Birkemosen/lune/lune-v6/docs/Manual.md

# Lune V6 Manual

Installer- and operator-facing guide for the local web UI. The `?` help in the UI links
here. Deep engineering notes stay in the other files under [`docs/`](./).

Lune V6 is a **local 6-zone hydronic manifold controller**. It stays safe without
Lune Touch: motors, endstops, temperature freshness, and command clamps run on
the device. Touch may send setpoints and weather preload; it never chooses the
zone for room temperatures.

<!-- toc -->
**[The web UI](#the-web-ui)**

**[Home](#home)**

**[Zone sheet](#zone-sheet)**

- [Settings › Comfort and Room](#settings--comfort-and-room)
- [Settings › Floor and Weather](#settings--floor-and-weather)
- [Settings › Advanced](#settings--advanced)
- [Motor fault: reset guide](#motor-fault-reset-guide)

**[Manifold sheet](#manifold-sheet)**

- [Settings › Manifold](#settings--manifold)
- [Settings › Heating mode and Heat pump limits](#settings--heating-mode-and-heat-pump-limits)
- [Settings › Preheat absorption and balancing](#settings--preheat-absorption-and-balancing)

**[System](#system)**

- [Device](#device)
- [Motors](#motors)
- [Connections](#connections)
- [Firmware and backup](#firmware-and-backup)
- [Service](#service)
- [Motor drivers: on, off and recovery](#motor-drivers-on-off-and-recovery)
- [Motor lab (dev builds)](#motor-lab-dev-builds)

**[External room temperatures (ingest)](#external-room-temperatures-ingest)**

**[Notifications through Home Assistant](#notifications-through-home-assistant)**

**[Safety principles](#safety-principles)**
<!-- /toc -->

---

## The web UI

The UI has three places, following the Lune design system:

- **Home** — what is happening now: heat, comfort per zone, faults. Nothing to save.
- **Sheets** — one per thing: a sheet per **zone** (Z1–Z6) and one for the **manifold**.
  A sheet slides in over Home and has the tabs **Overview**, **History** and **Settings**.
  Settings for that one thing live in its sheet.
- **System** — the device itself and its connections: identity, manifold and motors,
  Lune Touch and Wi-Fi, firmware and backup, service.

The **zone strip** at the top opens a zone's sheet; the **System** tile opens the manifold
sheet. The **device menu** (logo) shows identity (name, location, IP, MAC, firmware,
ESPHome, uptime), **Copy diagnostics**, and other Lune devices on the LAN.

Each settings tab and System category has one save bar at the bottom: **Undo** and **Save**.
Switches save immediately; leaving with unsaved changes asks first. Links can point
straight at a place, for example `#z3/settings` or `#system/connections`.

---

## Home

- **Status line** — number of zones, how many call for heat, faults.
- **Fault panel** — appears when a zone has a motor fault; the button opens that zone.
- **Motors are off** — appears when the motor drivers are off, with the cause
  (turned off by you, firmware update, hardware fault, start-up) and **Turn motors on**.
  See [Motor drivers](#motor-drivers-on-off-and-recovery).
- **Heat now** — manifold supply, return, ΔT, total flow and the last 24 hours.
  **Open manifold** opens the manifold sheet.
- **Comfort by zone** — temperature against target for each zone over 24 hours, with
  the loop's flow; with 8 probes also the zone's own return. A card opens the zone's sheet.

The first tile in the strip, **Manifold**, shows supply and return and opens the
manifold sheet.

The zone tiles show temperature, a chip with the distance to target (blue below,
neutral near, orange above) and the valve opening in five steps.

---

## Zone sheet

**Overview** — temperature and target (− / + saves by itself), opening, return,
motor state, preheat advance, weather offset, temperature source, and the fault panel
with the [reset guide](#motor-fault-reset-guide) when the motor has latched a fault. A grouped member zone shows
which zone it follows and opens that one; its target is locked.

**History** — the last 24 hours and a 6-hour projection.

### Settings › Comfort and Room

**Comfort**: target and **Zone enabled** (saves immediately).

**Room**: name, area and temperature source (**probe** or **BLE**, with scan and
assign). With 8 return probes, the zone's return probe is chosen here.

The floor **area** sets the zone's share of the flow, so set the real heated floor area. A
new zone has none: until it is set, the control uses the mean area of the other zones and
the problem list shows «area not set».

External Wi‑Fi room temperatures (Shelly / Home Assistant / Homey) map
`sensor_id` → zone **only on V6**. Producers never send a zone index. See
[external room temperature](./external_room_temperature.md).

### Settings › Floor and Weather

**Floor**: pipe spacing and type, slab, covering and thickness. **Weather**: exterior
walls, wind and solar factors. These feed local physics and Touch preload.

### Settings › Advanced

**Motor and calibration** (subpage): learned open/close ripples and factors, preheat
advance and the last fault (in plain words, never the raw firmware code).

**Grouping** (subpage): **Group with** merges loops into one room — shared target,
valves open together.

**Reset and relearn** (last on the tab, asks first) wipes calibration and runs
end-stop learning again — the zone will not heat normally until learning finishes.

Details: [endstop detection](./endstop_detection.md).

### Motor fault: reset guide

When a motor latches a fault, only that zone stops; the other five keep running. The
zone's Overview shows what happened in plain words and a short guide:

| Fault | What it means |
|---|---|
| The motor stalled | Stopped under load before the end stop: a stuck valve pin or a crooked actuator. |
| The motor found no end stop | Ran past its whole stroke: the actuator may not sit fully down on the valve. |
| Fault signal from the motor driver | The driver reported overcurrent while running, most often when the motor breaks loose. |
| No connection to the motor | No current: check cable and socket. |
| Motor current too high / driver too hot | Check that the pin moves freely; let the driver cool. |
| Did not reach the end stop in time | Check the actuator. |

**Before you reset**: the actuator sits fully down and straight on the valve, the cable is
fully in its socket, and the valve pin can move. Then look at the valve and choose
**The valve is**: *Closed*, *Middle*, *Open* or *Not sure*. On a normally open (NO)
manifold the valve is closed when the plunger is pressed down.

**Did the motor run too far?** If the motor pushed the plunger past the seat (*found no end
stop*) or got stuck, **Drive the motor back** runs it for 5, 10 or 20 s away from the
direction it faulted in — after an overrun while closing, that brings the plunger back up.
End-stop detection stays armed, and the zone stays blocked until you reset the fault. A
blocked zone accepts no other motor runs. Watch the plunger move, then choose where the
valve stands.

The choice is used when you press **Reset fault**:

- **Closed** or **Open** — V6 takes that as its known position. The next move runs from
  there without first driving to the end stop, so a motor that is already seated does not
  have to push against the seat again.
- **Middle** or **Not sure** — V6 re-homes towards closed before the next move, as it
  does after any fault.

A fault that clears by itself is not shown again: the first clean move after a reset (or
after a restart) removes it.

**Remembered position**: V6 stores each motor's position and uses it after a restart. Before
it opens from an unknown datum it re-homes towards closed. If the seat comes earlier than
the remembered position says, V6 takes it as the seat (the log says *seated … early*); if a
closing run passes the whole stroke without meeting the seat, the zone is blocked with
**The motor found no end stop** — check that the actuator sits on the valve. That block survives a restart, so V6 does not push another full stroke on every boot.

**Breakaway**: a motor that has stood still for a long time can draw a short current
spike when it starts, most often right after reversing from the closed seat. V6 waits
half a second between the closing and opening legs of a re-home, and a driver fault in
the first 200 ms of a run is retried up to three times per hour before the zone is
blocked. Each retry and each block is logged with which fault line fired.

---

## Manifold sheet

**Overview** — supply, return, ΔT and total flow; the **balancing** table with
the current mode; **Live readings** of every 1-Wire probe, each labelled with what it is
assigned to (a zone, the manifold's supply or return, or not assigned), so wiring can
be checked.

**History** — supply and return over the last 24 hours.

### Settings › Manifold

Valve type (**NO** / **NC**) and which 1-Wire probes measure manifold supply and
return. That drives ΔT on the manifold tile and the direction motors must run. The choice
must match the valve inserts: with **NO** the valve is open when the plunger is up;
a wrong choice makes every zone run inverted.

**Probe layout**: **2 probes** — shared supply/return on the manifold. **8 probes** —
a return sensor per zone for finer diagnostics and commissioning; assign each zone's
return in its sheet under Settings › Room. Check the wiring with **Live readings** under
Overview before saving the layout. A probe can only have one role: choosing one that a zone
or the manifold already uses is refused, and the message names who holds it.
1-Wire probes read at 12 bit (0.0625 °C).

### Settings › Heating mode and Heat pump limits

**Normal** vs **Heat pump**, plus an optional minimum total opening across
accepting loops (0 disables; normal mode only).

**Heat pump: dynamic balancing** ([design](dynamic_balancing.md)). The manifold works
like a statically balanced installation whose balancing valves follow the rooms:

- Every loop has flow all the time. Its share is its design share (the hydraulic
  balance: area, heat loss, floor, pipe, loop length, plus the learned correction).
  The most demanding loop is fully open; the others are throttled to their share.
- A room's share follows its temperature: full share one comfort band below target,
  falling to a quarter at target + **overheat margin** (default 1.0 °C).
- Inside the manifold warm rooms hand their flow to cold ones and the total stays put.
  The manifold's total follows its most demanding room: full while one room is a comfort
  band below target, less when every room on the manifold is warm.
- A loop closes only when its room is past target + comfort band + overheat margin (more
  while Touch pre-buffers), and reopens 0.3 °C below that. Its flow goes to the other
  loops. The manifold never closes every loop.
- The heat comes from the supply temperature. V6 tells Touch to **raise** it when a room
  has been below target − comfort band for 20 minutes, and to **lower** it when no room
  has been below target for 30 minutes.

With every loop open, the circulation pump sets the total flow: set it once so the
secondary flow is about 105–125 % of the heat pump's (Touch shows the buffer balance).

**Normal mode: reopening ahead.** A floor answers 1–3 hours after its valve opens, so a
closed room that waited for its thermometer would keep falling well below target. A loop
closed because its room is warm therefore reopens on the temperature *expected one floor
lag ahead*: the room's measured fall (°C/h, over 30-minute steps) times the floor lag
(about 1.5 h for 8 cm concrete, 1 h for screed, less for dry systems, plus about 0.4 h
for parquet and 0.6 h for carpet). The longer the loop has been closed, the longer the
lag counts (up to twice after 4 hours), because the slab has given up more of its heat.
The loop reopens 0.2 °C below setpoint instead of at setpoint − comfort band, after at
least 20 minutes closed. It closes again if the room turns warm (0.2 °C hysteresis). A
steady room reopens on its measured temperature.

Default local mode is heat pump.

### Settings › Preheat absorption and balancing

**Preheat absorption** (switch saves immediately) with its band and delta.

**Balancing mode**: **Static** uses only the hydraulic priors (area, pipe spacing, pipe
type, supply length). **Adaptive** also learns from how each room behaves, at most
±0.02 per hour and within 0.5–1.5 of the prior. The mode is shown on the balancing
table.

Balancing *between* manifolds (for example 20 mm PEX on one floor and 16 mm on the
other) is done by Lune Touch (house balance); the factor it sends shows as
`house_balance` and scales this manifold's openings. **Reset balancing** (last on the tab, asks first) forgets learned
factors for all zones and returns to priors.

Coordinator-owned whole-house learning (Touch / Mini) may override strategy; V6
still clamps locally. See [adaptive balancing](./adaptive_balancing.md) for the
algorithm notes.

---

## System

### Device

**Device identity**: display name and location, shown in the device menu and to Lune Touch.

**BLE clock**: when enabled, V6 continuously emits Shelly Date/Time Broadcast (~one
packet every 2 s) **concurrently with BLE scan**, so BLU displays can set their clock
without NTP. Automatic display sync is typically once per day.

**Sync now** refreshes the beacon timestamp immediately. To force a display:
press once to enter setup (`SEt`), then press twice rapidly. Bluetooth must be
on (hold ~5 s to toggle if needed).

### Motors

Motor drivers can be disabled to electrically disconnect all six actuators
(see [Motor drivers](#motor-drivers-on-off-and-recovery)). Saving this panel never
changes the drivers. Default motor profile and max run time apply until a zone has
learned its own stroke.

**Advanced** (subpages **Close end stop**, **Open end stop**, **Relearning**): expert
endstop limits in the firmware's units. They are commissioning defaults — once
learned, per-zone factors take over. **Relearn all** (last, asks first) restarts
learning for every zone.

Further reading: [endstop detection](./endstop_detection.md),
[hydraulic commissioning](./hydraulic_commissioning.md).

### Connections

**Lune Touch**: approve or revoke Touch control of this manifold. Discovery alone never
grants authority. Without approval, V6 stays fully local and conservative. The actions
shown follow the state (approve, cancel, retry, revoke); technical IDs are on a subpage.

Touch may deliver **weather preload**, **setpoints**, **absorb arming**, and a
**heating mode** override while its lease is active. Zone exposure (walls, wind,
solar) is set in each zone's sheet under Settings › Weather — not here.

**WiFi**: shows the network V6 is on and lets you move it to another one (for example
after changing the router password). Enter the network name and password and
press **Change network**. If the new network does not connect within 30 seconds,
V6 goes back to the current one. The setting survives firmware updates.

If V6 cannot reach its network at all, it opens the setup network
**Lune V6 Setup** after 5 minutes. Join it and open http://192.168.4.1 to pick a
network and enter its password.

**External room temperatures**: how BYO hubs send room temperatures — see
[below](#ingest).

### Firmware and backup

**Firmware**: check for updates, install from the network, or upload a `.bin` /
`.ota.bin`. Valves hold position across reboot (~10 s), and V6 remembers each motor's
last position, so after a restart it knows roughly how far each valve is from its seat.
An update turns the drivers off only while it installs; they come back on by themselves.
Prefer release builds for production.

**Backup**: export or import settings as JSON (import asks first). Secrets and
authority keys are never included. Learned motor ripples/factors are optional — leave
them out when moving config to a replacement board that should relearn.

### Service

**Diagnostics**: live CPU, heap and PSRAM. Task dump, I²C scan and 1-Wire dump write
into the device log for installers.

**Device logs**: streaming device log. Pause, clear or download when diagnosing faults.
Newest lines first.

**Manual motor control**: turns off automatic control of **all** zones until disabled.
Drive to a valve position, or run a timed open/close (1–45 s, subpage **Timed run**)
with endstop detection still armed. Leaving manual mode on leaves the house without
closed-loop heating.

**Device actions** (last, each asks first): **reset probe map** (re-assign every probe)
and **restart**. Identity lives under System › Device, not here.

### Motor drivers: on, off and recovery

The drivers stay on unless there is a critical fault or you turn them off.

- **One motor in fault** blocks only its own zone. The driver is re-armed after 0.1 s
  and the other zones keep running.
- **Off** happens only when a fault line stays asserted after re-arming (a short or a
  power fault), during a firmware update, or when you switch them off.
- **Recovery**: when V6 turned the drivers off itself, it tries to turn them back on,
  first after 60 s and then with doubling waits up to 30 minutes. Drivers you turned off
  stay off until you turn them on.

Home shows **Motors are off** with the cause while they are off. Diagnostics include the
cause, how long they have been off and how many recoveries have run.

### Motor lab (dev builds)

Stroke capture on one motor, development firmware only (release images hide it).

1. **Arm** pauses automatic control for every zone (manual mode) and turns the motor
   drivers on.
2. **Seat the valve** closes until the pin is seated, so the opening stroke starts from a
   known end.
3. **Record the opening stroke**, then 4. **the closing stroke**, each run for the motor
   profile's run time; end-stop detection stops the motor earlier.

**Manual move** runs a timed open or close (1–45 s) with end-stop detection on, once the
lab is armed. **Live** shows current, mean, peak, runtime, ripples, stroke phase, when the
pin was met and the drivers. The **motor current** chart covers the whole stroke: the
browser merges successive reads of the device's trace ring (~13 s) while the motor runs,
with the stroke phases underneath and cadence and slope as layers. **Download CSV** saves
the trace. **Emergency stop** stops every motor and turns the drivers off; the sequence
starts over. **Finish and resume control** turns manual mode off. Leaving the page does
not, so finish before you go.

**End stop on the stroke** replays the latest recording (or the Rev 3.3 reference trace)
through the firmware's end-stop logic, tick by tick: the current with the dynamic
threshold (dashed) and the absolute caps (dotted), a marker where each path would stop the
motor (solid for the one that stops first), the trailing rise on a closing stroke, and a
table of every path with its threshold, time and counts. It is exact about the logic, not
the noise: the firmware runs on finer frames than the trace. A recorded stroke also gives a
suggested close or open factor (**Use suggestion** puts it in the form).

The **thresholds** below (closing, opening and ceiling, absolute caps) replay in the chart
as you change them; **Save thresholds** writes only what changed to V6.

**Valve curve** shows the selected zone's flow against opening as the control uses it:
measured by Lune Touch (with the date) or the default curve, with the valve's position now.

---

## External room temperatures (ingest)

BYO hubs POST to `/api/v1/room-temperatures`. Example:

```http
POST /api/v1/room-temperatures
X-Lune-CSRF: 1
Content-Type: application/json

{"sensor_id":"living-room","celsius":21.4}
```

Full contract and hub recipes: [external room temperature](./external_room_temperature.md),
[API v1](./lv6_api_v1.md).

---

## Notifications through Home Assistant

V6 reports problems to Home Assistant, which sends them to your phone:

- **Valve**: motor fault, motor stalled, valve learning failed (after 10 min).
- **Sensor**: no room temperature for 30 min (for a zone with a probe, BLE
  sensor or external sensor set up), flow or return probe on the manifold
  missing for 30 min.
- **Battery** of a BLE sensor bound to a zone: 15 % or less (warning), 5 % or
  less (error); cleared at 25 %.
- **Humidity** from a BLE sensor bound to a zone: above 60 % or below 40 % for
  an hour; cleared at 58 % / 42 %.

Each problem is reported when it starts and when it is gone, at most once an hour.
Zones that are switched off are not reported. Without Home Assistant, V6 keeps
working as before.

To get the notifications:

1. In Home Assistant, open **Settings › Devices & services › ESPHome**, choose
   the Lune V6 device, open **Configure** and turn on **Allow the device to
   perform Home Assistant actions**. Without it, Home Assistant drops the events.
2. Import the Lune notifications blueprint from
   [`lune_notifications.yaml`](https://github.com/Birkemosen/lune-coordinator/blob/main/homeassistant/blueprints/automation/lune/lune_notifications.yaml) (see [`homeassistant/README.md`](https://github.com/Birkemosen/lune-coordinator/blob/main/homeassistant/README.md))
   and choose who gets which kind of problem.

The device also shows **Active problems** (count) and **Problems** (titles) as
entities, so a dashboard can show them without the blueprint. Texts are in Danish
for now. Contract: [notifications contract v1](../../shared/contracts/lune_notifications_contract_v1.md).

---

## Safety principles

1. V6 validates and clamps every command locally.
2. Stale room temperatures fail safe (valves conservative / maintenance).
3. Touch and hubs never pick the zone for a temperature sample — only `sensor_id`
   mapping on V6 does.
4. Destructive actions stay behind confirmation; identity stays in System › Device.

For firmware architecture and FreeRTOS layout see [ARCHITECTURE.md](./ARCHITECTURE.md).
