Birkemosen/lune/lune-v6/test/fixtures/motor-lab-z1-close-soft-seat-a.csv

t_ms | motion_count | current_ma | adc_current_raw | drive_on | direction_open | armed | stroke_phase | tacho_period_us | tacho_amp_raw
250 | 20 | 23.8 | 505.6666666666667 | 1 | 0 | 1 | 0 | 24858.97435897436 | 1210.4102564102564
750 | 65 | 23.3 | 495.72727272727275 | 1 | 0 | 1 | 0 | 11584.415584415585 | 1834.3116883116884
1250 | 109 | 23.1 | 490.1898734177215 | 1 | 0 | 1 | 0 | 11402.93670886076 | 2298.2911392405063
1750 | 153 | 23.0 | 488.78205128205127 | 1 | 0 | 1 | 0 | 11331.153846153846 | 2151.474358974359
2250 | 198 | 22.9 | 484.88461538461536 | 1 | 0 | 1 | 0 | 11418.78205128205 | 1997.9358974358975
2750 | 245 | 22.9 | 483.63157894736844 | 1 | 0 | 1 | 0 | 11456 | 2531.5789473684213
3250 | 292 | 22.9 | 477.8253968253968 | 1 | 0 | 1 | 0 | 11015.809523809523 | 1859.5555555555557
3750 | 336 | 22.9 | 487.06349206349205 | 1 | 0 | 1 | 0 | 11103.174603174602 | 2374.5873015873017
4250 | 382 | 22.9 | 487.875 | 1 | 0 | 1 | 0 | 11359.375 | 2103.671875
4750 | 426 | 22.8 | 488.03225806451616 | 1 | 0 | 1 | 0 | 11403.209677419354 | 2351.016129032258
5250 | 472 | 22.8 | 482.61290322580646 | 1 | 0 | 1 | 0 | 11079.241935483871 | 2264.016129032258
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
