Birkemosen/lune/lune-v6/test/fixtures/motor-lab-z1-close.csv

t_ms | motion_count | current_ma | adc_current_raw | drive_on | direction_open | armed | stroke_phase | tacho_period_us | tacho_amp_raw | bemf_raw_a | bemf_raw_b | bemf_differential_raw | bemf_separation_us | bemf_valid | bemf_moving | invalid_bemf_samples
250 | 23 | 24.8 | 524.921052631579 | 1 | 0 | 1 | 2 | 16578.947368421053 | 1465.157894736842 | 65535 | 65535 | 0 | 65535 | 0 | 0 | 0
750 | 66 | 24.4 | 518.9873417721519 | 1 | 0 | 1 | 2 | 11518.987341772152 | 2093.506329113924 | 65535 | 65535 | 0 | 65535 | 0 | 0 | 0
1250 | 109 | 24.3 | 515.3589743589744 | 1 | 0 | 1 | 2 | 12243.589743589744 | 2194.5128205128203 | 65535 | 65535 | 0 | 65535 | 0 | 0 | 0
1750 | 144 | 24.3 | 515.3846153846154 | 1 | 0 | 1 | 2 | 14679.48717948718 | 2319.6794871794873 | 65535 | 65535 | 0 | 65535 | 0 | 0 | 0
2250 | 179 | 24.2 | 513.1538461538462 | 1 | 0 | 1 | 2 | 15769.23076923077 | 2208.2820512820513 | 65535 | 65535 | 0 | 65535 | 0 | 0 | 0
2750 | 221 | 24.2 | 512.4871794871794 | 1 | 0 | 1 | 2 | 12179.48717948718 | 2251.75641025641 | 65535 | 65535 | 0 | 65535 | 0 | 0 | 0
3250 | 262 | 24.3 | 514.3333333333334 | 1 | 0 | 1 | 2 | 14166.666666666666 | 2289.1666666666665 | 65535 | 65535 | 0 | 65535 | 0 | 0 | 0
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
