Birkemosen/lune/(list of files, drawings)

Other design files:
lune-v6/hardware/lune-v6-rev3.3/EasyEdaPro/lune-v6-rev3.3.eprj
