Birkemosen/lune/lune-v6/components/lv6_dashboard/lv6_dashboard.cpp

#include "lv6_dashboard.h"
#include "control_summary.h"
#include <lwip/sockets.h>
#include "../lv6_zone_controller/absorb_command_logic.h"
#include "../lv6_zone_controller/hydraulic_diagnostics.h"
#include "../lv6_zone_controller/probe_mapping.h"
#include "../lv6_zone_controller/thermal_model.h"
#include "../lv6_config_store/group_model.h"
#include "esphome/components/lv6_ble_time_beacon/lv6_ble_time_beacon.h"
#include "esphome/components/nimble_hub/nimble_hub.h"
#include "settings_backup.h"
#ifdef USE_ESP32_CRASH_HANDLER
#include "esphome/components/esp32/crash_handler.h"
#endif

#include "esphome/core/log.h"
#include "esphome/core/version.h"
#ifdef USE_LOGGER
#include "esphome/components/logger/logger.h"
#endif
#include "esphome/components/wifi/wifi_component.h"
#ifdef USE_LUNE_WIFI
#include "esphome/components/lune_wifi/lune_wifi.h"
#endif
#ifdef USE_CAPTIVE_PORTAL
#include "esphome/components/captive_portal/captive_portal.h"
#endif
#include <algorithm>
#include <cctype>
#include <cmath>
#include <cstdio>
#include <cstdlib>
#include <cstring>
#include <cstdarg>
#include <ctime>
#include <new>
#include <esp_http_server.h>
#include <esp_heap_caps.h>
#include <esp_system.h>
#if defined(CONFIG_HEAP_TRACING_STANDALONE) || defined(CONFIG_HEAP_TRACING)
#include <esp_heap_trace.h>
#include <esp_memory_utils.h>
#endif

namespace esphome {
namespace lv6_dashboard {

static const char *const TAG = "lv6_dashboard";
static constexpr size_t STATIC_CHUNK_SIZE = 2048;

namespace {

/// Large scratch: PSRAM first, internal heap as fallback. free() routes back to
/// the correct heap for either allocation.
void *alloc_scratch(size_t bytes) {
  void *p = heap_caps_malloc(bytes, MALLOC_CAP_SPIRAM);
  return p != nullptr ? p : malloc(bytes);
}

// Append formatted text without ever committing a truncated write. A partial
// vsnprintf into a chunk buffer used to leave a NUL mid-payload; chunked HTTP
// then shipped that NUL and the dashboard failed to parse /api/v1/state.
bool appendfv(char *buffer, size_t capacity, size_t &offset, const char *fmt, va_list args) {
  if (offset >= capacity)
    return false;

  va_list probe;
  va_copy(probe, args);
  const int need = vsnprintf(nullptr, 0, fmt, probe);
  va_end(probe);
  if (need < 0)
    return false;
  // Keep one byte for the C terminator vsnprintf writes; it is not part of offset.
  if (offset + static_cast<size_t>(need) >= capacity)
    return false;

  const int written = vsnprintf(buffer + offset, capacity - offset, fmt, args);
  if (written < 0 || written != need)
    return false;

  offset += static_cast<size_t>(written);
  return true;
}

bool appendf(char *buffer, size_t capacity, size_t &offset, const char *fmt, ...) {
  va_list args;
  va_start(args, fmt);
  const bool ok = appendfv(buffer, capacity, offset, fmt, args);
  va_end(args);
  return ok;
}

// Every code `send_v1_` can emit must appear here: an unmapped code silently
// becomes 500, and the dashboard branches on the exact status. A missing 403
// masked CSRF rejection as a server error.
const char *http_status_line(int code) {
  switch (code) {
    case 200: return "200 OK";
    case 204: return "204 No Content";
    case 400: return "400 Bad Request";
    case 403: return "403 Forbidden";
    case 404: return "404 Not Found";
    case 405: return "405 Method Not Allowed";
    case 409: return "409 Conflict";
    case 429: return "429 Too Many Requests";
    case 503: return "503 Service Unavailable";
    default: return "500 Internal Server Error";
  }
}

bool is_dashboard_js_url(const char *url) {
  if (url == nullptr) return false;
  static constexpr const char PATHS[][16] = {"/dashboard.js", "/binder.js"};
  for (const char *path : PATHS) {
    const size_t path_len = strlen(path);
    if (strncmp(url, path, path_len) == 0 && (url[path_len] == '\0' || url[path_len] == '?'))
      return true;
  }
  return false;
}

bool is_ui_css_url(const char *url) {
  static constexpr const char PATH[] = "/lune-ui.css";
  static constexpr size_t PATH_LEN = sizeof(PATH) - 1;
  return url != nullptr && strncmp(url, PATH, PATH_LEN) == 0 &&
         (url[PATH_LEN] == '\0' || url[PATH_LEN] == '?');
}

bool is_lang_html_url(const char *url, const char *lang) {
  if (url == nullptr || lang == nullptr) return false;
  char path[8];
  snprintf(path, sizeof(path), "/%s/", lang);
  const size_t path_len = strlen(path);
  if (strncmp(url, path, path_len) == 0)
    return url[path_len] == '\0' || strcmp(url + path_len, "index.html") == 0 ||
           url[path_len] == '?';
  // Also accept /en and /da without trailing slash.
  char bare[6];
  snprintf(bare, sizeof(bare), "/%s", lang);
  return strcmp(url, bare) == 0;
}

const char *pick_ui_lang(AsyncWebServerRequest *request) {
  const auto cookie = request->get_header("Cookie");
  if (cookie.has_value()) {
    const char *c = strstr(cookie->c_str(), "lune_lang=");
    if (c != nullptr) {
      c += 10;
      if (strncmp(c, "da", 2) == 0) return "da";
      if (strncmp(c, "en", 2) == 0) return "en";
    }
  }
  const auto accept = request->get_header("Accept-Language");
  if (accept.has_value()) {
    const char *a = accept->c_str();
    const char *da = strstr(a, "da");
    const char *en = strstr(a, "en");
    if (da && (!en || da < en)) return "da";
  }
  return "en";
}


// Append `s` as the body of a JSON string (without surrounding quotes),
// escaping the characters JSON requires. Control chars become spaces.
void append_json_escaped(char *buffer, size_t capacity, size_t &offset, const char *s) {
  for (const char *p = s; p != nullptr && *p != '\0'; ++p) {
    if (offset + 2 >= capacity)
      return;
    const unsigned char c = static_cast<unsigned char>(*p);
    if (c == '"' || c == '\\') {
      buffer[offset++] = '\\';
      buffer[offset++] = static_cast<char>(c);
    } else if (c < 0x20) {
      buffer[offset++] = ' ';
    } else {
      buffer[offset++] = static_cast<char>(c);
    }
  }
}

void format_float_token(char *buffer, size_t capacity, float value, int decimals = 1) {
  if (!std::isfinite(value)) {
    snprintf(buffer, capacity, "null");
    return;
  }

  long scale = 1;
  for (int i = 0; i < decimals; i++)
    scale *= 10;

  const long scaled = lroundf(value * static_cast<float>(scale));
  const long whole = scaled / scale;
  const long fraction = std::labs(scaled % scale);

  if (decimals <= 0) {
    snprintf(buffer, capacity, "%ld", whole);
    return;
  }

  char frac_fmt[8];
  snprintf(frac_fmt, sizeof(frac_fmt), "%%0%dld", decimals);
  char frac_buf[16];
  snprintf(frac_buf, sizeof(frac_buf), frac_fmt, fraction);
  snprintf(buffer, capacity, "%ld.%s", whole, frac_buf);
}

void format_pairing_fingerprint(const char *mac, char *buffer, size_t capacity) {
  if (capacity == 0)
    return;
  size_t off = 0;
  off += snprintf(buffer + off, capacity - off, "lv6-");
  for (const char *p = mac; p != nullptr && *p != '\0' && off + 1 < capacity; ++p) {
    char c = *p;
    if (c >= 'A' && c <= 'F')
      c = static_cast<char>(c - 'A' + 'a');
    if ((c >= '0' && c <= '9') || (c >= 'a' && c <= 'f'))
      buffer[off++] = c;
  }
  buffer[off] = '\0';
  if (std::strcmp(buffer, "lv6-") == 0)
    std::strncpy(buffer, "lv6-unknown", capacity - 1);
  buffer[capacity - 1] = '\0';
}

void sanitize_text(const std::string &src, char *buffer, size_t capacity) {
  if (capacity == 0)
    return;

  size_t out = 0;
  for (size_t i = 0; i < src.size() && out + 1 < capacity; i++) {
    const char c = src[i];
    buffer[out++] = (c == '"' || c == '\\') ? '_' : c;
  }
  buffer[out] = '\0';
}

// --- minimal JSON field extractors for POST body ---

static bool json_get_str(const char *body, const char *field, char *out, size_t out_len) {
  char pat[48];
  snprintf(pat, sizeof(pat), "\"%s\"", field);
  const char *p = strstr(body, pat);
  if (!p) return false;
  p += strlen(pat);
  while (*p == ' ') p++;
  if (*p != ':') return false;
  p++;
  while (*p == ' ') p++;
  if (*p != '"') return false;
  p++;
  const char *end = strchr(p, '"');
  if (!end) return false;
  const size_t len = std::min(static_cast<size_t>(end - p), out_len - 1);
  memcpy(out, p, len);
  out[len] = '\0';
  return true;
}

static bool json_get_num(const char *body, const char *field, float *out) {
  char pat[48];
  snprintf(pat, sizeof(pat), "\"%s\"", field);
  const char *p = strstr(body, pat);
  if (!p) return false;
  p += strlen(pat);
  while (*p == ' ') p++;
  if (*p != ':') return false;
  p++;
  while (*p == ' ') p++;
  if (*p == '"' || *p == '{' || *p == '[') return false;
  char *end;
  const float v = strtof(p, &end);
  if (end == p) return false;
  *out = v;
  return true;
}

static bool json_get_u32(const char *body, const char *field, uint32_t *out) {
  char pat[48];
  snprintf(pat, sizeof(pat), "\"%s\"", field);
  const char *p = strstr(body, pat);
  if (!p) return false;
  p += strlen(pat);
  while (*p == ' ') p++;
  if (*p != ':') return false;
  p++;
  return lv6_authority::parse_u32_text(p, out);
}

static bool json_get_bool(const char *body, const char *field, bool *out) {
  char pat[48];
  snprintf(pat, sizeof(pat), "\"%s\"", field);
  const char *p = strstr(body, pat);
  if (!p) return false;
  p += strlen(pat);
  while (*p == ' ') p++;
  if (*p != ':') return false;
  p++;
  while (*p == ' ') p++;
  if (strncmp(p, "true", 4) == 0) {
    *out = true;
    return true;
  }
  if (strncmp(p, "false", 5) == 0) {
    *out = false;
    return true;
  }
  float num = 0.0f;
  if (json_get_num(body, field, &num)) {
    *out = std::fabs(num) > 0.001f;
    return true;
  }
  return false;
}

// --- string → enum parsers ---

static bool parse_probe_option(const char *raw, int8_t *out) {
  if (strcasecmp(raw, "None") == 0) { *out = lv6::PROBE_UNASSIGNED; return true; }
  int n = 0;
  if (sscanf(raw, "Probe %d", &n) == 1 && n >= 1 && n <= static_cast<int>(lv6::MAX_PROBES)) {
    *out = static_cast<int8_t>(n - 1);
    return true;
  }
  return false;
}

static bool parse_temp_source(const char *raw, lv6::TempSource *out) {
  if (strcasecmp(raw, "Local Probe") == 0 || strcasecmp(raw, "probe") == 0) {
    *out = lv6::TempSource::LOCAL_PROBE;
    return true;
  }
  if (strcasecmp(raw, "BLE") == 0 || strcasecmp(raw, "BLE Sensor") == 0) {
    *out = lv6::TempSource::BLE_SENSOR;
    return true;
  }
  if (strcasecmp(raw, "External") == 0 || strcasecmp(raw, "EXTERNAL") == 0 ||
      strcasecmp(raw, "External (Wi-Fi)") == 0 || strcasecmp(raw, "External (Wi‑Fi)") == 0) {
    *out = lv6::TempSource::EXTERNAL;
    return true;
  }
  return false;
}

static const char *device_display_name_cstr(const lv6::SystemConfig &sys) {
  return sys.display_name[0] != '\0' ? sys.display_name : "Lune V6";
}

static void json_escape_cstr(const char *in, char *out, size_t out_len) {
  if (out_len == 0)
    return;
  size_t o = 0;
  for (size_t i = 0; in[i] != '\0' && o < out_len - 2; i++) {
    char c = in[i];
    if (c == '"' || c == '\\') {
      if (o + 2 >= out_len)
        break;
      out[o++] = '\\';
    }
    out[o++] = (c >= 0x20) ? c : ' ';
  }
  out[o] = '\0';
}

static const char *temp_source_to_dashboard_str(lv6::TempSource src) {
  switch (src) {
    case lv6::TempSource::LOCAL_PROBE:
      return "Local Probe";
    case lv6::TempSource::BLE_SENSOR:
      return "BLE";
    case lv6::TempSource::EXTERNAL:
      return "External";
    default:
      return "Local Probe";
  }
}

static const char *pipe_type_to_api_str(lv6::PipeType type) {
  switch (type) {
    case lv6::PipeType::PEX_12X2: return "PEX_12X2";
    case lv6::PipeType::PEX_14X2: return "PEX_14X2";
    case lv6::PipeType::PEX_16X2: return "PEX_16X2";
    case lv6::PipeType::PEX_17X2: return "PEX_17X2";
    case lv6::PipeType::PEX_18X2: return "PEX_18X2";
    case lv6::PipeType::PEX_20X2: return "PEX_20X2";
    case lv6::PipeType::ALUPEX_16X2: return "ALUPEX_16X2";
    case lv6::PipeType::ALUPEX_20X2: return "ALUPEX_20X2";
    default: return "UNKNOWN";
  }
}

static const char *motor_profile_to_api_str(lv6::MotorProfile profile) {
  switch (profile) {
    case lv6::MotorProfile::INHERIT: return "INHERIT";
    case lv6::MotorProfile::GENERIC: return "GENERIC";
    case lv6::MotorProfile::HMIP_VDMOT: return "HMIP_VDMOT";
    default: return "UNKNOWN";
  }
}

static bool parse_pipe_type(const char *raw, lv6::PipeType *out) {
  struct { const char *s; lv6::PipeType v; } map[] = {
    {"PEX 12mm", lv6::PipeType::PEX_12X2}, {"PEX 12x2", lv6::PipeType::PEX_12X2},
    {"PEX 14mm", lv6::PipeType::PEX_14X2}, {"PEX 14x2", lv6::PipeType::PEX_14X2},
    {"PEX 16mm", lv6::PipeType::PEX_16X2}, {"PEX 16x2", lv6::PipeType::PEX_16X2},
    {"PEX 17mm", lv6::PipeType::PEX_17X2}, {"PEX 17x2", lv6::PipeType::PEX_17X2},
    {"PEX 18mm", lv6::PipeType::PEX_18X2}, {"PEX 18x2", lv6::PipeType::PEX_18X2},
    {"PEX 20mm", lv6::PipeType::PEX_20X2}, {"PEX 20x2", lv6::PipeType::PEX_20X2},
    {"ALUPEX 16mm", lv6::PipeType::ALUPEX_16X2}, {"ALUPEX 16x2", lv6::PipeType::ALUPEX_16X2},
    {"ALUPEX 20mm", lv6::PipeType::ALUPEX_20X2}, {"ALUPEX 20x2", lv6::PipeType::ALUPEX_20X2},
  };
  for (const auto &e : map) {
    if (strcasecmp(raw, e.s) == 0) { *out = e.v; return true; }
  }
  return false;
}

static bool parse_motor_profile(const char *raw, lv6::MotorProfile *out) {
  if (strcasecmp(raw, "Inherit") == 0) { *out = lv6::MotorProfile::INHERIT; return true; }
  if (strcasecmp(raw, "Generic") == 0) { *out = lv6::MotorProfile::GENERIC; return true; }
  if (strcasecmp(raw, "HmIP VdMot") == 0 || strcasecmp(raw, "HMIP_VDMOT") == 0) { *out = lv6::MotorProfile::HMIP_VDMOT; return true; }
  return false;
}

}  // namespace

#ifndef LV6_DASHBOARD_ASSET_V
#define LV6_DASHBOARD_ASSET_V "dev"
#endif
#ifndef LV6_UI_ASSET_V
#define LV6_UI_ASSET_V LV6_DASHBOARD_ASSET_V
#endif

// Legacy fallback shell used only when LDS2 HTML assets are not embedded.
static const char DASHBOARD_HTML_FALLBACK[] =
    "<!doctype html><html><head>"
    "<meta charset=\"utf-8\">"
    "<meta name=\"viewport\" content=\"width=device-width,initial-scale=1\">"
    "<meta name=\"color-scheme\" content=\"light dark\">"
    "<link rel=\"icon\" href=\"data:,\">"
    "<title>Lune V6</title>"
    "<link rel=\"stylesheet\" href=\"/lune-ui.css?v=" LV6_UI_ASSET_V "\">"
    "</head><body>"
    "<p>Dashboard UI assets missing. Run <code>make dashboard-build</code>.</p>"
    "<script src=\"/binder.js?v=" LV6_DASHBOARD_ASSET_V "\"></script>"
    "</body></html>";

void LV6Dashboard::update_snapshot_() {
  // This function runs on ESPHome's loopTask.  DashboardSnapshot is several
  // kilobytes and used to be allocated here alongside temporary DeviceConfig
  // copies, exhausting loopTask during boot on 4 MB modules.  Reuse the
  // component-owned scratch buffer instead; it is never read by HTTP handlers.
  DashboardSnapshot &s = this->update_snap_buf_;
  memset(&s, 0, sizeof(s));

  s.uptime_s = millis() / 1000UL;
  // System diagnostics — per-core CPU load (sampled in loop()) + live heap.
  s.cpu0_pct = cpu0_pct_;
  s.cpu1_pct = cpu1_pct_;
  s.free_internal_kb = heap_caps_get_free_size(MALLOC_CAP_INTERNAL) / 1024;
  s.free_dma_kb = heap_caps_get_free_size(MALLOC_CAP_DMA) / 1024;
  s.largest_internal_kb = heap_caps_get_largest_free_block(MALLOC_CAP_INTERNAL) / 1024;
  s.min_internal_kb = heap_caps_get_minimum_free_size(MALLOC_CAP_INTERNAL) / 1024;
  s.free_psram_kb = heap_caps_get_free_size(MALLOC_CAP_SPIRAM) / 1024;
  s.largest_psram_kb = heap_caps_get_largest_free_block(MALLOC_CAP_SPIRAM) / 1024;
  {
    multi_heap_info_t info{};
    heap_caps_get_info(&info, MALLOC_CAP_INTERNAL);
    s.internal_allocated_kb = info.total_allocated_bytes / 1024;
    s.internal_free_blocks = info.free_blocks;
    s.internal_alloc_blocks = info.allocated_blocks;
  }

  if (this->nimble_hub_) {
    s.ble_hub_enabled = this->nimble_hub_->is_enabled();
    s.ble_scanning = this->nimble_hub_->scanning();
    s.ble_ads_per_sec = this->nimble_hub_->ads_per_sec();
    s.ble_last_adv_age_ms = this->nimble_hub_->last_adv_age_ms();
  }

  auto snap_float = [](sensor::Sensor *sns) -> float {
    return (sns && sns->has_state()) ? sns->state : NAN;
  };

  s.wifi_dbm          = snap_float(this->wifi_signal_sensor_);
  s.manifold_flow_c   = snap_float(this->manifold_flow_sensor_);
  s.manifold_return_c = snap_float(this->manifold_return_sensor_);
  for (uint8_t i = 0; i < 6; i++) {
    s.zone_temp_c[i]        = snap_float(this->zone_temp_sensors_[i]);
    s.zone_valve_pct[i]     = snap_float(this->zone_valve_sensors_[i]);
    s.zone_preheat_c[i]     = snap_float(this->zone_preheat_sensors_[i]);
    s.motor_open_ripple[i]  = snap_float(this->motor_open_ripple_sensors_[i]);
    s.motor_close_ripple[i] = snap_float(this->motor_close_ripple_sensors_[i]);
    s.motor_open_factor[i]  = snap_float(this->motor_open_factor_sensors_[i]);
    s.motor_close_factor[i] = snap_float(this->motor_close_factor_sensors_[i]);
    s.motor_working_ripple[i] = NAN;
    s.motor_pin_free_ripple[i] = NAN;
    s.motor_stroke_model[i] = 0;
    s.motor_learn_pct[i] = 0;
    s.motor_learn_phase[i] = 0;
    s.motor_learn_sample[i] = 0;
    s.motor_learn_samples_needed[i] = 0;
  }
  // Prefer live valve telemetry over the 10 s ESPHome template sensors so the
  // zone UI updates as soon as a relearn finishes (or fails).
  if (this->valve_controller_) {
    uint16_t fault_fp = 0;
    for (uint8_t i = 0; i < 6; i++) {
      const auto t = this->valve_controller_->get_telemetry(i);
      s.motor_open_ripple[i] = static_cast<float>(t.learned_open_ripples);
      s.motor_close_ripple[i] = static_cast<float>(t.learned_close_ripples);
      s.motor_open_factor[i] = t.learned_open_current_factor;
      s.motor_close_factor[i] = t.learned_close_current_factor;
      s.motor_working_ripple[i] = static_cast<float>(t.contact_to_stop_close_ripples);
      s.motor_pin_free_ripple[i] = static_cast<float>(t.pin_engage_close_ripples);
      s.motor_stroke_model[i] = static_cast<uint8_t>(t.stroke_model);
      const char *fault = lv6::fault_code_to_string(t.last_fault_code);
      std::strncpy(s.motor_fault[i], fault, sizeof(s.motor_fault[i]) - 1);
      s.motor_fault[i][sizeof(s.motor_fault[i]) - 1] = '\0';
      fault_fp = static_cast<uint16_t>((fault_fp * 33u) ^ static_cast<uint8_t>(t.last_fault_code));
    }
    if (fault_fp != this->last_motor_fault_fp_) {
      this->last_motor_fault_fp_ = fault_fp;
      if (this->runtime_revision_ != UINT32_MAX)
        this->runtime_revision_++;
    }
    const auto lp = this->valve_controller_->get_learning_progress();
    if (lp.zone < 6) {
      s.motor_learn_pct[lp.zone] = lp.pct;
      s.motor_learn_phase[lp.zone] = lp.phase;
      s.motor_learn_sample[lp.zone] = lp.sample;
      s.motor_learn_samples_needed[lp.zone] = lp.samples_needed;
    }
    const uint32_t packed = this->valve_controller_->get_learning_progress_packed();
    if (packed != this->last_learning_progress_packed_) {
      this->last_learning_progress_packed_ = packed;
      if (this->runtime_revision_ != UINT32_MAX)
        this->runtime_revision_++;
    }
  }
  for (uint8_t i = 0; i < 8; i++)
    s.probe_temp_c[i] = snap_float(this->probe_temp_sensors_[i]);

  auto snap_text = [](text_sensor::TextSensor *ts, char *out, size_t len) {
    if (ts && ts->has_state()) {
      sanitize_text(ts->state, out, len);
    } else {
      out[0] = '\0';
    }
  };
  snap_text(this->firmware_version_text_, s.firmware_version, sizeof(s.firmware_version));
  snap_text(this->ip_address_text_,       s.ip_address,       sizeof(s.ip_address));
  snap_text(this->connected_ssid_text_,   s.connected_ssid,   sizeof(s.connected_ssid));
  snap_text(this->mac_address_text_,      s.mac_address,      sizeof(s.mac_address));
  snap_text(this->reset_reason_text_,     s.reset_reason,     sizeof(s.reset_reason));
  for (uint8_t i = 0; i < 6; i++) {
    snap_text(this->zone_state_sensors_[i],  s.zone_state[i],  sizeof(s.zone_state[i]));
    // motor_fault[] is filled from live valve telemetry above when available.
    if (!this->valve_controller_)
      snap_text(this->motor_fault_sensors_[i], s.motor_fault[i], sizeof(s.motor_fault[i]));
  }

  s.drivers_enabled = this->valve_controller_ && this->valve_controller_->are_drivers_enabled();
  s.drivers_off_reason = this->valve_controller_ ? this->valve_controller_->drivers_off_reason() : "";
  s.drivers_off_age_s = this->valve_controller_ ? this->valve_controller_->drivers_off_age_s() : 0;
  s.drivers_recoveries = this->valve_controller_ ? this->valve_controller_->drivers_recoveries() : 0;

  // Touch authority is local coordination state only; heat-source transport is
  // owned by Lune Touch. Expiry is checked here so stale leases stop gating
  // local command handling without a second background task.
  if (this->config_store_) {
    s.authority = this->config_store_->get_authority_config();
    this->authority_.configure(s.authority.installation_id, s.authority.coordinator_id);
    this->authority_.expire_if_needed(millis());
    if (this->zone_controller_) {
      const auto auth_snap = this->authority_.snapshot(millis());
      this->zone_controller_->set_touch_authority_active(auth_snap.touch_lease_active);
      if (auth_snap.touch_lease_active && auth_snap.control_mode != lv6_authority::ControlMode::UNSET) {
        const auto mode = (auth_snap.control_mode == lv6_authority::ControlMode::NORMAL)
                              ? lv6::HeatingProfile::NORMAL
                              : lv6::HeatingProfile::HEAT_PUMP;
        this->zone_controller_->set_touch_control_mode(true, mode);
      } else {
        this->zone_controller_->set_touch_control_mode(false, lv6::HeatingProfile::HEAT_PUMP);
      }
    }
  }
  const auto authority_snapshot = this->authority_.snapshot(millis());
  strncpy(s.authority_state, lv6_authority::state_name(authority_snapshot.state), sizeof(s.authority_state) - 1);
  strncpy(s.authority_reason, authority_snapshot.last_reason, sizeof(s.authority_reason) - 1);
  s.authority_lease_remaining_s = authority_snapshot.remaining_ms / 1000UL;
  s.authority_generation = authority_snapshot.lease_generation;
  s.authority_v6_write_allowed = false;
  s.authority_state[sizeof(s.authority_state) - 1] = '\0';
  s.authority_reason[sizeof(s.authority_reason) - 1] = '\0';

  if (this->config_store_) {
    s.system                 = this->config_store_->get_config().system;
    s.probes                 = this->config_store_->get_probe_config();
    s.motor                  = this->config_store_->get_motor_config();
    s.manifold_type          = this->config_store_->get_manifold_type();
    s.simple_preheat_enabled = this->config_store_->get_simple_preheat_enabled();
    const auto ctrl_cfg = this->config_store_->get_config().control;
    s.preheat_absorb_enabled = ctrl_cfg.preheat_absorb_enabled;
    s.preheat_absorb_band_c  = ctrl_cfg.preheat_absorb_band_c;
    s.preheat_detect_delta_c = ctrl_cfg.preheat_detect_delta_c;
    s.heating_mode = ctrl_cfg.mode;
    s.hp_overheat_margin_c = ctrl_cfg.hp_overheat_margin_c;
    s.hp_base_pct = ctrl_cfg.hp_base_pct;
    s.hp_trim_floor_pct = ctrl_cfg.hp_trim_floor_pct;
    s.hp_close_above_c = ctrl_cfg.hp_close_above_c;
    s.hp_demand_pct = ctrl_cfg.hp_demand_pct;
    s.preheat_absorbing = this->zone_controller_ && this->zone_controller_->is_preheat_absorbing();
    s.absorb_mode = this->zone_controller_ ? this->zone_controller_->absorb_mode_code() : 0;
    if (this->zone_controller_) {
      std::strncpy(s.absorb_reason, this->zone_controller_->absorb_arm_reason(),
                   sizeof(s.absorb_reason) - 1);
      s.absorb_reason[sizeof(s.absorb_reason) - 1] = '\0';
      std::strncpy(s.absorb_end_reason, this->zone_controller_->absorb_arm_end_reason(),
                   sizeof(s.absorb_end_reason) - 1);
      s.absorb_end_reason[sizeof(s.absorb_end_reason) - 1] = '\0';
    } else {
      s.absorb_reason[0] = '\0';
      s.absorb_end_reason[0] = '\0';
    }
    if (this->zone_controller_) {
      s.effective_heating_mode = this->zone_controller_->get_effective_control_mode();
      s.heating_mode_from_touch = this->zone_controller_->is_touch_authority_active() &&
                                  this->zone_controller_->has_touch_control_mode();
      s.heat_demand = this->zone_controller_->get_heat_demand();
    } else {
      s.effective_heating_mode = ctrl_cfg.mode;
      s.heating_mode_from_touch = false;
      s.heat_demand = {};
    }
    for (uint8_t i = 0; i < lv6::NUM_ZONES; i++) {
      if (this->zone_controller_) {
        s.zone_loop_share_pct[i] = this->zone_controller_->get_loop_share_pct(i);
        s.zone_house_balance[i] = this->zone_controller_->get_house_balance(i);
        s.zone_absorb_capacity_rank[i] = this->zone_controller_->get_absorb_capacity_rank(i);
        s.zone_relative_kv[i] =
            this->zone_controller_->get_relative_kv(i, s.zone_valve_pct[i]);
        const auto zs = this->zone_controller_->get_zone_snapshot(i);
        s.zone_static_factor[i] = zs.static_factor;
        s.zone_balance_adapt[i] = zs.balance_adapt;
        s.zone_hydraulic_factor[i] = zs.hydraulic_factor;
      } else {
        s.zone_loop_share_pct[i] = NAN;
        s.zone_house_balance[i] = 1.0f;
        s.zone_absorb_capacity_rank[i] = 0;
        s.zone_relative_kv[i] = NAN;
        s.zone_static_factor[i] = NAN;
        s.zone_balance_adapt[i] = 1.0f;
        s.zone_hydraulic_factor[i] = NAN;
      }
    }
    s.authority              = this->config_store_->get_authority_config();
    s.balancing              = this->config_store_->get_config().balancing;
    s.min_zone_flow_pct      = s.balancing.secondary_min_total_opening_pct;
    s.minimum_flow_always    = s.balancing.secondary_flow_commissioning_enabled;
    for (uint8_t i = 0; i < lv6::NUM_ZONES; i++) {
      s.zones[i]            = this->config_store_->get_zone_config(i);
      s.zone_temp_source[i] = this->config_store_->get_zone_temp_source(i);
      this->config_store_->get_zone_ble_mac_str(i, s.zone_ble_mac[i], sizeof(s.zone_ble_mac[i]));
      const auto &sc = this->config_store_->get_config().sensor_config;
      strncpy(s.zone_sensor_id[i], sc.zone_sensor_id[i], sizeof(s.zone_sensor_id[i]) - 1);
      s.zone_sensor_id[i][sizeof(s.zone_sensor_id[i]) - 1] = '\0';
      strncpy(s.zone_sensor_name[i], sc.zone_sensor_name[i], sizeof(s.zone_sensor_name[i]) - 1);
      s.zone_sensor_name[i][sizeof(s.zone_sensor_name[i]) - 1] = '\0';
      s.zone_external_temp_age_ms[i] =
          this->zone_controller_ ? this->zone_controller_->get_zone_external_temp_age_ms(i)
                                 : UINT32_MAX;
      s.zone_battery_pct[i] =
          this->zone_controller_ ? this->zone_controller_->get_zone_battery_pct(i) : -1;
      s.zone_humidity_pct[i] =
          this->zone_controller_ ? this->zone_controller_->get_zone_humidity_pct(i) : NAN;
      if (s.zone_temp_source[i] == lv6::TempSource::BLE_SENSOR)
        s.ble_demanded = true;
    }
    if (this->config_store_->get_config().sensor_config.ble_clock_sync_enabled)
      s.ble_demanded = true;
  }

  if (this->ble_time_beacon_) {
    s.ble_clock_sync_enabled = this->ble_time_beacon_->enabled();
    s.ble_clock_sync_interval_min = this->ble_time_beacon_->interval_min();
    s.ble_clock_sync_last_ok_s = this->ble_time_beacon_->last_ok_s();
    strncpy(s.ble_clock_sync_last_error, this->ble_time_beacon_->last_error(),
            sizeof(s.ble_clock_sync_last_error) - 1);
    s.ble_clock_sync_last_error[sizeof(s.ble_clock_sync_last_error) - 1] = '\0';
    s.ble_clock_sync_advertising = this->ble_time_beacon_->advertising();
  } else if (this->config_store_) {
    const auto sensors = this->config_store_->get_config().sensor_config;
    s.ble_clock_sync_enabled = sensors.ble_clock_sync_enabled;
    s.ble_clock_sync_interval_min = sensors.ble_clock_sync_interval_min;
  }

  // Managed firmware update. The snapshot was memset above, so the status
  // string is always written here rather than relying on its member default.
  strncpy(s.firmware_update_status, "unknown", sizeof(s.firmware_update_status) - 1);
#ifdef LV6_HAS_UPDATE
  if (this->firmware_update_ != nullptr) {
    const char *status = "unknown";
    switch (this->firmware_update_->state) {
      case update::UPDATE_STATE_NO_UPDATE:  status = "no_update";  break;
      case update::UPDATE_STATE_AVAILABLE:  status = "available";  break;
      case update::UPDATE_STATE_INSTALLING: status = "installing"; break;
      default:                              status = "unknown";    break;
    }
    strncpy(s.firmware_update_status, status, sizeof(s.firmware_update_status) - 1);
    s.firmware_update_available = this->firmware_update_->state == update::UPDATE_STATE_AVAILABLE;
    sanitize_text(this->firmware_update_->update_info.current_version, s.firmware_update_current,
                  sizeof(s.firmware_update_current));
    sanitize_text(this->firmware_update_->update_info.latest_version, s.firmware_update_latest,
                  sizeof(s.firmware_update_latest));
  }
#endif
  s.firmware_update_status[sizeof(s.firmware_update_status) - 1] = '\0';

  // Notify the dashboard only when displayable live values change. Quantize so
  // sub-display noise does not bump runtime_revision every snapshot tick.
  {
    auto mix = [](uint32_t h, uint32_t v) -> uint32_t {
      h ^= v + 0x9e3779b9u + (h << 6) + (h >> 2);
      return h;
    };
    auto q_dc = [](float c) -> uint32_t {
      if (!std::isfinite(c)) return 0x7FFFu;
      long v = lroundf(c * 10.0f);  // 0.1 °C
      if (v < -2000) v = -2000;
      if (v > 2000) v = 2000;
      return static_cast<uint32_t>(v + 2000);
    };
    auto q_pct = [](float p) -> uint32_t {
      if (!std::isfinite(p)) return 0xFFu;
      long v = lroundf(p);
      if (v < 0) v = 0;
      if (v > 100) v = 100;
      return static_cast<uint32_t>(v);
    };
    uint32_t fp = 2166136261u;
    fp = mix(fp, q_dc(s.manifold_flow_c));
    fp = mix(fp, q_dc(s.manifold_return_c));
    for (uint8_t i = 0; i < 6; i++) {
      fp = mix(fp, q_dc(s.zone_temp_c[i]));
      fp = mix(fp, q_pct(s.zone_valve_pct[i]));
      fp = mix(fp, q_dc(s.zone_preheat_c[i]));
      // Zone state string → cheap length + first byte (enough for idle/heating/fault flips).
      fp = mix(fp, static_cast<uint32_t>(s.zone_state[i][0]) |
                       (static_cast<uint32_t>(strnlen(s.zone_state[i], 16)) << 8));
    }
    // Learning progress already bumps runtime_revision_ separately above —
    // keep it out of this fingerprint so idle clients are not woken every %.
    if (fp != this->last_live_telemetry_fp_) {
      this->last_live_telemetry_fp_ = fp;
      if (this->runtime_revision_ != UINT32_MAX)
        this->runtime_revision_++;
    }
  }

  if (xSemaphoreTake(snapshot_lock_, pdMS_TO_TICKS(5)) == pdTRUE) {
    memcpy(&this->snapshot_, &s, sizeof(s));
    this->snapshot_ready_ = true;
    xSemaphoreGive(snapshot_lock_);
  }
}

#if defined(CONFIG_HEAP_TRACING_STANDALONE) || defined(CONFIG_HEAP_TRACING)
// TEMPORARY — remove with packages/debug/heap-tracing.yaml after investigation.
//
// ESP-IDF heap_trace_dump() prints only via esp_rom_printf (UART ROM path). That
// bypasses ESPHome's logger callback, so dashboard / live-log views show the
// "--- heap_trace_dump ---" banner and then nothing. We dump through ESP_LOGI
// instead, skip malloc/heap_caps wrapper frames when picking an owner PC, and
// print a sample multi-frame PC stack for each top INTERNAL site.

namespace {

// Depth 8 → ~88 B/record with standalone TAILQ; 768 × 88 ≈ 66 KB in PSRAM.
constexpr size_t kHeapTraceRecords = 768;
constexpr size_t kHeapTraceTopSites = 24;
constexpr size_t kHeapTraceTopAllocs = 16;
constexpr uintptr_t kHeapWrapperWindow = 0x800;  // ~2 KB past each wrapper symbol

struct HeapTraceSiteAgg {
  void *owner_pc{nullptr};
  size_t bytes{0};
  size_t count{0};
  size_t max_bytes{0};
  void *sample_stack[CONFIG_HEAP_TRACING_STACK_DEPTH]{};
};

// Thin wrappers that usually own alloced_by[0] (and sometimes [1]) on Xtensa.
// Return addresses land a few bytes past the call site inside these functions.
extern "C" {
void *heap_caps_malloc(size_t size, uint32_t caps);
void *heap_caps_calloc(size_t n, size_t size, uint32_t caps);
void *heap_caps_realloc(void *ptr, size_t size, uint32_t caps);
void *heap_caps_aligned_alloc(size_t alignment, size_t size, uint32_t caps);
void *heap_caps_malloc_prefer(size_t size, size_t num, ...);
void *heap_caps_calloc_prefer(size_t n, size_t size, size_t num, ...);
void *pvPortMalloc(size_t xWantedSize);
void *__wrap_heap_caps_malloc_base(size_t size, uint32_t caps);
void *__wrap_heap_caps_realloc_base(void *ptr, size_t size, uint32_t caps);
void *__wrap_heap_caps_aligned_alloc_base(size_t alignment, size_t size, uint32_t caps);
}

bool pc_in_wrapper_window_(void *pc, void *fn) {
  if (pc == nullptr || fn == nullptr)
    return false;
  const uintptr_t p = reinterpret_cast<uintptr_t>(pc);
  const uintptr_t s = reinterpret_cast<uintptr_t>(fn);
  return p >= s && p < s + kHeapWrapperWindow;
}

bool is_heap_wrapper_pc_(void *pc) {
  if (pc == nullptr)
    return false;
  // malloc/calloc/realloc come from <cstdlib> / newlib — compare by address.
  return pc_in_wrapper_window_(pc, reinterpret_cast<void *>(heap_caps_malloc)) ||
         pc_in_wrapper_window_(pc, reinterpret_cast<void *>(heap_caps_calloc)) ||
         pc_in_wrapper_window_(pc, reinterpret_cast<void *>(heap_caps_realloc)) ||
         pc_in_wrapper_window_(pc, reinterpret_cast<void *>(heap_caps_aligned_alloc)) ||
         pc_in_wrapper_window_(pc, reinterpret_cast<void *>(heap_caps_malloc_prefer)) ||
         pc_in_wrapper_window_(pc, reinterpret_cast<void *>(heap_caps_calloc_prefer)) ||
         pc_in_wrapper_window_(pc, reinterpret_cast<void *>(malloc)) ||
         pc_in_wrapper_window_(pc, reinterpret_cast<void *>(calloc)) ||
         pc_in_wrapper_window_(pc, reinterpret_cast<void *>(realloc)) ||
         pc_in_wrapper_window_(pc, reinterpret_cast<void *>(pvPortMalloc)) ||
         pc_in_wrapper_window_(pc, reinterpret_cast<void *>(__wrap_heap_caps_malloc_base)) ||
         pc_in_wrapper_window_(pc, reinterpret_cast<void *>(__wrap_heap_caps_realloc_base)) ||
         pc_in_wrapper_window_(pc, reinterpret_cast<void *>(__wrap_heap_caps_aligned_alloc_base));
}

void *owner_pc_from_stack_(void *const *stack) {
  void *first = nullptr;
  for (int i = 0; i < CONFIG_HEAP_TRACING_STACK_DEPTH; i++) {
    void *pc = stack[i];
    if (pc == nullptr)
      break;
    if (first == nullptr)
      first = pc;
    if (!is_heap_wrapper_pc_(pc))
      return pc;
  }
  return first;  // all wrappers / empty — still attribute somewhere
}

void copy_alloc_stack_(void *dst[CONFIG_HEAP_TRACING_STACK_DEPTH],
                       void *const src[CONFIG_HEAP_TRACING_STACK_DEPTH]) {
  for (int i = 0; i < CONFIG_HEAP_TRACING_STACK_DEPTH; i++)
    dst[i] = src[i];
}

void format_pc_stack_(char *buf, size_t buf_len, void *const *stack) {
  if (buf_len == 0)
    return;
  buf[0] = '\0';
  size_t off = 0;
  for (int i = 0; i < CONFIG_HEAP_TRACING_STACK_DEPTH; i++) {
    if (stack[i] == nullptr)
      break;
    const int n = snprintf(buf + off, buf_len - off, "%s%p", (i == 0) ? "" : ":", stack[i]);
    if (n < 0 || static_cast<size_t>(n) >= buf_len - off)
      break;
    off += static_cast<size_t>(n);
  }
  if (off == 0)
    snprintf(buf, buf_len, "(none)");
}

void dump_heap_trace_via_logger_() {
  heap_trace_summary_t summary{};
  esp_err_t sum_err = heap_trace_summary(&summary);
  if (sum_err != ESP_OK) {
    ESP_LOGE(TAG, "heap_trace_summary failed: %s (tracing never init/started?)",
             esp_err_to_name(sum_err));
    return;
  }

  // Stop so LEAKS-mode iteration does not skip entries mid-dump; resume after.
  const bool was_running = (heap_trace_stop() == ESP_OK);

  ESP_LOGI(TAG,
           "heap_trace summary: mode=%s records=%u/%u high_water=%u overflow=%s "
           "total_alloc=%u total_free=%u stack_depth=%d",
           summary.mode == HEAP_TRACE_ALL ? "ALL" : "LEAKS", (unsigned) summary.count,
           (unsigned) summary.capacity, (unsigned) summary.high_water_mark,
           summary.has_overflowed ? "yes" : "no", (unsigned) summary.total_allocations,
           (unsigned) summary.total_frees, CONFIG_HEAP_TRACING_STACK_DEPTH);

  const size_t n = heap_trace_get_count();
  if (n == 0) {
    ESP_LOGW(TAG, "heap_trace: 0 outstanding records — nothing to attribute "
                  "(start failed, buffer empty, or all traced allocs already freed)");
    if (was_running)
      heap_trace_resume();
    return;
  }

  std::vector<HeapTraceSiteAgg> sites;
  sites.reserve(64);
  size_t internal_bytes = 0;
  size_t internal_count = 0;
  size_t psram_bytes = 0;
  size_t psram_count = 0;
  size_t other_bytes = 0;
  size_t other_count = 0;

  // Power-of-two size histogram for INTERNAL outstanding allocs.
  static constexpr size_t kHistEdges[] = {16, 32, 64, 128, 256, 512, 1024, 2048, 4096, 8192};
  static constexpr size_t kHistBuckets = (sizeof(kHistEdges) / sizeof(kHistEdges[0])) + 1;
  size_t hist_count[kHistBuckets]{};
  size_t hist_bytes[kHistBuckets]{};

  struct LargeAlloc {
    size_t size;
    void *addr;
    void *owner_pc;
    void *stack[CONFIG_HEAP_TRACING_STACK_DEPTH];
  };
  LargeAlloc largest[kHeapTraceTopAllocs]{};
  size_t largest_n = 0;

  for (size_t i = 0; i < n; i++) {
    heap_trace_record_t rec{};
    if (heap_trace_get(i, &rec) != ESP_OK || rec.address == nullptr || rec.freed)
      continue;

    if (esp_ptr_external_ram(rec.address)) {
      psram_bytes += rec.size;
      psram_count++;
      continue;
    }
    if (!esp_ptr_internal(rec.address)) {
      other_bytes += rec.size;
      other_count++;
      continue;
    }

    internal_bytes += rec.size;
    internal_count++;

    size_t bucket = kHistBuckets - 1;
    for (size_t b = 0; b < sizeof(kHistEdges) / sizeof(kHistEdges[0]); b++) {
      if (rec.size <= kHistEdges[b]) {
        bucket = b;
        break;
      }
    }
    hist_count[bucket]++;
    hist_bytes[bucket] += rec.size;

    void *owner = owner_pc_from_stack_(rec.alloced_by);
    bool found = false;
    for (auto &s : sites) {
      if (s.owner_pc == owner) {
        s.bytes += rec.size;
        s.count++;
        if (rec.size > s.max_bytes) {
          s.max_bytes = rec.size;
          copy_alloc_stack_(s.sample_stack, rec.alloced_by);
        }
        found = true;
        break;
      }
    }
    if (!found) {
      HeapTraceSiteAgg s;
      s.owner_pc = owner;
      s.bytes = rec.size;
      s.count = 1;
      s.max_bytes = rec.size;
      copy_alloc_stack_(s.sample_stack, rec.alloced_by);
      sites.push_back(s);
    }

    // Track largest individual INTERNAL allocs (insertion into fixed top-N).
    size_t insert_at = largest_n;
    for (size_t k = 0; k < largest_n; k++) {
      if (rec.size > largest[k].size) {
        insert_at = k;
        break;
      }
    }
    if (insert_at < kHeapTraceTopAllocs) {
      size_t move_n = largest_n < kHeapTraceTopAllocs ? largest_n : (kHeapTraceTopAllocs - 1);
      for (size_t k = move_n; k > insert_at; k--)
        largest[k] = largest[k - 1];
      largest[insert_at].size = rec.size;
      largest[insert_at].addr = rec.address;
      largest[insert_at].owner_pc = owner;
      copy_alloc_stack_(largest[insert_at].stack, rec.alloced_by);
      if (largest_n < kHeapTraceTopAllocs)
        largest_n++;
    }
  }

  ESP_LOGI(TAG,
           "heap_trace caps split: INTERNAL %uB in %u allocs | PSRAM %uB in %u | other %uB in %u",
           (unsigned) internal_bytes, (unsigned) internal_count, (unsigned) psram_bytes,
           (unsigned) psram_count, (unsigned) other_bytes, (unsigned) other_count);

  ESP_LOGI(TAG, "--- INTERNAL size histogram ---");
  for (size_t b = 0; b < kHistBuckets; b++) {
    if (hist_count[b] == 0)
      continue;
    if (b == 0) {
      ESP_LOGI(TAG, "  <=%4u B: %u allocs, %u B", (unsigned) kHistEdges[0],
               (unsigned) hist_count[b], (unsigned) hist_bytes[b]);
    } else if (b < kHistBuckets - 1) {
      ESP_LOGI(TAG, "  <=%4u B: %u allocs, %u B", (unsigned) kHistEdges[b],
               (unsigned) hist_count[b], (unsigned) hist_bytes[b]);
    } else {
      ESP_LOGI(TAG, "   >%4u B: %u allocs, %u B",
               (unsigned) kHistEdges[kHistBuckets - 2], (unsigned) hist_count[b],
               (unsigned) hist_bytes[b]);
    }
  }

  std::sort(sites.begin(), sites.end(),
            [](const HeapTraceSiteAgg &a, const HeapTraceSiteAgg &b) { return a.bytes > b.bytes; });

  char stack_buf[CONFIG_HEAP_TRACING_STACK_DEPTH * 12];
  const size_t show = std::min(sites.size(), kHeapTraceTopSites);
  ESP_LOGI(TAG,
           "--- top INTERNAL alloc sites by total size (owner PC skips heap_caps/malloc) ---");
  for (size_t i = 0; i < show; i++) {
    format_pc_stack_(stack_buf, sizeof(stack_buf), sites[i].sample_stack);
    ESP_LOGI(TAG, "  #%02u %6u B ×%u (max %u B) owner=%p", (unsigned) (i + 1),
             (unsigned) sites[i].bytes, (unsigned) sites[i].count, (unsigned) sites[i].max_bytes,
             sites[i].owner_pc);
    ESP_LOGI(TAG, "       stack=%s", stack_buf);
  }
  if (show == 0)
    ESP_LOGW(TAG, "  (no INTERNAL outstanding records in buffer)");

  ESP_LOGI(TAG, "--- largest INTERNAL allocs ---");
  for (size_t i = 0; i < largest_n; i++) {
    format_pc_stack_(stack_buf, sizeof(stack_buf), largest[i].stack);
    ESP_LOGI(TAG, "  #%02u %6u B @ %p owner=%p", (unsigned) (i + 1), (unsigned) largest[i].size,
             largest[i].addr, largest[i].owner_pc);
    ESP_LOGI(TAG, "       stack=%s", stack_buf);
  }

  if (summary.has_overflowed) {
    ESP_LOGW(TAG, "heap_trace buffer overflowed — oldest sites dropped; bump kHeapTraceRecords");
  }

  if (was_running) {
    esp_err_t r = heap_trace_resume();
    if (r != ESP_OK)
      ESP_LOGW(TAG, "heap_trace_resume failed: %s", esp_err_to_name(r));
  }
}

}  // namespace

void start_heap_tracing_early() {
  static bool started = false;
  if (started)
    return;

  // Prefer PSRAM so INTERNAL stays available for the owners we attribute
  // (ISR allocs may not be recorded when the buffer is external).
  const char *buf_where = "PSRAM";
  heap_trace_record_t *records = static_cast<heap_trace_record_t *>(heap_caps_calloc(
      kHeapTraceRecords, sizeof(heap_trace_record_t), MALLOC_CAP_SPIRAM | MALLOC_CAP_8BIT));
  if (records == nullptr) {
    buf_where = "INTERNAL";
    records = static_cast<heap_trace_record_t *>(heap_caps_calloc(
        kHeapTraceRecords, sizeof(heap_trace_record_t), MALLOC_CAP_INTERNAL | MALLOC_CAP_8BIT));
  }
  if (records == nullptr) {
    ESP_LOGE(TAG, "heap_trace INIT FAILED: record buffer alloc failed (%u × %u B)",
             (unsigned) kHeapTraceRecords, (unsigned) sizeof(heap_trace_record_t));
    return;
  }

  esp_err_t err = heap_trace_init_standalone(records, kHeapTraceRecords);
  if (err != ESP_OK) {
    ESP_LOGE(TAG, "heap_trace INIT FAILED: heap_trace_init_standalone: %s", esp_err_to_name(err));
    heap_caps_free(records);
    return;
  }

  // LEAKS mode keeps outstanding allocs only — right tool for "who holds INTERNAL".
  err = heap_trace_start(HEAP_TRACE_LEAKS);
  if (err != ESP_OK) {
    ESP_LOGE(TAG, "heap_trace INIT FAILED: heap_trace_start: %s", esp_err_to_name(err));
    return;
  }

  started = true;
  const unsigned buf_kb =
      (unsigned) ((kHeapTraceRecords * sizeof(heap_trace_record_t) + 1023) / 1024);
  ESP_LOGW(TAG,
           "heap_trace STARTED ok: mode=HEAP_TRACE_LEAKS records=%u (~%u KB in %s) "
           "stack_depth=%d — Dump task stats prints INTERNAL top sites via logger",
           (unsigned) kHeapTraceRecords, buf_kb, buf_where, CONFIG_HEAP_TRACING_STACK_DEPTH);
}
#endif

LV6Dashboard::~LV6Dashboard() {
  if (this->json_buf_ != nullptr) {
    free(this->json_buf_);
    this->json_buf_ = nullptr;
  }
}

void LV6Dashboard::setup() {
#if defined(CONFIG_HEAP_TRACING_STANDALONE) || defined(CONFIG_HEAP_TRACING)
  // Fallback if on_boot priority 900 did not run (or package omitted init).
  start_heap_tracing_early();
#endif

  if (this->base_ == nullptr) {
    ESP_LOGE(TAG, "web_server_base is null; dashboard handler not registered");
    return;
  }

  this->json_buf_ = static_cast<char *>(alloc_scratch(JSON_BUF_SIZE));
  if (this->json_buf_ == nullptr) {
    ESP_LOGE(TAG, "Failed to allocate %u-byte JSON buffer (SPIRAM/INTERNAL); JSON API disabled",
             static_cast<unsigned>(JSON_BUF_SIZE));
    this->mark_failed();
    return;
  }
  ESP_LOGI(TAG, "JSON buffer: %u bytes in PSRAM/INTERNAL", static_cast<unsigned>(JSON_BUF_SIZE));

  this->action_lock_ = xSemaphoreCreateMutex();
  this->snapshot_lock_ = xSemaphoreCreateMutex();
  this->history_lock_ = xSemaphoreCreateMutex();
  if (!this->logs_.init())
    ESP_LOGW(TAG, "Log rings unavailable; /logs will be empty");

#ifdef USE_LOGGER
  // Tap the ESPHome logger so the dashboard Logs view can stream device logs.
  // The callback runs on arbitrary tasks; it must stay non-blocking (see on_log_).
  if (logger::global_logger != nullptr)
    logger::global_logger->add_log_callback(this, &LV6Dashboard::on_log_static_);
#ifdef USE_ESP32_CRASH_HANDLER
  // The logger printed the previous boot's crash before this callback existed;
  // print it again so the lines land in crash_lines_ (and the log ring).
  if (esp32::crash_handler_has_data()) {
    this->crash_lines_ = static_cast<char (*)[CRASH_LINE_LEN]>(
        alloc_scratch(static_cast<size_t>(CRASH_LINES) * CRASH_LINE_LEN));
    if (this->crash_lines_ != nullptr)
      esp32::crash_handler_log();
  }
#endif
#endif

  // Prime snapshot so the first GET doesn't return 503.
  this->update_snapshot_();
  this->snapshot_last_ms_ = millis();

  this->base_->init();
  this->base_->add_handler(this);
  ESP_LOGI(TAG, "Dashboard endpoints registered: /, /en/, /da/, /lune-ui.css, /binder.js");
}

// =============================================================================
// FreeRTOS runtime diagnostics (CONFIG_FREERTOS_GENERATE_RUN_TIME_STATS)
// =============================================================================

void LV6Dashboard::sample_cpu_load_() {
  UBaseType_t count = uxTaskGetNumberOfTasks();
  if (count == 0)
    return;
  task_status_buf_.resize(count + 4);  // headroom for tasks spawned mid-call
  uint32_t total_runtime = 0;
  UBaseType_t got = uxTaskGetSystemState(task_status_buf_.data(),
                                         (UBaseType_t) task_status_buf_.size(), &total_runtime);
  if (got == 0)
    return;

  uint32_t idle0 = 0, idle1 = 0;
  for (UBaseType_t i = 0; i < got; i++) {
    const char *name = task_status_buf_[i].pcTaskName;
    if (name == nullptr)
      continue;
    if (strcmp(name, "IDLE0") == 0 || strcmp(name, "IDLE") == 0)
      idle0 = task_status_buf_[i].ulRunTimeCounter;
    else if (strcmp(name, "IDLE1") == 0)
      idle1 = task_status_buf_[i].ulRunTimeCounter;
  }

  // Need a previous sample, and skip the cycle when the run-time counter wrapped.
  if (cpu_last_total_ > 0 && total_runtime > cpu_last_total_) {
    float dt = (float) (total_runtime - cpu_last_total_);
    float c0 = 100.0f - (float) (idle0 - cpu_last_idle0_) / dt * 100.0f;
    float c1 = 100.0f - (float) (idle1 - cpu_last_idle1_) / dt * 100.0f;
    cpu0_pct_ = std::max(0.0f, std::min(100.0f, c0));
    cpu1_pct_ = std::max(0.0f, std::min(100.0f, c1));
  }
  cpu_last_total_ = total_runtime;
  cpu_last_idle0_ = idle0;
  cpu_last_idle1_ = idle1;
}

void LV6Dashboard::dump_heap_cap_(const char *label, uint32_t caps) const {
  multi_heap_info_t info{};
  heap_caps_get_info(&info, caps);
  ESP_LOGI(TAG,
           "heap[%s]: free=%uB alloc=%uB largest_free=%uB min_free=%uB "
           "free_blocks=%u alloc_blocks=%u total_blocks=%u",
           label, (unsigned) info.total_free_bytes, (unsigned) info.total_allocated_bytes,
           (unsigned) info.largest_free_block, (unsigned) info.minimum_free_bytes,
           (unsigned) info.free_blocks, (unsigned) info.allocated_blocks,
           (unsigned) info.total_blocks);
  // ESP-IDF walks each heap region and prints free/used ranges — the tool for
  // seeing *which* banks are empty vs fragmented (not which call site owns bytes).
  heap_caps_print_heap_info(caps);
}

void LV6Dashboard::dump_task_stats_() {
  UBaseType_t count = uxTaskGetNumberOfTasks();
  if (count == 0)
    return;
  task_status_buf_.resize(count + 4);
  uint32_t total_runtime = 0;
  UBaseType_t got = uxTaskGetSystemState(task_status_buf_.data(),
                                         (UBaseType_t) task_status_buf_.size(), &total_runtime);
  if (got == 0 || total_runtime == 0)
    return;

  ESP_LOGI(TAG,
           "--- task stats: %u tasks | core0=%.0f%% core1=%.0f%% | "
           "heap int=%uKB dma=%uKB largest_int=%uKB min_int=%uKB psram=%uKB largest_psram=%uKB ---",
           (unsigned) got, cpu0_pct_, cpu1_pct_,
           (unsigned) (heap_caps_get_free_size(MALLOC_CAP_INTERNAL) / 1024),
           (unsigned) (heap_caps_get_free_size(MALLOC_CAP_DMA) / 1024),
           (unsigned) (heap_caps_get_largest_free_block(MALLOC_CAP_INTERNAL) / 1024),
           (unsigned) (heap_caps_get_minimum_free_size(MALLOC_CAP_INTERNAL) / 1024),
           (unsigned) (heap_caps_get_free_size(MALLOC_CAP_SPIRAM) / 1024),
           (unsigned) (heap_caps_get_largest_free_block(MALLOC_CAP_SPIRAM) / 1024));
  // ulRunTimeCounter is the lifetime counter, so cpu% here is the since-boot
  // average per task (the live per-core figures above cover "now"). stack_free
  // is the lifetime minimum free stack — a small value flags near-overflow.
  for (UBaseType_t i = 0; i < got; i++) {
    const TaskStatus_t &t = task_status_buf_[i];
    float pct = (float) t.ulRunTimeCounter / (float) total_runtime * 100.0f;
    ESP_LOGI(TAG, "  %-16s pri=%2u cpu=%5.1f%% stack_free=%uB",
             t.pcTaskName ? t.pcTaskName : "?", (unsigned) t.uxCurrentPriority, pct,
             (unsigned) (t.usStackHighWaterMark * sizeof(StackType_t)));
  }

  ESP_LOGI(TAG, "--- heap caps (INTERNAL / DMA / SPIRAM) ---");
  this->dump_heap_cap_("INTERNAL", MALLOC_CAP_INTERNAL);
  this->dump_heap_cap_("DMA", MALLOC_CAP_DMA);
  this->dump_heap_cap_("SPIRAM", MALLOC_CAP_SPIRAM);
#if defined(CONFIG_HEAP_TRACING_STANDALONE) || defined(CONFIG_HEAP_TRACING)
  // Opt-in debug builds only (packages/debug/heap-tracing.yaml). Do NOT call
  // heap_trace_dump() here — it uses esp_rom_printf and never reaches the
  // ESPHome logger / dashboard Logs view.
  ESP_LOGI(TAG, "--- heap_trace INTERNAL sites (CONFIG_HEAP_TRACING*) ---");
  dump_heap_trace_via_logger_();
#endif
}

void LV6Dashboard::loop() {
  if (action_lock_ == nullptr)
    return;

  std::vector<DashboardAction> todo;
  if (xSemaphoreTake(action_lock_, pdMS_TO_TICKS(10)) == pdTRUE) {
    if (!action_queue_.empty()) {
      todo = action_queue_;
      action_queue_.clear();
    }
    xSemaphoreGive(action_lock_);
  }
  for (const auto &act : todo) {
    dispatch_set_(act);
    if (data_revision_ != UINT32_MAX)
      data_revision_++;
  }
  this->expire_coordinator_commands_();

  // Update snapshot at 1 Hz (int32_t cast for millis() rollover safety).
  const uint32_t now = millis();
  // Sample per-core CPU load every 2 s (needs two samples before it reports).
  if ((int32_t)(now - cpu_last_sample_ms_) >= (int32_t)CPU_SAMPLE_INTERVAL_MS) {
    cpu_last_sample_ms_ = now;
    sample_cpu_load_();
  }
  if ((int32_t)(now - snapshot_last_ms_) >= (int32_t)SNAPSHOT_INTERVAL_MS) {
    snapshot_last_ms_ = now;
    update_snapshot_();
  }

  // Sample zone-state history every 5 minutes.
  if ((int32_t)(now - history_last_sample_ms_) >= (int32_t)HISTORY_INTERVAL_MS) {
    history_last_sample_ms_ = now;
    sample_history_();
  }
}

static constexpr const char V1_PREFIX[] = "/api/v1";
static constexpr size_t V1_PREFIX_LEN = sizeof(V1_PREFIX) - 1;

bool LV6Dashboard::canHandle(AsyncWebServerRequest *request) const {
  char url_buf[AsyncWebServerRequest::URL_BUF_SIZE];
  auto url = request->url_to(url_buf);
#ifdef USE_CAPTIVE_PORTAL
  // In the fallback AP the stock captive portal (network list + password form)
  // must win "/"; it is registered after this handler.
  if (url == "/" && captive_portal::global_captive_portal != nullptr &&
      captive_portal::global_captive_portal->is_active())
    return false;
#endif
  if (url == "/" || url == "/dashboard" || url == "/dashboard/" || is_dashboard_js_url(url.c_str()) ||
      is_ui_css_url(url.c_str()) || is_lang_html_url(url.c_str(), "en") ||
      is_lang_html_url(url.c_str(), "da"))
    return true;
  return strncmp(url.c_str(), V1_PREFIX, V1_PREFIX_LEN) == 0 && url.c_str()[V1_PREFIX_LEN] == '/';
}

void LV6Dashboard::handleBody(AsyncWebServerRequest *request, uint8_t *data, size_t len, size_t index,
                              size_t total) {
  if (index == 0) {
    this->post_body_.clear();
    if (total > 0 && total <= POST_BODY_MAX)
      this->post_body_.reserve(total);
  }
  if (data == nullptr || len == 0)
    return;
  if (this->post_body_.size() + len > POST_BODY_MAX) {
    this->post_body_.clear();
    return;
  }
  this->post_body_.append(reinterpret_cast<const char *>(data), len);
}

void LV6Dashboard::handleRequest(AsyncWebServerRequest *request) {
  char url_buf[AsyncWebServerRequest::URL_BUF_SIZE];
  auto url = request->url_to(url_buf);

  if (url == "/dashboard" || url == "/dashboard/") {
    httpd_req_t *req = *request;
    httpd_resp_set_status(req, "308 Permanent Redirect");
    httpd_resp_set_hdr(req, "Location", "/");
    httpd_resp_set_hdr(req, "Cache-Control", "no-store");
    httpd_resp_send(req, nullptr, 0);
    return;
  }
  if (url == "/") {
    this->handle_root_(request);
    return;
  }
  if (is_lang_html_url(url.c_str(), "en")) {
    this->handle_ui_html_(request, "en", true);
    return;
  }
  if (is_lang_html_url(url.c_str(), "da")) {
    this->handle_ui_html_(request, "da", true);
    return;
  }
  if (is_ui_css_url(url.c_str())) {
    this->handle_ui_css_(request);
    return;
  }
  if (is_dashboard_js_url(url.c_str())) {
    this->handle_js_(request);
    return;
  }
  if (strncmp(url.c_str(), V1_PREFIX, V1_PREFIX_LEN) == 0 && url.c_str()[V1_PREFIX_LEN] == '/') {
    this->handle_v1_(request, url.c_str() + V1_PREFIX_LEN);
    return;
  }

  send_text_(request, 404, "text/plain", "Not found");
}

void LV6Dashboard::handle_root_(AsyncWebServerRequest *request) {
  this->handle_ui_html_(request, pick_ui_lang(request), false);
}

void LV6Dashboard::handle_ui_html_(AsyncWebServerRequest *request, const char *lang, bool set_cookie) {
  httpd_req_t *req = *request;
  static char cookie_hdr[48];
  if (set_cookie && lang != nullptr) {
    snprintf(cookie_hdr, sizeof(cookie_hdr), "lune_lang=%s; Path=/; Max-Age=31536000", lang);
    httpd_resp_set_hdr(req, "Set-Cookie", cookie_hdr);
  }
#if defined(LV6_HAS_UI_HTML_DA) || defined(LV6_HAS_UI_HTML_EN)
  const bool want_da = lang != nullptr && strncmp(lang, "da", 2) == 0;
#ifdef LV6_HAS_UI_HTML_DA
  if (want_da) {
    send_gzip_chunked_(request, "text/html; charset=utf-8", LV6_UI_HTML_DA_DATA, LV6_UI_HTML_DA_SIZE,
                       "no-store, no-cache, max-age=0, must-revalidate");
    return;
  }
#endif
#ifdef LV6_HAS_UI_HTML_EN
  send_gzip_chunked_(request, "text/html; charset=utf-8", LV6_UI_HTML_EN_DATA, LV6_UI_HTML_EN_SIZE,
                     "no-store, no-cache, max-age=0, must-revalidate");
  return;
#endif
#endif
  send_text_(request, 200, "text/html; charset=utf-8", DASHBOARD_HTML_FALLBACK, false,
             "no-store, no-cache, max-age=0, must-revalidate");
}

void LV6Dashboard::handle_ui_css_(AsyncWebServerRequest *request) {
#ifdef LV6_HAS_UI_CSS
  send_gzip_chunked_(request, "text/css; charset=utf-8", LV6_UI_CSS_DATA, LV6_UI_CSS_SIZE,
                     "no-store, no-cache, max-age=0, must-revalidate");
#else
  send_text_(request, 404, "text/plain", "lune-ui.css not configured. Run make dashboard-build.");
#endif
}

void LV6Dashboard::handle_js_(AsyncWebServerRequest *request) {
#ifdef LV6_HAS_DASHBOARD_JS
  send_gzip_chunked_(request, "application/javascript; charset=utf-8",
                     LV6_DASHBOARD_JS_DATA, LV6_DASHBOARD_JS_SIZE,
                     "no-store, no-cache, max-age=0, must-revalidate");
#else
  send_text_(request, 404, "text/plain",
             "binder.js not configured. Add binder_js: ../web/ui/binder.js to lv6_dashboard.");
#endif
}

void LV6Dashboard::send_text_(AsyncWebServerRequest *request, int code, const char *content_type,
                              const char *body, bool cors, const char *cache_control) {
  if (request == nullptr)
    return;
  httpd_req_t *req = *request;
  httpd_resp_set_status(req, http_status_line(code));
  httpd_resp_set_type(req, content_type);
  httpd_resp_set_hdr(req, "Connection", "close");
  if (cache_control != nullptr)
    httpd_resp_set_hdr(req, "Cache-Control", cache_control);
  // Browser reads are same-origin. Deliberately do not emit wildcard CORS:
  // custom write headers are part of the CSRF boundary.
  (void) cors;
  httpd_resp_send(req, body != nullptr ? body : "", HTTPD_RESP_USE_STRLEN);
}

void LV6Dashboard::send_gzip_chunked_(AsyncWebServerRequest *request, const char *content_type,
                                      const uint8_t *data, size_t length,
                                      const char *cache_control) {
  if (request == nullptr || data == nullptr)
    return;
  httpd_req_t *req = *request;
  httpd_resp_set_status(req, "200 OK");
  httpd_resp_set_type(req, content_type);
  httpd_resp_set_hdr(req, "Content-Encoding", "gzip");
  httpd_resp_set_hdr(req, "Connection", "close");
  if (cache_control != nullptr)
    httpd_resp_set_hdr(req, "Cache-Control", cache_control);

  size_t offset = 0;
  while (offset < length) {
    const size_t to_send = std::min(STATIC_CHUNK_SIZE, length - offset);
    if (httpd_resp_send_chunk(req, reinterpret_cast<const char *>(data + offset), to_send) != ESP_OK)
      return;
    offset += to_send;
  }
  httpd_resp_send_chunk(req, nullptr, 0);
}

void LV6Dashboard::handle_state_(AsyncWebServerRequest *request) {
  if (snapshot_lock_ == nullptr || !snapshot_ready_ ||
      xSemaphoreTake(snapshot_lock_, pdMS_TO_TICKS(50)) != pdTRUE) {
    httpd_req_t *req_err = *request;
    httpd_resp_set_status(req_err, "503 Service Unavailable");
    httpd_resp_set_type(req_err, "text/plain");
    httpd_resp_set_hdr(req_err, "Connection", "close");
    httpd_resp_send(req_err, "Snapshot not ready", HTTPD_RESP_USE_STRLEN);
    return;
  }
  memcpy(&this->state_snap_buf_, &this->snapshot_, sizeof(this->state_snap_buf_));
  xSemaphoreGive(snapshot_lock_);

  DashboardSnapshot *snap = &this->state_snap_buf_;

  httpd_req_t *req = *request;
  httpd_resp_set_status(req, "200 OK");
  httpd_resp_set_type(req, "application/json");
  httpd_resp_set_hdr(req, "Cache-Control", "no-cache");
  httpd_resp_set_hdr(req, "Connection", "close");

  constexpr size_t BUF_SIZE = 2048;
  char *buf = this->json_buf_;
  size_t offset = 0;

  auto flush = [&]() -> bool {
    if (offset == 0) return true;
    bool ok = (httpd_resp_send_chunk(req, buf, offset) == ESP_OK);
    offset = 0;
    return ok;
  };

  // Flush the current chunk and retry when a field does not fit — never
  // truncate mid-token (that shipped a NUL and broke JSON.parse on the binder).
  auto append = [&](const char *fmt, ...) -> bool {
    va_list args;
    va_start(args, fmt);
    va_list copy;
    va_copy(copy, args);
    bool ok = appendfv(buf, BUF_SIZE, offset, fmt, copy);
    va_end(copy);
    if (!ok) {
      if (!flush()) {
        va_end(args);
        return false;
      }
      ok = appendfv(buf, BUF_SIZE, offset, fmt, args);
    }
    va_end(args);
    return ok;
  };

  char num_buf[24];

  if (!append("{")) return;

  // --- uptime & wifi ---
  char wifi_buf[24] = "null";
  if (std::isfinite(snap->wifi_dbm)) {
    snprintf(wifi_buf, sizeof(wifi_buf), "%ld", static_cast<long>(std::lround(snap->wifi_dbm)));
  }
  if (!append(
      "\"sensor-uptime\":{\"value\":%lu},"
      "\"sensor-wifi_signal\":{\"value\":%s},",
      static_cast<unsigned long>(snap->uptime_s), wifi_buf)) return;

  // --- system diagnostics: per-core CPU load + free heap + BLE scan liveness ---
  format_float_token(num_buf, sizeof(num_buf), snap->cpu0_pct, 1);
  if (!append( "\"sensor-cpu_load_core0\":{\"value\":%s},", num_buf)) return;
  format_float_token(num_buf, sizeof(num_buf), snap->cpu1_pct, 1);
  if (!append(
      "\"sensor-cpu_load_core1\":{\"value\":%s},"
      "\"sensor-free_internal_kb\":{\"value\":%lu},"
      "\"sensor-free_dma_kb\":{\"value\":%lu},"
      "\"sensor-largest_internal_kb\":{\"value\":%lu},"
      "\"sensor-min_internal_kb\":{\"value\":%lu},"
      "\"sensor-free_psram_kb\":{\"value\":%lu},"
      "\"sensor-largest_psram_kb\":{\"value\":%lu},",
      num_buf,
      static_cast<unsigned long>(snap->free_internal_kb),
      static_cast<unsigned long>(snap->free_dma_kb),
      static_cast<unsigned long>(snap->largest_internal_kb),
      static_cast<unsigned long>(snap->min_internal_kb),
      static_cast<unsigned long>(snap->free_psram_kb),
      static_cast<unsigned long>(snap->largest_psram_kb))) return;
  char ble_ads_buf[24];
  format_float_token(ble_ads_buf, sizeof(ble_ads_buf), snap->ble_ads_per_sec, 2);
  if (!append(
      "\"binary_sensor-ble_hub_enabled\":{\"state\":\"%s\"},"
      "\"binary_sensor-ble_scanning\":{\"state\":\"%s\"},"
      "\"binary_sensor-ble_demanded\":{\"state\":\"%s\"},"
      "\"sensor-ble_ads_per_sec\":{\"value\":%s},"
      "\"sensor-ble_last_adv_age_ms\":{\"value\":%lu},",
      snap->ble_hub_enabled ? "on" : "off",
      snap->ble_scanning ? "on" : "off",
      snap->ble_demanded ? "on" : "off",
      ble_ads_buf,
      static_cast<unsigned long>(snap->ble_last_adv_age_ms == UINT32_MAX ? 0
                                                                        : snap->ble_last_adv_age_ms))) return;

  // --- manifold temps ---
  format_float_token(num_buf, sizeof(num_buf), snap->manifold_flow_c);
  if (!append( "\"sensor-manifold_flow_temperature\":{\"value\":%s},", num_buf)) return;
  format_float_token(num_buf, sizeof(num_buf), snap->manifold_return_c);
  if (!append( "\"sensor-manifold_return_temperature\":{\"value\":%s},", num_buf)) return;

  // --- zone temperatures ---
  static const char *const ZONE_TEMP_KEYS[6] = {
    "sensor-zone_1_temperature", "sensor-zone_2_temperature", "sensor-zone_3_temperature",
    "sensor-zone_4_temperature", "sensor-zone_5_temperature", "sensor-zone_6_temperature",
  };
  for (uint8_t i = 0; i < 6; i++) {
    format_float_token(num_buf, sizeof(num_buf), snap->zone_temp_c[i]);
    if (!append( "\"%s\":{\"value\":%s},", ZONE_TEMP_KEYS[i], num_buf)) return;
  }

  // --- zone valve positions (0 decimals) ---
  static const char *const ZONE_VALVE_KEYS[6] = {
    "sensor-zone_1_valve_pct", "sensor-zone_2_valve_pct", "sensor-zone_3_valve_pct",
    "sensor-zone_4_valve_pct", "sensor-zone_5_valve_pct", "sensor-zone_6_valve_pct",
  };
  for (uint8_t i = 0; i < 6; i++) {
    format_float_token(num_buf, sizeof(num_buf), snap->zone_valve_pct[i], 0);
    if (!append( "\"%s\":{\"value\":%s},", ZONE_VALVE_KEYS[i], num_buf)) return;
  }

  // --- preheat advance ---
  static const char *const PREHEAT_KEYS[6] = {
    "sensor-zone_1_preheat_advance_c", "sensor-zone_2_preheat_advance_c", "sensor-zone_3_preheat_advance_c",
    "sensor-zone_4_preheat_advance_c", "sensor-zone_5_preheat_advance_c", "sensor-zone_6_preheat_advance_c",
  };
  for (uint8_t i = 0; i < 6; i++) {
    format_float_token(num_buf, sizeof(num_buf), snap->zone_preheat_c[i]);
    if (!append( "\"%s\":{\"value\":%s},", PREHEAT_KEYS[i], num_buf)) return;
  }

  // flush: cumulative ~1330 bytes; motor ripples (~840) would overflow
  if (!flush()) return;

  // --- motor learned ripples (0 decimals) ---
  static const char *const OPEN_RIPPLE_KEYS[6] = {
    "sensor-motor_1_learned_open_ripples", "sensor-motor_2_learned_open_ripples", "sensor-motor_3_learned_open_ripples",
    "sensor-motor_4_learned_open_ripples", "sensor-motor_5_learned_open_ripples", "sensor-motor_6_learned_open_ripples",
  };
  static const char *const CLOSE_RIPPLE_KEYS[6] = {
    "sensor-motor_1_learned_close_ripples", "sensor-motor_2_learned_close_ripples", "sensor-motor_3_learned_close_ripples",
    "sensor-motor_4_learned_close_ripples", "sensor-motor_5_learned_close_ripples", "sensor-motor_6_learned_close_ripples",
  };
  for (uint8_t i = 0; i < 6; i++) {
    format_float_token(num_buf, sizeof(num_buf), snap->motor_open_ripple[i], 0);
    if (!append( "\"%s\":{\"value\":%s},", OPEN_RIPPLE_KEYS[i], num_buf)) return;
    format_float_token(num_buf, sizeof(num_buf), snap->motor_close_ripple[i], 0);
    if (!append( "\"%s\":{\"value\":%s},", CLOSE_RIPPLE_KEYS[i], num_buf)) return;
  }

  // flush: motor factors (~900) would overflow
  if (!flush()) return;

  // --- motor learned factors (2 decimals) ---
  static const char *const OPEN_FACTOR_KEYS[6] = {
    "sensor-motor_1_learned_open_factor", "sensor-motor_2_learned_open_factor", "sensor-motor_3_learned_open_factor",
    "sensor-motor_4_learned_open_factor", "sensor-motor_5_learned_open_factor", "sensor-motor_6_learned_open_factor",
  };
  static const char *const CLOSE_FACTOR_KEYS[6] = {
    "sensor-motor_1_learned_close_factor", "sensor-motor_2_learned_close_factor", "sensor-motor_3_learned_close_factor",
    "sensor-motor_4_learned_close_factor", "sensor-motor_5_learned_close_factor", "sensor-motor_6_learned_close_factor",
  };
  for (uint8_t i = 0; i < 6; i++) {
    format_float_token(num_buf, sizeof(num_buf), snap->motor_open_factor[i], 2);
    if (!append( "\"%s\":{\"value\":%s},", OPEN_FACTOR_KEYS[i], num_buf)) return;
    format_float_token(num_buf, sizeof(num_buf), snap->motor_close_factor[i], 2);
    if (!append( "\"%s\":{\"value\":%s},", CLOSE_FACTOR_KEYS[i], num_buf)) return;
  }

  // flush: working-range telemetry would overflow with factors
  if (!flush()) return;

  // --- working-range learning (live from valve telemetry) ---
  static const char *const WORKING_RIPPLE_KEYS[6] = {
    "sensor-motor_1_working_ripples", "sensor-motor_2_working_ripples", "sensor-motor_3_working_ripples",
    "sensor-motor_4_working_ripples", "sensor-motor_5_working_ripples", "sensor-motor_6_working_ripples",
  };
  static const char *const PIN_FREE_KEYS[6] = {
    "sensor-motor_1_pin_free_ripples", "sensor-motor_2_pin_free_ripples", "sensor-motor_3_pin_free_ripples",
    "sensor-motor_4_pin_free_ripples", "sensor-motor_5_pin_free_ripples", "sensor-motor_6_pin_free_ripples",
  };
  static const char *const STROKE_MODEL_KEYS[6] = {
    "text_sensor-motor_1_stroke_model", "text_sensor-motor_2_stroke_model", "text_sensor-motor_3_stroke_model",
    "text_sensor-motor_4_stroke_model", "text_sensor-motor_5_stroke_model", "text_sensor-motor_6_stroke_model",
  };
  for (uint8_t i = 0; i < 6; i++) {
    format_float_token(num_buf, sizeof(num_buf), snap->motor_working_ripple[i], 0);
    if (!append( "\"%s\":{\"value\":%s},", WORKING_RIPPLE_KEYS[i], num_buf)) return;
    format_float_token(num_buf, sizeof(num_buf), snap->motor_pin_free_ripple[i], 0);
    if (!append( "\"%s\":{\"value\":%s},", PIN_FREE_KEYS[i], num_buf)) return;
    const char *model = snap->motor_stroke_model[i] == static_cast<uint8_t>(lv6::StrokeModel::WORKING_RANGE)
                            ? "working_range"
                            : "full_stroke";
    if (!append( "\"%s\":{\"state\":\"%s\"},", STROKE_MODEL_KEYS[i], model)) return;
  }

  // flush: learning progress would overflow with stroke model
  if (!flush()) return;

  static const char *const LEARN_PCT_KEYS[6] = {
    "sensor-motor_1_learn_pct", "sensor-motor_2_learn_pct", "sensor-motor_3_learn_pct",
    "sensor-motor_4_learn_pct", "sensor-motor_5_learn_pct", "sensor-motor_6_learn_pct",
  };
  static const char *const LEARN_PHASE_KEYS[6] = {
    "text_sensor-motor_1_learn_phase", "text_sensor-motor_2_learn_phase", "text_sensor-motor_3_learn_phase",
    "text_sensor-motor_4_learn_phase", "text_sensor-motor_5_learn_phase", "text_sensor-motor_6_learn_phase",
  };
  static const char *const LEARN_SAMPLE_KEYS[6] = {
    "sensor-motor_1_learn_sample", "sensor-motor_2_learn_sample", "sensor-motor_3_learn_sample",
    "sensor-motor_4_learn_sample", "sensor-motor_5_learn_sample", "sensor-motor_6_learn_sample",
  };
  static const char *const LEARN_NEED_KEYS[6] = {
    "sensor-motor_1_learn_samples_needed", "sensor-motor_2_learn_samples_needed",
    "sensor-motor_3_learn_samples_needed", "sensor-motor_4_learn_samples_needed",
    "sensor-motor_5_learn_samples_needed", "sensor-motor_6_learn_samples_needed",
  };
  static const char *const LEARN_PHASE_NAME[] = {
    "", "home", "open", "close", "done", "failed",
  };
  for (uint8_t i = 0; i < 6; i++) {
    if (!append( "\"%s\":{\"value\":%u},", LEARN_PCT_KEYS[i],
            static_cast<unsigned>(snap->motor_learn_pct[i]))) return;
    const uint8_t ph = snap->motor_learn_phase[i];
    const char *phase =
        ph < (sizeof(LEARN_PHASE_NAME) / sizeof(LEARN_PHASE_NAME[0])) ? LEARN_PHASE_NAME[ph] : "";
    if (!append( "\"%s\":{\"state\":\"%s\"},", LEARN_PHASE_KEYS[i], phase)) return;
    if (!append( "\"%s\":{\"value\":%u},", LEARN_SAMPLE_KEYS[i],
            static_cast<unsigned>(snap->motor_learn_sample[i]))) return;
    if (!append( "\"%s\":{\"value\":%u},", LEARN_NEED_KEYS[i],
            static_cast<unsigned>(snap->motor_learn_samples_needed[i]))) return;
  }

  // flush: probe temps + text sensors would overflow combined
  if (!flush()) return;

  // --- probe temperatures ---
  static const char *const PROBE_TEMP_KEYS[8] = {
    "sensor-probe_1_temperature", "sensor-probe_2_temperature", "sensor-probe_3_temperature",
    "sensor-probe_4_temperature", "sensor-probe_5_temperature", "sensor-probe_6_temperature",
    "sensor-probe_7_temperature", "sensor-probe_8_temperature",
  };
  for (uint8_t i = 0; i < 8; i++) {
    format_float_token(num_buf, sizeof(num_buf), snap->probe_temp_c[i]);
    if (!append( "\"%s\":{\"value\":%s},", PROBE_TEMP_KEYS[i], num_buf)) return;
  }

  // flush: text sensors (~1200) would overflow combined with probe temps (~460)
  if (!flush()) return;

  // --- text sensors (pre-sanitized in snapshot) ---
  static const char *const ZONE_STATE_KEYS[6] = {
    "text_sensor-zone_1_state", "text_sensor-zone_2_state", "text_sensor-zone_3_state",
    "text_sensor-zone_4_state", "text_sensor-zone_5_state", "text_sensor-zone_6_state",
  };
  static const char *const MOTOR_FAULT_KEYS[6] = {
    "text_sensor-motor_1_last_fault", "text_sensor-motor_2_last_fault", "text_sensor-motor_3_last_fault",
    "text_sensor-motor_4_last_fault", "text_sensor-motor_5_last_fault", "text_sensor-motor_6_last_fault",
  };

  if (!append( "\"text_sensor-firmware_version\":{\"state\":\"%s\"},", snap->firmware_version)) return;
  if (!append( "\"text_sensor-ip_address\":{\"state\":\"%s\"},", snap->ip_address)) return;
  if (!append( "\"text_sensor-connected_ssid\":{\"state\":\"%s\"},", snap->connected_ssid)) return;
  if (!append( "\"text_sensor-mac_address\":{\"state\":\"%s\"},", snap->mac_address)) return;
  if (!append( "\"text_sensor-reset_reason\":{\"state\":\"%s\"},", snap->reset_reason)) return;
  if (!append( "\"text-device_variant\":{\"state\":\"Lune V6\"},")) return;
  if (!append( "\"text-esphome_version\":{\"state\":\"%s\"},", ESPHOME_VERSION)) return;
  {
    char name_esc[2 * sizeof(snap->system.display_name)];
    char place_esc[2 * sizeof(snap->system.location)];
    json_escape_cstr(device_display_name_cstr(snap->system), name_esc, sizeof(name_esc));
    json_escape_cstr(snap->system.location, place_esc, sizeof(place_esc));
    if (!append( "\"text-device_display_name\":{\"state\":\"%s\"},", name_esc)) return;
    if (!append( "\"text-device_location\":{\"state\":\"%s\"},", place_esc)) return;
  }
  if (!append(
          "\"firmware_update\":{\"current\":\"%s\",\"latest\":\"%s\",\"available\":%s,\"status\":\"%s\"},",
          snap->firmware_update_current, snap->firmware_update_latest,
          snap->firmware_update_available ? "true" : "false", snap->firmware_update_status)) return;

  for (uint8_t i = 0; i < 6; i++) {
    if (!append( "\"%s\":{\"state\":\"%s\"},", ZONE_STATE_KEYS[i], snap->zone_state[i])) return;
  }
  for (uint8_t i = 0; i < 6; i++) {
    if (!append( "\"%s\":{\"state\":\"%s\"},", MOTOR_FAULT_KEYS[i], snap->motor_fault[i])) return;
  }

  // flush before config section; each zone config (~550 bytes) would overflow combined
  if (!flush()) return;

  // ---- config (read entirely from snapshot — no config_store_ calls) ----
  static const char *const PIPE_TYPE_STR[] = {
    "PEX 12mm", "PEX 14mm", "PEX 16mm", "PEX 17mm",
    "PEX 18mm", "PEX 20mm", "ALUPEX 16mm", "ALUPEX 20mm"
  };
  static const char *const MOTOR_PROFILE_STR[] = {
    "Inherit", "Generic", "HmIP VdMot"
  };

  // --- zone configs: flush after each to stay within buffer ---
  for (uint8_t i = 0; i < lv6::NUM_ZONES; i++) {
    const lv6::ZoneConfig &z = snap->zones[i];
    const uint8_t zn = i + 1;

    if (!append(
        "\"switch-zone_%u_enabled\":{\"state\":\"%s\"},"
        "\"number-zone_%u_setpoint\":{\"value\":",
        zn, z.enabled ? "on" : "off", zn)) return;
    format_float_token(num_buf, sizeof(num_buf), z.setpoint_c, 1);
    if (!append( "%s},", num_buf)) return;
    format_float_token(num_buf, sizeof(num_buf), z.setpoint_c, 1);
    if (!append( "\"number-zone_%u_base_setpoint\":{\"value\":%s},", zn, num_buf)) return;
    format_float_token(num_buf, sizeof(num_buf), z.setpoint_c, 1);
    if (!append( "\"number-zone_%u_effective_setpoint\":{\"value\":%s},", zn, num_buf)) return;
    format_float_token(num_buf, sizeof(num_buf), this->coordinator_command_offsets_c_[i], 2);
    if (!append( "\"number-zone_%u_coordinator_offset\":{\"value\":%s},", zn, num_buf)) return;
    const uint32_t remaining_s = this->coordinator_command_expires_at_ms_[i] > millis()
        ? (this->coordinator_command_expires_at_ms_[i] - millis()) / 1000UL : 0UL;
    if (!append( "\"sensor-zone_%u_coordinator_remaining_s\":{\"value\":%lu},", zn, static_cast<unsigned long>(remaining_s))) return;

    format_float_token(num_buf, sizeof(num_buf), z.area_m2, 1);
    if (!append( "\"number-zone_%u_area_m2\":{\"value\":%s},", zn, num_buf)) return;

    format_float_token(num_buf, sizeof(num_buf), z.pipe_spacing_mm, 0);
    if (!append( "\"number-zone_%u_pipe_spacing_mm\":{\"value\":%s},", zn, num_buf)) return;

    const int8_t probe_idx = snap->probes.zone_return_probe[i];
    if (probe_idx >= 0 && probe_idx < static_cast<int8_t>(lv6::MAX_PROBES)) {
      if (!append(
          "\"select-zone_%u_probe\":{\"state\":\"Probe %d\"},",
          zn, static_cast<int>(probe_idx) + 1)) return;
    } else {
      if (!append( "\"select-zone_%u_probe\":{\"state\":\"None\"},", zn)) return;
    }

    const char *src_str = temp_source_to_dashboard_str(snap->zone_temp_source[i]);
    if (!append(
        "\"select-zone_%u_temp_source\":{\"state\":\"%s\"},", zn, src_str)) return;

    if (z.sync_to_zone >= 0 && z.sync_to_zone < static_cast<int8_t>(lv6::NUM_ZONES)) {
      if (!append(
          "\"select-zone_%u_sync_to\":{\"state\":\"Zone %d\"},",
          zn, static_cast<int>(z.sync_to_zone) + 1)) return;
    } else {
      if (!append( "\"select-zone_%u_sync_to\":{\"state\":\"None\"},", zn)) return;
    }

    const uint8_t pt_idx = static_cast<uint8_t>(z.pipe_type);
    const char *pt_str = (pt_idx < 8) ? PIPE_TYPE_STR[pt_idx] : "Unknown";
    if (!append( "\"select-zone_%u_pipe_type\":{\"state\":\"%s\"},", zn, pt_str)) return;

    char age_ent[16];
    if (snap->zone_external_temp_age_ms[i] == UINT32_MAX)
      snprintf(age_ent, sizeof(age_ent), "null");
    else
      snprintf(age_ent, sizeof(age_ent), "%lu",
               static_cast<unsigned long>(snap->zone_external_temp_age_ms[i]));
    if (!append(
        "\"text-zone_%u_ble_mac\":{\"state\":\"%s\"},"
        "\"text-zone_%u_sensor_id\":{\"state\":\"%s\"},"
        "\"text-zone_%u_sensor_name\":{\"state\":\"%s\"},"
        "\"sensor-zone_%u_external_temp_age_ms\":{\"value\":%s},",
        zn, snap->zone_ble_mac[i], zn, snap->zone_sensor_id[i], zn, snap->zone_sensor_name[i],
        zn, age_ent)) return;

    // Friendly zone name — JSON-escape quotes/backslashes/control chars.
    char name_esc[2 * sizeof(z.name)];
    size_t nesc = 0;
    for (size_t j = 0; z.name[j] != '\0' && nesc < sizeof(name_esc) - 2; j++) {
      char c = z.name[j];
      if (c == '"' || c == '\\') name_esc[nesc++] = '\\';
      name_esc[nesc++] = (c >= 0x20) ? c : ' ';
    }
    name_esc[nesc] = '\0';
    if (!append(
        "\"text-zone_%u_name\":{\"state\":\"%s\"},", zn, name_esc)) return;

    // flush after each zone to stay within buffer
    if (!flush()) return;
  }

  // --- global config ---
  if (!append(
      "\"switch-motor_drivers_enabled\":{\"state\":\"%s\"},"
      "\"text_sensor-motor_drivers_off_reason\":{\"state\":\"%s\"},",
      snap->drivers_enabled ? "on" : "off",
      snap->drivers_enabled ? "" : snap->drivers_off_reason)) return;

  if (!append(
      "\"switch-simple_preheat_enabled\":{\"state\":\"%s\"},",
      snap->simple_preheat_enabled ? "on" : "off")) return;

  format_float_token(num_buf, sizeof(num_buf), snap->preheat_absorb_band_c, 1);
  if (!append(
      "\"switch-preheat_absorb_enabled\":{\"state\":\"%s\"},"
      "\"text-preheat_absorbing\":{\"state\":\"%s\"},"
      "\"text-preheat_absorb_reason\":{\"state\":\"%s\"},"
      "\"text-preheat_absorb_end_reason\":{\"state\":\"%s\"},"
      "\"number-preheat_absorb_band_c\":{\"value\":%s},",
      snap->preheat_absorb_enabled ? "on" : "off",
      snap->absorb_mode == 2 ? "armed" : (snap->absorb_mode == 1 ? "reactive" : "idle"),
      snap->absorb_reason,
      snap->absorb_end_reason,
      num_buf)) return;
  format_float_token(num_buf, sizeof(num_buf), snap->preheat_detect_delta_c, 1);
  if (!append( "\"number-preheat_detect_delta_c\":{\"value\":%s},", num_buf)) return;

  if (!append(
      "\"select-heating_mode\":{\"state\":\"%s\"},"
      "\"text-effective_heating_mode\":{\"state\":\"%s\"},"
      "\"text-heating_mode_source\":{\"state\":\"%s\"},"
      "\"text-heat_demand_recommendation\":{\"state\":\"%s\"},",
      lv6::heating_profile_to_string(snap->heating_mode),
      lv6::heating_profile_to_string(snap->effective_heating_mode),
      snap->heating_mode_from_touch ? "touch" : "local",
      lv6::heat_demand_recommendation_to_string(snap->heat_demand.recommendation))) return;
  format_float_token(num_buf, sizeof(num_buf), snap->hp_overheat_margin_c, 1);
  if (!append( "\"number-hp_overheat_margin_c\":{\"value\":%s},", num_buf)) return;
  format_float_token(num_buf, sizeof(num_buf), snap->hp_base_pct, 0);
  if (!append( "\"number-hp_base_pct\":{\"value\":%s},", num_buf)) return;
  format_float_token(num_buf, sizeof(num_buf), snap->hp_trim_floor_pct, 0);
  if (!append( "\"number-hp_trim_floor_pct\":{\"value\":%s},", num_buf)) return;
  format_float_token(num_buf, sizeof(num_buf), snap->hp_demand_pct, 0);
  if (!append( "\"number-hp_demand_pct\":{\"value\":%s},", num_buf)) return;
  format_float_token(num_buf, sizeof(num_buf), snap->hp_close_above_c, 1);
  if (!append( "\"number-hp_close_above_c\":{\"value\":%s},", num_buf)) return;
  if (snap->heat_demand.critical_zone >= 0)
    if (!append( "\"sensor-heat_demand_critical_zone\":{\"value\":%d},",
            snap->heat_demand.critical_zone + 1)) return;
  if (!append( "\"sensor-heat_demand_saturated_s\":{\"value\":%lu},",
          static_cast<unsigned long>(snap->heat_demand.saturated_s))) return;

  {
    const char *bal_mode = "static";
    switch (snap->balancing.mode) {
      case lv6::BalanceMode::ADAPTIVE: bal_mode = "adaptive"; break;
      case lv6::BalanceMode::RETURN_TEMP: bal_mode = "return_temp"; break;
      default: bal_mode = "static"; break;
    }
    if (!append( "\"select-balancing_mode\":{\"state\":\"%s\"},", bal_mode)) return;
  }
  for (uint8_t i = 0; i < lv6::NUM_ZONES; i++) {
    const uint8_t zn = i + 1;
    format_float_token(num_buf, sizeof(num_buf), snap->zone_static_factor[i], 2);
    if (!append( "\"sensor-zone_%u_balance_prior\":{\"value\":%s},", zn, num_buf)) return;
    format_float_token(num_buf, sizeof(num_buf), snap->zone_balance_adapt[i], 2);
    if (!append( "\"sensor-zone_%u_balance_learned\":{\"value\":%s},", zn, num_buf)) return;
    format_float_token(num_buf, sizeof(num_buf), snap->zone_hydraulic_factor[i], 2);
    if (!append( "\"sensor-zone_%u_balance_effective\":{\"value\":%s},", zn, num_buf)) return;
  }

  if (!append(
      "\"select-manifold_type\":{\"state\":\"%s\"},"
      "\"select-manifold_flow_probe\":{\"state\":\"Probe %d\"},"
      "\"select-manifold_return_probe\":{\"state\":\"Probe %d\"},",
      snap->manifold_type == lv6::ManifoldType::NC ? "NC (Normally Closed)" : "NO (Normally Open)",
      static_cast<int>(snap->probes.manifold_flow_probe) + 1,
      static_cast<int>(snap->probes.manifold_return_probe) + 1)) return;

  const uint8_t mp_idx = static_cast<uint8_t>(snap->motor.default_profile);
  const char *mp_str = (mp_idx < 3) ? MOTOR_PROFILE_STR[mp_idx] : "Generic";
  if (!append( "\"select-motor_profile_default\":{\"state\":\"%s\"},", mp_str)) return;

  format_float_token(num_buf, sizeof(num_buf), snap->motor.close_current_factor, 2);
  if (!append( "\"number-close_threshold_multiplier\":{\"value\":%s},", num_buf)) return;
  format_float_token(num_buf, sizeof(num_buf), snap->motor.close_slope_threshold_ma_per_s, 2);
  if (!append( "\"number-close_slope_threshold\":{\"value\":%s},", num_buf)) return;
  format_float_token(num_buf, sizeof(num_buf), snap->motor.close_slope_current_factor, 2);
  if (!append( "\"number-close_slope_current_factor\":{\"value\":%s},", num_buf)) return;
  format_float_token(num_buf, sizeof(num_buf), snap->motor.open_current_factor, 2);
  if (!append( "\"number-open_threshold_multiplier\":{\"value\":%s},", num_buf)) return;
  format_float_token(num_buf, sizeof(num_buf), snap->motor.open_slope_threshold_ma_per_s, 2);
  if (!append( "\"number-open_slope_threshold\":{\"value\":%s},", num_buf)) return;
  format_float_token(num_buf, sizeof(num_buf), snap->motor.open_slope_current_factor, 2);
  if (!append( "\"number-open_slope_current_factor\":{\"value\":%s},", num_buf)) return;
  format_float_token(num_buf, sizeof(num_buf), snap->motor.open_ripple_limit_factor, 2);
  if (!append( "\"number-open_ripple_limit_factor\":{\"value\":%s},", num_buf)) return;
  if (!append(
      "\"number-generic_runtime_limit_seconds\":{\"value\":%lu},"
      "\"number-hmip_runtime_limit_seconds\":{\"value\":%lu},"
      "\"number-relearn_after_movements\":{\"value\":%lu},"
      "\"number-relearn_after_hours\":{\"value\":%lu},"
      "\"number-learned_factor_min_samples\":{\"value\":%u},",
      static_cast<unsigned long>(snap->motor.generic_profile_runtime_limit_s),
      static_cast<unsigned long>(snap->motor.hmip_vdmot_runtime_limit_s),
      static_cast<unsigned long>(snap->motor.relearn_after_movements),
      static_cast<unsigned long>(snap->motor.relearn_after_hours),
      static_cast<unsigned>(snap->motor.learned_factor_min_samples))) return;
  format_float_token(num_buf, sizeof(num_buf), snap->motor.learned_factor_max_deviation_pct * 100.0f, 2);
  if (!append(
      "\"number-learned_factor_max_deviation_pct\":{\"value\":%s},", num_buf)) return;

  // GPIO-bridge endstop policy: the fields detect_endstop_() and the DMA cap
  // ladder actually read on the GPIO-bridge backends.
  if (!flush()) return;
  struct MotorNum { const char *key; float value; int decimals; };
  const MotorNum rev3x_motor[] = {
      {"open_endstop_current_factor", snap->motor.open_endstop_current_factor, 2},
      {"open_endstop_stall_fraction", snap->motor.open_endstop_stall_fraction, 2},
      {"close_trailing_step_ma", snap->motor.close_trailing_step_ma, 2},
      {"close_trailing_sustain_ms", static_cast<float>(snap->motor.close_trailing_sustain_ms), 0},
      {"close_trailing_ref_ms", static_cast<float>(snap->motor.close_trailing_ref_ms), 0},
      {"cap_close_seat_ma", snap->motor.cap_close_seat_ma, 1},
      {"cap_close_seat_frames", static_cast<float>(snap->motor.cap_close_seat_frames), 0},
      {"cap_close_popoff_ma", snap->motor.cap_close_popoff_ma, 1},
      {"cap_stall_ma", snap->motor.cap_stall_ma, 1},
      {"cap_open_stop_ma", snap->motor.cap_open_stop_ma, 1},
      {"cap_circuit_fault_ma", snap->motor.cap_circuit_fault_ma, 1},
      {"close_runtime_limit_counts", static_cast<float>(snap->motor.close_runtime_limit_counts), 0},
      // Working-range learning (stroke_learning.h) and the pin detector it uses.
      {"working_range_learning", snap->motor.working_range_learning ? 1.0f : 0.0f, 0},
      {"learn_open_start_ripples", static_cast<float>(snap->motor.learn_open_start_ripples), 0},
      {"learn_open_step_ripples", static_cast<float>(snap->motor.learn_open_step_ripples), 0},
      {"learn_open_max_ripples", static_cast<float>(snap->motor.learn_open_max_ripples), 0},
      {"learn_min_free_ripples", static_cast<float>(snap->motor.learn_min_free_ripples), 0},
      {"learn_samples", static_cast<float>(snap->motor.learn_samples), 0},
      {"learn_max_spread_pct", static_cast<float>(snap->motor.learn_max_spread_pct), 0},
      {"pin_engage_step_ma", snap->motor.pin_engage_step_ma, 2},
      {"pin_engage_margin_ripples", static_cast<float>(snap->motor.pin_engage_margin_ripples), 0},
  };
  for (const auto &n : rev3x_motor) {
    format_float_token(num_buf, sizeof(num_buf), n.value, n.decimals);
    if (!append( "\"number-%s\":{\"value\":%s},", n.key, num_buf)) return;
  }

  // flush before authority/flow section
  if (!flush()) return;

  // --- Touch authority + local secondary-flow commissioning ---
  if (!append(
      "\"text-authority_state\":{\"state\":\"%s\"},"
      "\"text-authority_reason\":{\"state\":\"%s\"},"
      "\"text-authority_installation_id\":{\"state\":\"%s\"},"
      "\"text-authority_coordinator_id\":{\"state\":\"%s\"},"
      "\"text-authority_proposal_installation_id\":{\"state\":\"%s\"},"
      "\"text-authority_proposal_coordinator_id\":{\"state\":\"%s\"},"
      "\"text-authority_proposal_name\":{\"state\":\"%s\"},"
      "\"text-authority_proposal_site\":{\"state\":\"%s\"},"
      "\"binary_sensor-authority_proposal_pending\":{\"state\":\"%s\",\"value\":%s},"
      "\"binary_sensor-authority_configured\":{\"state\":\"%s\",\"value\":%s},"
      "\"sensor-authority_lease_remaining_s\":{\"state\":%lu},",
      snap->authority_state, snap->authority_reason,
      snap->authority.installation_id, snap->authority.coordinator_id,
      authority_proposal_installation_id_, authority_proposal_coordinator_id_,
      authority_proposal_name_, authority_proposal_site_,
      authority_proposal_expires_at_ms_ != 0 &&
              static_cast<int32_t>(authority_proposal_expires_at_ms_ - millis()) > 0 ? "on" : "off",
      authority_proposal_expires_at_ms_ != 0 &&
              static_cast<int32_t>(authority_proposal_expires_at_ms_ - millis()) > 0 ? "true" : "false",
      snap->authority.shared_key[0] != '\0' ? "on" : "off",
      snap->authority.shared_key[0] != '\0' ? "true" : "false",
      static_cast<unsigned long>(snap->authority_lease_remaining_s))) return;
  format_float_token(num_buf, sizeof(num_buf), snap->min_zone_flow_pct, 1);
  if (!append(
      "\"switch-minimum_flow_always\":{\"state\":\"%s\"},"
      "\"number-min_zone_flow_pct\":{\"value\":%s},",
      snap->minimum_flow_always ? "on" : "off",
      num_buf)) return;
  if (!append(
      "\"switch-ble_clock_sync_enabled\":{\"state\":\"%s\"},"
      "\"number-ble_clock_sync_interval_min\":{\"value\":%u},"
      "\"sensor-ble_clock_sync_last_ok_s\":{\"value\":%lu},"
      "\"text-ble_clock_sync_last_error\":{\"state\":\"%s\"},"
      "\"binary_sensor-ble_clock_sync_advertising\":{\"state\":\"%s\"},",
      snap->ble_clock_sync_enabled ? "on" : "off",
      static_cast<unsigned>(snap->ble_clock_sync_interval_min),
      static_cast<unsigned long>(snap->ble_clock_sync_last_ok_s),
      snap->ble_clock_sync_last_error,
      snap->ble_clock_sync_advertising ? "on" : "off")) return;
  // Sentinel field closes the JSON object and absorbs any trailing comma.
  if (!append( "\"_\":{}}")) return;
  flush();
  httpd_resp_send_chunk(req, nullptr, 0);
}

void LV6Dashboard::handle_overview_(AsyncWebServerRequest *request) {
  if (snapshot_lock_ == nullptr || !snapshot_ready_ ||
      xSemaphoreTake(snapshot_lock_, pdMS_TO_TICKS(50)) != pdTRUE) {
    send_text_(request, 503, "application/json", "{\"ok\":false,\"error\":{\"code\":\"snapshot_not_ready\"}}",
               true, "no-cache");
    return;
  }
  memcpy(&this->state_snap_buf_, &this->snapshot_, sizeof(this->state_snap_buf_));
  xSemaphoreGive(snapshot_lock_);

  const DashboardSnapshot *snap = &this->state_snap_buf_;
  uint8_t enabled = 0;
  uint8_t active = 0;
  float valve_sum = 0.0f;
  uint8_t valve_count = 0;
  for (uint8_t i = 0; i < lv6::NUM_ZONES; i++) {
    if (snap->zones[i].enabled)
      enabled++;
    if (std::isfinite(snap->zone_valve_pct[i])) {
      valve_sum += snap->zone_valve_pct[i];
      valve_count++;
      if (snap->zone_valve_pct[i] > 0.5f)
        active++;
    }
  }

  char flow[24], ret[24], demand[24], wifi[24], ble_ads_status[24];
  format_float_token(flow, sizeof(flow), snap->manifold_flow_c, 1);
  format_float_token(ret, sizeof(ret), snap->manifold_return_c, 1);
  format_float_token(demand, sizeof(demand), valve_count ? valve_sum / valve_count : NAN, 0);
  format_float_token(wifi, sizeof(wifi), snap->wifi_dbm, 0);
  format_float_token(ble_ads_status, sizeof(ble_ads_status), snap->ble_ads_per_sec, 2);
  char pairing_fingerprint[24];
  format_pairing_fingerprint(snap->mac_address, pairing_fingerprint, sizeof(pairing_fingerprint));

  char critical_zone_tok[8];
  if (snap->heat_demand.critical_zone >= 0)
    snprintf(critical_zone_tok, sizeof(critical_zone_tok), "%d",
             snap->heat_demand.critical_zone + 1);
  else
    snprintf(critical_zone_tok, sizeof(critical_zone_tok), "null");

  const char *absorb_state =
      snap->absorb_mode == 2 ? "armed" : (snap->absorb_mode == 1 ? "reactive" : "idle");

  snprintf(this->json_buf_, JSON_BUF_SIZE,
           "{\"ok\":true,\"version\":\"v1\",\"data\":{\"node\":{\"model\":\"lune-v6\","
           "\"firmware\":\"%s\",\"ip\":\"%s\",\"ssid\":\"%s\",\"mac\":\"%s\","
           "\"pairing_fingerprint\":\"%s\",\"uptime_s\":%lu},"
           "\"pairing\":{\"method\":\"mac-fingerprint-v1\",\"fingerprint\":\"%s\"},"
           "\"coordination\":{\"installation_id\":\"%s\",\"coordinator_id\":\"%s\","
           "\"control_approved\":%s,\"touch_ip\":\"%s\"},"
           "\"control\":{\"mode\":\"%s\",\"effective_mode\":\"%s\",\"mode_source\":\"%s\","
           "\"heat_demand\":{\"recommendation\":\"%s\",\"critical_zone\":%s,"
           "\"critical_opening_ratio\":%.3f,\"saturated_s\":%lu,\"demanding_zones\":%u,"
           "\"headroom\":%s}},"
           "\"absorb\":{\"state\":\"%s\",\"reason\":\"%s\",\"end_reason\":\"%s\"},"
           "\"zones\":{\"count\":%u,\"enabled\":%u,\"active\":%u,\"open_valves\":%u},"
           "\"manifold\":{\"flow_c\":%s,\"flow_temp_c\":%s,\"return_c\":%s,\"mean_valve_pct\":%s},"
           "\"system\":{\"wifi_dbm\":%s,\"drivers_enabled\":%s,\"free_internal_kb\":%lu,"
           "\"free_dma_kb\":%lu,\"largest_internal_kb\":%lu,\"min_internal_kb\":%lu,"
           "\"free_psram_kb\":%lu,\"largest_psram_kb\":%lu,"
           "\"ble_enabled\":%s,\"ble_scanning\":%s,\"ble_demanded\":%s,"
           "\"ble_ads_per_sec\":%s,\"ble_last_adv_age_ms\":%lu},"
           "\"safety\":{\"local_authority\":true,\"commands_clamped\":true,"
           "\"minimum_flow_always\":%s},\"physics_contract\":1}}",
           snap->firmware_version, snap->ip_address, snap->connected_ssid, snap->mac_address,
           pairing_fingerprint, static_cast<unsigned long>(snap->uptime_s),
           pairing_fingerprint,
           snap->authority.installation_id, snap->authority.coordinator_id,
           snap->authority.installation_id[0] != '\0' &&
                   snap->authority.coordinator_id[0] != '\0' &&
                   snap->authority.shared_key[0] != '\0' ? "true" : "false",
           this->touch_ip_,
           lv6::heating_profile_to_string(snap->heating_mode),
           lv6::heating_profile_to_string(snap->effective_heating_mode),
           snap->heating_mode_from_touch ? "touch" : "local",
           lv6::heat_demand_recommendation_to_string(snap->heat_demand.recommendation),
           critical_zone_tok, snap->heat_demand.critical_opening_ratio,
           static_cast<unsigned long>(snap->heat_demand.saturated_s),
           static_cast<unsigned>(snap->heat_demand.demanding_zones),
           snap->heat_demand.headroom ? "true" : "false",
           absorb_state, snap->absorb_reason, snap->absorb_end_reason,
           static_cast<unsigned>(lv6::NUM_ZONES), static_cast<unsigned>(enabled),
           static_cast<unsigned>(active), static_cast<unsigned>(active),
           flow, flow, ret, demand, wifi, snap->drivers_enabled ? "true" : "false",
           static_cast<unsigned long>(snap->free_internal_kb),
           static_cast<unsigned long>(snap->free_dma_kb),
           static_cast<unsigned long>(snap->largest_internal_kb),
           static_cast<unsigned long>(snap->min_internal_kb),
           static_cast<unsigned long>(snap->free_psram_kb),
           static_cast<unsigned long>(snap->largest_psram_kb),
           snap->ble_hub_enabled ? "true" : "false",
           snap->ble_scanning ? "true" : "false",
           snap->ble_demanded ? "true" : "false",
           ble_ads_status,
           static_cast<unsigned long>(snap->ble_last_adv_age_ms == UINT32_MAX
                                          ? 0
                                          : snap->ble_last_adv_age_ms),
           snap->minimum_flow_always ? "true" : "false");
  send_text_(request, 200, "application/json", this->json_buf_, true, "no-cache");
}

void LV6Dashboard::handle_zones_(AsyncWebServerRequest *request) {
  if (snapshot_lock_ == nullptr || !snapshot_ready_ ||
      xSemaphoreTake(snapshot_lock_, pdMS_TO_TICKS(50)) != pdTRUE) {
    send_text_(request, 503, "application/json", "{\"ok\":false,\"error\":{\"code\":\"snapshot_not_ready\"}}",
               true, "no-cache");
    return;
  }
  memcpy(&this->state_snap_buf_, &this->snapshot_, sizeof(this->state_snap_buf_));
  xSemaphoreGive(snapshot_lock_);

  // Zone physics / groups write through config_store immediately, but the
  // periodic snapshot can lag by one tick. Overlay live zone config so
  // GET /zones reflects the latest provisioned floor fields right after POST.
  if (this->config_store_) {
    for (uint8_t i = 0; i < lv6::NUM_ZONES; i++)
      this->state_snap_buf_.zones[i] = this->config_store_->get_zone_config(i);
  }

  const DashboardSnapshot *snap = &this->state_snap_buf_;
  char *buf = this->json_buf_;
  size_t off = 0;

  // node_id: "lune-v6-" + last 6 hex digits of MAC (or controller_id fallback).
  char node_id[40] = "lune-v6";
  {
    char hex[13]{};
    size_t hi = 0;
    for (const char *p = snap->mac_address; *p && hi + 1 < sizeof(hex); ++p) {
      if ((*p >= '0' && *p <= '9') || (*p >= 'a' && *p <= 'f') || (*p >= 'A' && *p <= 'F'))
        hex[hi++] = static_cast<char>(tolower(static_cast<unsigned char>(*p)));
    }
    if (hi >= 6)
      snprintf(node_id, sizeof(node_id), "lune-v6-%s", hex + (hi - 6));
    else if (snap->system.controller_id[0])
      snprintf(node_id, sizeof(node_id), "%s", snap->system.controller_id);
  }

  // Resolve sync-group primaries for group_members / group_primary.
  int8_t sync_roots[lv6::NUM_ZONES];
  for (uint8_t i = 0; i < lv6::NUM_ZONES; i++) {
    int8_t root = static_cast<int8_t>(i);
    for (uint8_t guard = 0; guard < lv6::NUM_ZONES; guard++) {
      int8_t next = snap->zones[root].sync_to_zone;
      if (next < 0 || next >= static_cast<int8_t>(lv6::NUM_ZONES))
        break;
      if (next == static_cast<int8_t>(i)) {
        root = static_cast<int8_t>(i);
        break;
      }
      root = next;
    }
    sync_roots[i] = root;
  }

  // Board identity for Touch: raw display_name ("Lune V6" is the default) and
  // location, so the coordinator can label the manifold without a local name.
  char name_esc[2 * sizeof(snap->system.display_name)];
  char place_esc[2 * sizeof(snap->system.location)];
  json_escape_cstr(snap->system.display_name, name_esc, sizeof(name_esc));
  json_escape_cstr(snap->system.location, place_esc, sizeof(place_esc));

  appendf(buf, JSON_BUF_SIZE, off,
          "{\"ok\":true,\"version\":\"v1\",\"data\":{\"node_id\":\"%s\","
          "\"device_name\":\"%s\",\"device_location\":\"%s\",\"count\":%u,\"hp_phase\":\"%s\",\"zones\":[",
          node_id, name_esc, place_esc, static_cast<unsigned>(lv6::NUM_ZONES),
          this->zone_controller_ ? lv6::Lv6ZoneController::hp_phase_name(this->zone_controller_->get_hp_phase())
                                 : "unknown");
  for (uint8_t i = 0; i < lv6::NUM_ZONES && off + 1200 < JSON_BUF_SIZE; i++) {
    char temp[24], setpoint[24], valve[24], preload[24];
    format_float_token(temp, sizeof(temp), snap->zone_temp_c[i], 1);
    format_float_token(setpoint, sizeof(setpoint), snap->zones[i].setpoint_c, 1);
    format_float_token(valve, sizeof(valve), snap->zone_valve_pct[i], 0);
    format_float_token(preload, sizeof(preload), snap->zone_preheat_c[i], 1);
    char max_offset[24];
    format_float_token(max_offset, sizeof(max_offset), snap->zones[i].max_offset_c, 2);
    lv6::HousePhysicsConfig house{};
    if (this->config_store_)
      house = this->config_store_->get_house_physics();
    const auto th = lv6::thermal_model::estimate(snap->zones[i], house);
    char ua[24], mass[24], tau[24], return_c[24];
    char ua_prior[24], ua_learned[24], ua_eff[24], conf[24];
    char c_slab_m2[24], c_slab[24], c_zone[24], r_tok[24], headroom[24];
    format_float_token(ua, sizeof(ua), th.ua_effective_w_per_k, 1);
    format_float_token(mass, sizeof(mass), th.c_zone_kwh_per_k, 3);
    format_float_token(tau, sizeof(tau), th.tau_prior_h, 1);
    format_float_token(ua_prior, sizeof(ua_prior), th.ua_prior_w_per_k, 1);
    if (std::isfinite(snap->zones[i].ua_learned_w_per_k))
      format_float_token(ua_learned, sizeof(ua_learned), snap->zones[i].ua_learned_w_per_k, 1);
    else
      snprintf(ua_learned, sizeof(ua_learned), "null");
    format_float_token(ua_eff, sizeof(ua_eff), th.ua_effective_w_per_k, 1);
    if (std::isfinite(snap->zones[i].ua_learned_confidence))
      format_float_token(conf, sizeof(conf), snap->zones[i].ua_learned_confidence, 2);
    else
      snprintf(conf, sizeof(conf), "null");
    format_float_token(c_slab_m2, sizeof(c_slab_m2), th.c_slab_per_m2, 4);
    format_float_token(c_slab, sizeof(c_slab), th.c_slab_kwh_per_k, 3);
    format_float_token(c_zone, sizeof(c_zone), th.c_zone_kwh_per_k, 3);
    format_float_token(r_tok, sizeof(r_tok), th.r_m2k_per_w, 3);
    format_float_token(headroom, sizeof(headroom), th.absorb_headroom_k, 1);
    const int8_t zr = snap->probes.zone_return_probe[i];
    if (zr >= 0 && zr < static_cast<int8_t>(lv6::MAX_PROBES))
      format_float_token(return_c, sizeof(return_c), snap->probe_temp_c[zr], 1);
    else
      snprintf(return_c, sizeof(return_c), "null");
    char share[24], rank[16], opening_ratio[24];
    if (std::isfinite(snap->zone_loop_share_pct[i]))
      format_float_token(share, sizeof(share), snap->zone_loop_share_pct[i], 1);
    else
      snprintf(share, sizeof(share), "null");
    if (snap->zone_absorb_capacity_rank[i] > 0)
      snprintf(rank, sizeof(rank), "%u", static_cast<unsigned>(snap->zone_absorb_capacity_rank[i]));
    else
      snprintf(rank, sizeof(rank), "null");
    const float max_open = std::max(1.0f, snap->zones[i].max_opening_pct);
    format_float_token(opening_ratio, sizeof(opening_ratio), snap->zone_valve_pct[i] / max_open, 3);
    const char *absorb_state =
        (snap->absorb_mode == 2 || (this->zone_controller_ && this->zone_controller_->is_zone_absorb_armed(i))) ? "armed" : (snap->absorb_mode == 1 ? "reactive" : "idle");
    const int8_t primary = sync_roots[i];
    lv6::GroupsConfig groups{};
    if (this->config_store_)
      groups = this->config_store_->get_groups();
    const lv6::GroupRole role = lv6::group_model::role_for_loop(groups, i);
    char group_id[lv6::GROUP_ID_LEN] = "";
    const int8_t gi = lv6::group_model::find_group_index(groups, i);
    if (gi >= 0)
      strncpy(group_id, groups.groups[gi].group_id, sizeof(group_id) - 1);
    else
      lv6::group_model::make_default_group_id(group_id, sizeof(group_id), i);

    appendf(buf, JSON_BUF_SIZE, off,
            "%s{\"zone\":%u,\"loop_id\":\"z%u\",\"name\":\"",
            i ? "," : "", static_cast<unsigned>(i + 1), static_cast<unsigned>(i + 1));
    append_json_escaped(buf, JSON_BUF_SIZE, off, snap->zones[i].name);
    appendf(buf, JSON_BUF_SIZE, off,
            "\",\"friendly_name\":\"");
    append_json_escaped(buf, JSON_BUF_SIZE, off, snap->zones[i].name);
    appendf(buf, JSON_BUF_SIZE, off,
            "\",\"enabled\":%s,\"temperature_c\":%s,\"setpoint_c\":%s,\"valve_pct\":%s,"
            "\"opening_ratio\":%s,\"preheat_c\":%s,\"state\":\"%s\",\"temp_source\":\"%s\","
            "\"fresh\":%s,\"group_primary\":%u,\"group_members\":[",
            snap->zones[i].enabled ? "true" : "false", temp, setpoint, valve, opening_ratio, preload,
            snap->zone_state[i], temp_source_to_dashboard_str(snap->zone_temp_source[i]),
            std::isfinite(snap->zone_temp_c[i]) ? "true" : "false",
            static_cast<unsigned>(primary + 1));
    bool first_member = true;
    for (uint8_t m = 0; m < lv6::NUM_ZONES; m++) {
      if (sync_roots[m] != primary)
        continue;
      appendf(buf, JSON_BUF_SIZE, off, "%s%u", first_member ? "" : ",", static_cast<unsigned>(m + 1));
      first_member = false;
    }
    char days_tok[16];
    if (std::isfinite(snap->zones[i].ua_learned_w_per_k))
      snprintf(days_tok, sizeof(days_tok), "%u",
               static_cast<unsigned>(snap->zones[i].ua_learned_observed_days));
    else
      snprintf(days_tok, sizeof(days_tok), "null");
    char thick_tok[24];
    if (snap->zones[i].active_thickness_cm > 0.0f)
      snprintf(thick_tok, sizeof(thick_tok), "%.1f", snap->zones[i].active_thickness_cm);
    else
      snprintf(thick_tok, sizeof(thick_tok), "null");
    char r_ov_tok[24];
    if (std::isfinite(snap->zones[i].r_override_m2k_per_w))
      snprintf(r_ov_tok, sizeof(r_ov_tok), "%.3f", snap->zones[i].r_override_m2k_per_w);
    else
      snprintf(r_ov_tok, sizeof(r_ov_tok), "null");
    appendf(buf, JSON_BUF_SIZE, off,
            "],\"area_m2\":%.1f,\"exterior_walls\":%u,"
            "\"floor\":{\"slab_type\":\"%s\",\"active_thickness_cm\":%s,\"covering\":\"%s\","
            "\"r_override_m2k_per_w\":%s,\"c_slab_per_m2\":%s,\"c_slab_kwh_per_k\":%s,"
            "\"c_zone_kwh_per_k\":%s,\"r_m2k_per_w\":%s,\"absorb_headroom_k\":%s,\"unset\":%s},"
            "\"ua_prior_w_per_k\":%s,\"ua_learned_w_per_k\":%s,\"ua_learned_confidence\":%s,"
            "\"ua_learned_observed_days\":%s,\"ua_source\":\"%s\",\"ua_weight_override\":%.2f,"
            "\"ua_effective_w_per_k\":%s,\"tau_prior_h\":%s,"
            "\"ua_w_per_k\":%s,\"thermal_mass_kwh_per_k\":%s,\"tau_h\":%s,"
            "\"return_c\":%s,\"loop_share_pct\":%s,\"absorb_state\":\"%s\","
            "\"absorb_capacity_rank\":%s,\"max_offset_c\":%s,"
            "\"group_id\":\"%s\",\"group_role\":\"%s\","
            "\"wind_exposure\":%.2f,\"solar_gain\":%.2f,"
            "\"pipe_inner_mm\":%.0f,\"pipe_spacing_mm\":%.0f,\"supply_pipe_length_m\":%.1f,"
            "\"house_balance\":%.2f,\"warnings\":[",
            snap->zones[i].area_m2, static_cast<unsigned>(snap->zones[i].exterior_walls & 0x0F),
            lv6::slab_type_to_string(snap->zones[i].slab_type), thick_tok,
            lv6::covering_type_to_string(snap->zones[i].covering), r_ov_tok, c_slab_m2, c_slab,
            c_zone, r_tok, headroom, th.floor_unset ? "true" : "false", ua_prior, ua_learned, conf,
            days_tok, th.ua_source, snap->zones[i].ua_weight_override, ua_eff,
            th.plausible && std::isfinite(th.tau_prior_h) ? tau : "null",
            th.plausible ? ua : "null", th.plausible ? mass : "null",
            th.plausible && std::isfinite(th.tau_prior_h) ? tau : "null", return_c, share,
            absorb_state, rank, max_offset, group_id, lv6::group_role_to_string(role),
            snap->zones[i].wind_exposure, snap->zones[i].solar_gain,
            lv6::pipe_inner_diameter_mm(snap->zones[i].pipe_type), snap->zones[i].pipe_spacing_mm,
            snap->zones[i].supply_pipe_length_m, snap->zone_house_balance[i]);
    bool fw = true;
    if (th.thickness_ignored) {
      appendf(buf, JSON_BUF_SIZE, off, "%s\"thickness_ignored\"", fw ? "" : ",");
      fw = false;
    }
    if (th.high_floor_resistance) {
      appendf(buf, JSON_BUF_SIZE, off, "%s\"high_floor_resistance\"", fw ? "" : ",");
      fw = false;
    }
    appendf(buf, JSON_BUF_SIZE, off, "]}");
  }
  appendf(buf, JSON_BUF_SIZE, off, "]}}");
  send_text_(request, 200, "application/json", buf, true, "no-cache");
}

void LV6Dashboard::handle_zone_(AsyncWebServerRequest *request, uint8_t zone) {
  if (zone < 1 || zone > lv6::NUM_ZONES) {
    this->send_v1_(request, 400, "invalid_zone", "Zone must be in range 1..6");
    return;
  }
  if (snapshot_lock_ == nullptr || !snapshot_ready_ ||
      xSemaphoreTake(snapshot_lock_, pdMS_TO_TICKS(50)) != pdTRUE) {
    send_text_(request, 503, "application/json", "{\"ok\":false,\"error\":{\"code\":\"snapshot_not_ready\"}}",
               true, "no-cache");
    return;
  }
  memcpy(&this->state_snap_buf_, &this->snapshot_, sizeof(this->state_snap_buf_));
  xSemaphoreGive(snapshot_lock_);

  const uint8_t i = zone - 1;
  const DashboardSnapshot *snap = &this->state_snap_buf_;
  const lv6::ZoneConfig &z = snap->zones[i];
  char temp[24], setpoint[24], valve[24], preload[24], probe[24];
  char area[24], spacing[24], max_offset[24];
  char open_ripple[24], close_ripple[24], open_factor[24], close_factor[24];
  char working_ripple[24], pin_free[24];
  format_float_token(temp, sizeof(temp), snap->zone_temp_c[i], 1);
  format_float_token(setpoint, sizeof(setpoint), z.setpoint_c, 1);
  format_float_token(valve, sizeof(valve), snap->zone_valve_pct[i], 0);
  format_float_token(preload, sizeof(preload), snap->zone_preheat_c[i], 1);
  format_float_token(area, sizeof(area), z.area_m2, 1);
  format_float_token(spacing, sizeof(spacing), z.pipe_spacing_mm, 0);
  format_float_token(max_offset, sizeof(max_offset), z.max_offset_c, 2);
  format_float_token(open_ripple, sizeof(open_ripple), snap->motor_open_ripple[i], 0);
  format_float_token(close_ripple, sizeof(close_ripple), snap->motor_close_ripple[i], 0);
  format_float_token(open_factor, sizeof(open_factor), snap->motor_open_factor[i], 2);
  format_float_token(close_factor, sizeof(close_factor), snap->motor_close_factor[i], 2);
  format_float_token(working_ripple, sizeof(working_ripple), snap->motor_working_ripple[i], 0);
  format_float_token(pin_free, sizeof(pin_free), snap->motor_pin_free_ripple[i], 0);
  const char *stroke_model =
      snap->motor_stroke_model[i] == static_cast<uint8_t>(lv6::StrokeModel::WORKING_RANGE)
          ? "working_range"
          : "full_stroke";

  const int8_t probe_idx = snap->probes.zone_return_probe[i];
  if (probe_idx >= 0 && probe_idx < static_cast<int8_t>(lv6::MAX_PROBES))
    format_float_token(probe, sizeof(probe), snap->probe_temp_c[probe_idx], 1);
  else
    snprintf(probe, sizeof(probe), "null");

  char ua[24], mass[24], tau[24], share[24], rank[16];
  const auto th = lv6::thermal_model::estimate(
      z, this->config_store_ ? this->config_store_->get_house_physics() : lv6::HousePhysicsConfig{});
  format_float_token(ua, sizeof(ua), th.ua_w_per_k, 1);
  format_float_token(mass, sizeof(mass), th.thermal_mass_kwh_per_k, 2);
  format_float_token(tau, sizeof(tau), th.tau_h, 1);
  if (std::isfinite(snap->zone_loop_share_pct[i]))
    format_float_token(share, sizeof(share), snap->zone_loop_share_pct[i], 1);
  else
    snprintf(share, sizeof(share), "null");
  if (snap->zone_absorb_capacity_rank[i] > 0)
    snprintf(rank, sizeof(rank), "%u", static_cast<unsigned>(snap->zone_absorb_capacity_rank[i]));
  else
    snprintf(rank, sizeof(rank), "null");
  const char *absorb_state =
      snap->absorb_mode == 2 ? "armed" : (snap->absorb_mode == 1 ? "reactive" : "idle");

  char *buf = this->json_buf_;
  size_t off = 0;
  char age_tok[16];
  if (snap->zone_external_temp_age_ms[i] == UINT32_MAX)
    snprintf(age_tok, sizeof(age_tok), "null");
  else
    snprintf(age_tok, sizeof(age_tok), "%lu",
             static_cast<unsigned long>(snap->zone_external_temp_age_ms[i]));
  char battery_tok[8], humidity_tok[16];
  if (snap->zone_battery_pct[i] >= 0)
    snprintf(battery_tok, sizeof(battery_tok), "%d", static_cast<int>(snap->zone_battery_pct[i]));
  else
    snprintf(battery_tok, sizeof(battery_tok), "null");
  format_float_token(humidity_tok, sizeof(humidity_tok), snap->zone_humidity_pct[i], 0);
  appendf(buf, JSON_BUF_SIZE, off,
          "{\"ok\":true,\"version\":\"v1\",\"data\":{\"zone\":%u,\"name\":\"",
          static_cast<unsigned>(zone));
  append_json_escaped(buf, JSON_BUF_SIZE, off, z.name);
  appendf(buf, JSON_BUF_SIZE, off,
          "\",\"enabled\":%s,\"state\":\"%s\",\"fresh\":%s,"
          "\"temperature_c\":%s,\"setpoint_c\":%s,\"valve_pct\":%s,\"preheat_c\":%s,"
          "\"temp_source\":\"%s\",\"probe_index\":%d,\"probe_temp_c\":%s,\"ble_mac\":\"%s\","
          "\"sensor_id\":\"%s\",\"sensor_name\":\"%s\",\"external_temp_age_ms\":%s,"
          "\"battery_pct\":%s,\"humidity_pct\":%s,"
          "\"ua_w_per_k\":%s,\"thermal_mass_kwh_per_k\":%s,\"tau_h\":%s,"
          "\"return_c\":%s,\"loop_share_pct\":%s,\"absorb_state\":\"%s\","
          "\"absorb_capacity_rank\":%s,"
          "\"settings\":{\"area_m2\":%s,\"pipe_spacing_mm\":%s,\"pipe_type\":%u,"
          "\"sync_to_zone\":%d,\"abs_min_c\":%.1f,\"abs_max_c\":%.1f,"
          "\"min_offset_c\":%.2f,\"max_offset_c\":%.2f},"
          "\"motor\":{\"fault\":\"%s\",\"open_ripples\":%s,\"close_ripples\":%s,"
          "\"open_factor\":%s,\"close_factor\":%s,\"working_ripples\":%s,"
          "\"pin_free_ripples\":%s,\"stroke_model\":\"%s\"}}}",
          z.enabled ? "true" : "false", snap->zone_state[i],
          std::isfinite(snap->zone_temp_c[i]) ? "true" : "false",
          temp, setpoint, valve, preload, temp_source_to_dashboard_str(snap->zone_temp_source[i]),
          probe_idx >= 0 ? static_cast<int>(probe_idx) + 1 : 0, probe, snap->zone_ble_mac[i],
          snap->zone_sensor_id[i], snap->zone_sensor_name[i], age_tok, battery_tok, humidity_tok,
          th.plausible ? ua : "null", th.plausible ? mass : "null",
          th.plausible ? tau : "null", probe, share, absorb_state, rank,
          area, spacing, static_cast<unsigned>(z.pipe_type),
          z.sync_to_zone >= 0 ? static_cast<int>(z.sync_to_zone) + 1 : 0,
          z.abs_min_c, z.abs_max_c, z.min_offset_c, z.max_offset_c,
          snap->motor_fault[i], open_ripple, close_ripple, open_factor, close_factor,
          working_ripple, pin_free, stroke_model);
  send_text_(request, 200, "application/json", buf, true, "no-cache");
}

void LV6Dashboard::handle_settings_(AsyncWebServerRequest *request) {
  if (snapshot_lock_ == nullptr || !snapshot_ready_ ||
      xSemaphoreTake(snapshot_lock_, pdMS_TO_TICKS(50)) != pdTRUE) {
    send_text_(request, 503, "application/json", "{\"ok\":false,\"error\":{\"code\":\"snapshot_not_ready\"}}",
               true, "no-cache");
    return;
  }
  memcpy(&this->state_snap_buf_, &this->snapshot_, sizeof(this->state_snap_buf_));
  xSemaphoreGive(snapshot_lock_);

  const DashboardSnapshot *snap = &this->state_snap_buf_;
  httpd_req_t *req = *request;
  httpd_resp_set_status(req, "200 OK");
  httpd_resp_set_type(req, "application/json");
  httpd_resp_set_hdr(req, "Cache-Control", "no-cache");
  httpd_resp_set_hdr(req, "Connection", "close");

  constexpr size_t BUF_SIZE = 2048;
  char *buf = this->json_buf_;
  size_t off = 0;

  auto flush = [&]() -> bool {
    if (off == 0) return true;
    const bool ok = httpd_resp_send_chunk(req, buf, off) == ESP_OK;
    off = 0;
    return ok;
  };

  char preheat_band[24], preheat_delta[24], min_flow[24];
  char hp_margin[24], hp_base[24], hp_trim[24], hp_demand[24];
  format_float_token(preheat_band, sizeof(preheat_band), snap->preheat_absorb_band_c, 1);
  format_float_token(preheat_delta, sizeof(preheat_delta), snap->preheat_detect_delta_c, 1);
  format_float_token(min_flow, sizeof(min_flow), snap->min_zone_flow_pct, 1);
  format_float_token(hp_margin, sizeof(hp_margin), snap->hp_overheat_margin_c, 1);
  format_float_token(hp_base, sizeof(hp_base), snap->hp_base_pct, 0);
  format_float_token(hp_trim, sizeof(hp_trim), snap->hp_trim_floor_pct, 0);
  format_float_token(hp_demand, sizeof(hp_demand), snap->hp_demand_pct, 0);

  appendf(buf, BUF_SIZE, off,
          "{\"ok\":true,\"version\":\"v1\",\"data\":{\"control\":{"
          "\"simple_preheat_enabled\":%s,\"preheat_absorb_enabled\":%s,"
          "\"preheat_absorb_band_c\":%s,\"preheat_detect_delta_c\":%s,"
          "\"heating_mode\":\"%s\",\"hp_overheat_margin_c\":%s,"
          "\"hp_base_pct\":%s,\"hp_trim_floor_pct\":%s,\"hp_demand_pct\":%s},"
          "\"minimum_flow\":{\"enabled\":%s,\"min_zone_flow_pct\":%s},"
          "\"ble_clock_sync\":{\"enabled\":%s,\"interval_min\":%u,\"last_ok_s\":%lu,"
          "\"last_error\":\"%s\",\"advertising\":%s},"
          "\"manifold\":{\"type\":\"%s\",\"flow_probe\":%d,\"return_probe\":%d},"
          "\"motor\":{\"default_profile\":\"%s\",\"generic_runtime_limit_s\":%lu,"
          "\"hmip_runtime_limit_s\":%lu,\"relearn_after_movements\":%lu,"
          "\"relearn_after_hours\":%lu},"
          "\"authority\":{\"installation_id\":\"%s\",\"coordinator_id\":\"%s\",\"authentication_configured\":%s},\"zones\":[",
          snap->simple_preheat_enabled ? "true" : "false",
          snap->preheat_absorb_enabled ? "true" : "false",
          preheat_band, preheat_delta,
          lv6::heating_profile_to_string(snap->heating_mode), hp_margin, hp_base, hp_trim, hp_demand,
          snap->minimum_flow_always ? "true" : "false", min_flow,
          snap->ble_clock_sync_enabled ? "true" : "false",
          static_cast<unsigned>(snap->ble_clock_sync_interval_min),
          static_cast<unsigned long>(snap->ble_clock_sync_last_ok_s),
          snap->ble_clock_sync_last_error,
          snap->ble_clock_sync_advertising ? "true" : "false",
          snap->manifold_type == lv6::ManifoldType::NC ? "NC" : "NO",
          static_cast<int>(snap->probes.manifold_flow_probe) + 1,
          static_cast<int>(snap->probes.manifold_return_probe) + 1,
          motor_profile_to_api_str(snap->motor.default_profile),
          static_cast<unsigned long>(snap->motor.generic_profile_runtime_limit_s),
          static_cast<unsigned long>(snap->motor.hmip_vdmot_runtime_limit_s),
          static_cast<unsigned long>(snap->motor.relearn_after_movements),
          static_cast<unsigned long>(snap->motor.relearn_after_hours),
          snap->authority.installation_id, snap->authority.coordinator_id,
          snap->authority.shared_key[0] != '\0' ? "true" : "false");
  if (!flush()) return;

  for (uint8_t i = 0; i < lv6::NUM_ZONES; i++) {
    char setpoint[24], area[24], spacing[24], min_offset[24], max_offset[24];
    char abs_min[24], abs_max[24];
    format_float_token(setpoint, sizeof(setpoint), snap->zones[i].setpoint_c, 1);
    format_float_token(area, sizeof(area), snap->zones[i].area_m2, 1);
    format_float_token(spacing, sizeof(spacing), snap->zones[i].pipe_spacing_mm, 0);
    format_float_token(min_offset, sizeof(min_offset), snap->zones[i].min_offset_c, 2);
    format_float_token(max_offset, sizeof(max_offset), snap->zones[i].max_offset_c, 2);
    format_float_token(abs_min, sizeof(abs_min), snap->zones[i].abs_min_c, 1);
    format_float_token(abs_max, sizeof(abs_max), snap->zones[i].abs_max_c, 1);

    appendf(buf, BUF_SIZE, off,
            "%s{\"zone\":%u,\"name\":\"",
            i ? "," : "", static_cast<unsigned>(i + 1));
    append_json_escaped(buf, BUF_SIZE, off, snap->zones[i].name);
    appendf(buf, BUF_SIZE, off,
            "\",\"enabled\":%s,\"setpoint_c\":%s,\"area_m2\":%s,"
            "\"pipe_spacing_mm\":%s,\"pipe_type\":\"%s\",\"temp_source\":\"%s\","
            "\"probe_index\":%d,\"sync_to_zone\":%d,\"ble_mac\":\"%s\","
            "\"limits\":{\"min_offset_c\":%s,\"max_offset_c\":%s,"
            "\"abs_min_c\":%s,\"abs_max_c\":%s},"
            "\"motor_profile\":\"%s\"}",
            snap->zones[i].enabled ? "true" : "false", setpoint, area, spacing,
            pipe_type_to_api_str(snap->zones[i].pipe_type),
            temp_source_to_dashboard_str(snap->zone_temp_source[i]),
            snap->probes.zone_return_probe[i] >= 0 ? static_cast<int>(snap->probes.zone_return_probe[i]) + 1 : 0,
            snap->zones[i].sync_to_zone >= 0 ? static_cast<int>(snap->zones[i].sync_to_zone) + 1 : 0,
            snap->zone_ble_mac[i], min_offset, max_offset, abs_min, abs_max,
            motor_profile_to_api_str(snap->zones[i].motor_profile_override));
    if (!flush()) return;
  }

  appendf(buf, BUF_SIZE, off, "]}}");
  flush();
  httpd_resp_send_chunk(req, nullptr, 0);
}
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
