Birkemosen/lune/lune-v6/components/lv6_valve_controller/lv6_valve_controller.cpp

// =============================================================================
// LV6 Valve Controller — ESPHome Component Implementation
// =============================================================================
// Ported from lib/valve_controller/src/valve_controller.cpp
// Key change: uses ESPHome I2C bus and sensor abstractions instead of raw
// ESP-IDF drivers. The FreeRTOS motor task is preserved because the 10ms
// tick motor FSM cannot run in ESPHome's main loop (too slow, non-deterministic).
// =============================================================================

#include <cstring>
#include "lv6_valve_controller.h"
#include "esphome/core/log.h"
#include "esphome/core/hal.h"
#include "esp_timer.h"
#include "esp_heap_caps.h"
#include "esp_adc/adc_oneshot.h"   // adc_oneshot_io_to_channel() for GPIO→channel mapping
#include "esp_adc/adc_continuous.h"
#include "esp_adc/adc_cali.h"
#include "esp_adc/adc_cali_scheme.h"
#include <algorithm>
#include <utility>
#include <cstdio>
#include <cmath>
#include <cstdarg>
#include <inttypes.h>

// File-static ISR callback: DMA conversion-done → notify ripple processor task.
// Must be in IRAM and return quickly.
static IRAM_ATTR bool ripple_adc_conv_done_(
    adc_continuous_handle_t /*hdl*/,
    const adc_continuous_evt_data_t * /*edata*/,
    void *user_data)
{
  auto *task_handle = static_cast<TaskHandle_t *>(user_data);
  BaseType_t must_yield = pdFALSE;
  vTaskNotifyGiveFromISR(*task_handle, &must_yield);
  portYIELD_FROM_ISR(must_yield);
  return false;
}

namespace lv6 {

static const char *const TAG = "lv6_valve_ctrl";

// =============================================================================
// ESPHome Lifecycle
// =============================================================================

void Lv6ValveController::setup() {
  mean_open_currents_.fill(INITIAL_MEAN_CURRENT_MA);
  mean_close_currents_.fill(INITIAL_MEAN_CURRENT_MA);

  telemetry_mutex_ = xSemaphoreCreateMutex();
  if (telemetry_mutex_ == nullptr) {
    ESP_LOGE(TAG, "Failed to create telemetry mutex");
    this->mark_failed();
    return;
  }

  trace_mutex_ = xSemaphoreCreateMutex();
  if (trace_mutex_ == nullptr) {
    ESP_LOGE(TAG, "Failed to create trace mutex");
    this->mark_failed();
    return;
  }

  trace_samples_ = static_cast<MotorTraceSample *>(
      heap_caps_malloc(TRACE_MAX_SAMPLES * sizeof(MotorTraceSample), MALLOC_CAP_SPIRAM | MALLOC_CAP_8BIT));
  if (trace_samples_ == nullptr) {
    ESP_LOGW(TAG, "PSRAM alloc for trace buffer failed — motor trace disabled");
  } else {
    memset(trace_samples_, 0, TRACE_MAX_SAMPLES * sizeof(MotorTraceSample));
    ESP_LOGI(TAG, "Motor trace buffer: %u samples (%.1f KB) in PSRAM",
             TRACE_MAX_SAMPLES, TRACE_MAX_SAMPLES * sizeof(MotorTraceSample) / 1024.0f);
  }

  cmd_queue_ = xQueueCreate(CMD_QUEUE_LEN, sizeof(ValveCommand));
  if (cmd_queue_ == nullptr) {
    ESP_LOGE(TAG, "Failed to create command queue");
    this->mark_failed();
    return;
  }

  // Load motor config from config store
  if (config_store_) {
    motor_cfg_ = config_store_->get_motor_config();
    sanitize_motor_cfg_();
  }

  if (gpio_backend_enabled_) {
    if (backend_kind_ == MotorBackendKind::REV33_GPIO) {
      // `fault_raw` carries FAULT_N_RAW and is read ACTIVE LOW.
      rev33_pins_.adc_current = ipropi_pin_;
      rev33_pins_.motor_enable = nsleep_pin_;
      rev33_pins_.fault_raw = nfault_pin_;
      if (!probe_board_is_rev33_()) {
        ESP_LOGE(TAG,
                 "Configured for rev33_gpio but the board does not answer like "
                 "Rev 3.3: RAIL_OVERCURRENT GPIO%d and FAULT_USB_RAW GPIO%d have "
                 "no external pull-up. Refusing to drive — on an older board "
                 "GPIO%d is not the drive permit and FAULT_N_RAW's polarity "
                 "differs.",
                 static_cast<int>(rev33_pins_.rail_overcurrent),
                 static_cast<int>(rev33_pins_.fault_usb),
                 static_cast<int>(rev33_pins_.driver_nsleep));
        this->mark_failed();
        return;
      }
      rev33_backend_ = new Rev33MotorBackend(rev33_pins_, rev33_tacho_);
      gpio_backend_ = rev33_backend_;
    } else {
      rev31_pins_.adc_current = ipropi_pin_;
      rev31_pins_.motor_enable = nsleep_pin_;
      rev31_pins_.latch_state = nfault_pin_;
      rev31_backend_ = new Rev31MotorBackend(rev31_pins_, bemf_threshold_raw_);
      gpio_backend_ = rev31_backend_;
    }
    if (!gpio_backend_->setup()) {
      ESP_LOGE(TAG, "%s GPIO/ADC backend setup failed; motors remain inhibited",
               gpio_backend_->backend_name());
      this->mark_failed();
      return;
    }

    const bool armed = gpio_backend_->arm_latch();
    any_driver_present_ = true;  // Three populated dual bridges; actuator presence is learned on first move.
    for (uint8_t i = 0; i < NUM_ZONES; ++i) {
      telemetry_[i].present = true;
      telemetry_[i].presence_known = false;
    }
    drivers_enabled_ = armed && auto_start_calibration_;
    auto_start_done_ = !auto_start_calibration_;
    // The motion counter is fed by the backend, not by the DMA ripple task:
    // BEMF coast samples on Rev 3.1, the hardware commutation count on Rev 3.3.
    ripple_enabled_ = true;
    // Rev 3.3 still needs the ADC stream — for the current itself, and for the
    // analog cross-check on the commutation count. Rev 3.1 reads its ADC through
    // the backend's oneshot driver, so it must not open a continuous one.
    if (rev33_backend_ != nullptr)
      start_adc_stream_();
    if (!drivers_enabled_)
      gpio_backend_->coast();
    if (rev33_backend_) {
      ESP_LOGI(TAG,
               "%s backend ready: permit=%s, DRIVER_N_SLEEP GPIO%d, FAULT_N_RAW GPIO%d, "
               "MOTOR_ENABLE GPIO%d, automatic motion=%s, tacho qualification "
               "%u us min pulse / %" PRIu32 "-%" PRIu32 " us period",
               gpio_backend_->backend_name(), armed ? "clear" : "faulted",
               static_cast<int>(rev33_pins_.driver_nsleep),
               static_cast<int>(rev33_pins_.fault_raw),
               static_cast<int>(rev33_pins_.motor_enable),
               auto_start_calibration_ ? "enabled" : "disabled pending manual enable",
               rev33_tacho_.min_pulse_us, rev33_tacho_.min_period_us,
               rev33_tacho_.max_period_us);
    } else {
      ESP_LOGI(TAG,
               "%s backend ready: latch=%s, automatic motion=%s, BEMF threshold=%u raw",
               gpio_backend_->backend_name(), armed ? "armed" : "faulted",
               auto_start_calibration_ ? "enabled" : "disabled pending manual enable",
               bemf_threshold_raw_);
    }
  } else {

  // Configure nSLEEP (output, default LOW = sleep)
  gpio_config_t nsleep_cfg = {};
  nsleep_cfg.pin_bit_mask = 1ULL << nsleep_pin_;
  nsleep_cfg.mode = GPIO_MODE_OUTPUT;
  nsleep_cfg.pull_up_en = GPIO_PULLUP_DISABLE;
  nsleep_cfg.pull_down_en = GPIO_PULLDOWN_DISABLE;
  gpio_config(&nsleep_cfg);
  set_nsleep_(false);

  // Configure nFAULT (input, active-low, wired-OR)
  gpio_config_t nfault_cfg = {};
  nfault_cfg.pin_bit_mask = 1ULL << nfault_pin_;
  nfault_cfg.mode = GPIO_MODE_INPUT;
  nfault_cfg.pull_up_en = GPIO_PULLUP_ENABLE;
  nfault_cfg.pull_down_en = GPIO_PULLDOWN_DISABLE;
  gpio_config(&nfault_cfg);

  start_adc_stream_();

  // Wake DRV8215 chips for initial probe/setup only.  Keep the bus asleep
  // after probing if this PCB has no matching drivers; otherwise a pinout or
  // power mismatch can draw current and destabilise WiFi before networking is
  // even started.
  set_nsleep_(true);
  vTaskDelay(pdMS_TO_TICKS(5));

  // Create DRV8215 instances
  for (uint8_t i = 0; i < NUM_ZONES; i++) {
    drivers_[i] = new DRV8215(i2c_bus_, motor_addresses_[i], i + 1);
    if (!drivers_[i]->init()) {
      ESP_LOGW(TAG, "Motor %d init failed (addr 0x%02X)", i + 1, motor_addresses_[i]);
      telemetry_[i].present = false;
      telemetry_[i].presence_known = true;
    } else {
      telemetry_[i].present = true;
      telemetry_[i].presence_known = true;
      any_driver_present_ = true;
    }
  }

  log_startup_self_test_();

  // Boot default: only keep the motor bus awake when at least one expected
  // driver answered.  With no ACKs, leave nSLEEP low and permanently skip the
  // automatic calibration pass.  This is both safer for a mismatched PCB and
  // prevents a floating IPROPI input from producing false critical faults.
  if (any_driver_present_) {
    if (!DEVELOPMENT_KEEP_NSLEEP_AWAKE)
      set_nsleep_(true);
    drivers_enabled_ = true;
    ESP_LOGI(TAG, "Motors start enabled; auto-calibration will run in %" PRIu32 "s",
             AUTO_START_DELAY_MS / 1000);
  } else {
    set_nsleep_(false);
    drivers_enabled_ = false;
    auto_start_done_ = true;
    ESP_LOGW(TAG, "No DRV8215 drivers detected; motors remain disabled and auto-calibration is skipped");
  }
  if (DEVELOPMENT_KEEP_NSLEEP_AWAKE)
    ESP_LOGW(TAG, "Development mode: nSLEEP kept HIGH to avoid enable-time reboot");
  }

  // Load persisted calibration data
  if (config_store_) {
    for (uint8_t i = 0; i < NUM_ZONES; i++) {
      MotorTelemetry saved;
      if (config_store_->load_motor_telemetry(i, saved)) {
        xSemaphoreTake(telemetry_mutex_, portMAX_DELAY);
        telemetry_[i].learned_open_ms = saved.learned_open_ms;
        telemetry_[i].learned_close_ms = saved.learned_close_ms;
        telemetry_[i].deadzone_ms = saved.deadzone_ms;
        telemetry_[i].mean_current_ma = saved.mean_current_ma;
        telemetry_[i].mean_open_current_ma = saved.mean_open_current_ma;
        telemetry_[i].mean_close_current_ma = saved.mean_close_current_ma;
        telemetry_[i].movement_count = saved.movement_count;
        telemetry_[i].movements_since_learn = saved.movements_since_learn;
        // last_learn_ms is boot-relative (esp_timer ms). Restoring a prior boot's
        // value makes (now - last) underflow (~1193h) and spuriously auto-relearn
        // the moment drivers are enabled — which stack-overflowed lv6_valve.
        // Restart the relearn clock from this boot; learned factors still load.
        telemetry_[i].last_learn_ms =
            static_cast<uint32_t>(esp_timer_get_time() / 1000);
        telemetry_[i].learned_open_ripples = saved.learned_open_ripples;
        telemetry_[i].learned_close_ripples = saved.learned_close_ripples;
        telemetry_[i].pin_engage_close_ripples = saved.pin_engage_close_ripples;
        telemetry_[i].learned_open_current_factor = saved.learned_open_current_factor;
        telemetry_[i].learned_close_current_factor = saved.learned_close_current_factor;
        telemetry_[i].learned_open_confidence = saved.learned_open_confidence;
        telemetry_[i].learned_close_confidence = saved.learned_close_confidence;
        telemetry_[i].last_open_candidate_factor = saved.last_open_candidate_factor;
        telemetry_[i].last_close_candidate_factor = saved.last_close_candidate_factor;
        telemetry_[i].last_open_peak_ma = saved.last_open_peak_ma;
        telemetry_[i].last_close_peak_ma = saved.last_close_peak_ma;
        telemetry_[i].last_learning_sample_valid = saved.last_learning_sample_valid;
        telemetry_[i].last_fault_code = saved.last_fault_code;
        // An overrun stays blocked across a restart: re-homing again would push
        // the plunger another full stroke. Reset it from the zone's fault panel.
        if (saved.last_fault_code == FaultCode::MECHANICAL_OVERRUN) {
          telemetry_[i].blocked = true;
          fault_dir_[i] = MotorDirection::CLOSE;
          ESP_LOGW(TAG, "Zone %d restored blocked (mechanical overrun); reset it in the zone", i + 1);
        }
        // Seed per-direction means from the durable telemetry. A blob written by
        // a pre-v19 build (size mismatch) won't load at all, so these fields carry
        // their struct defaults; once loaded they hold the learned per-direction means.
        mean_open_currents_[i] = saved.mean_open_current_ma;
        mean_close_currents_[i] = saved.mean_close_current_ma;
        xSemaphoreGive(telemetry_mutex_);
      }
    }
  }

  // Last known positions. Restored as a hint only: the position stays
  // unconfirmed, so the first move still re-homes, but the seat check knows
  // where the seat should be instead of assuming the valve is closed.
  if (config_store_) {
    float pos[NUM_ZONES];
    if (config_store_->load_motor_positions(pos, NUM_ZONES)) {
      xSemaphoreTake(telemetry_mutex_, portMAX_DELAY);
      for (uint8_t i = 0; i < NUM_ZONES; i++) {
        if (std::isfinite(pos[i])) {
          telemetry_[i].current_position_pct = std::clamp(pos[i], 0.0f, 100.0f);
          persisted_pos_[i] = telemetry_[i].current_position_pct;
        }
      }
      xSemaphoreGive(telemetry_mutex_);
      ESP_LOGI(TAG, "Restored positions: %.0f %.0f %.0f %.0f %.0f %.0f %%", pos[0], pos[1], pos[2],
               pos[3], pos[4], pos[5]);
    }
  }

  // Start motor FSM task on Core 1
  BaseType_t ok = xTaskCreatePinnedToCore(
      task_func_, "lv6_valve", STACK_SIZE, this, PRIORITY, &task_handle_, CORE);
  if (ok != pdPASS) {
    ESP_LOGE(TAG, "Failed to create valve task");
    this->mark_failed();
    return;
  }

  boot_time_ms_ = static_cast<uint32_t>(esp_timer_get_time() / 1000);

  // Restore user preference for drivers armed across reboot. Missing key keeps
  // the hardware boot default (rev33: off until manual enable; I2C: on if present).
  bool want_drivers = false;
  if (config_store_ && config_store_->load_drivers_enabled_pref(&want_drivers)) {
    ESP_LOGI(TAG, "Restoring drivers_enabled preference: %s", want_drivers ? "on" : "off");
    set_drivers_enabled(want_drivers);
  }

  ESP_LOGI(TAG, "Valve controller initialized (%d motors)", NUM_ZONES);
}

void Lv6ValveController::dump_config() {
  ESP_LOGCONFIG(TAG, "LV6 Valve Controller:");
  ESP_LOGCONFIG(TAG, "  backend: %s",
                gpio_backend_ ? gpio_backend_->backend_name()
                              : (gpio_backend_enabled_ ? "gpio (not built)" : "drv8215_i2c"));
  if (rev33_backend_) {
    ESP_LOGCONFIG(TAG,
                  "  MOTOR_ENABLE GPIO%d, DRIVER_N_SLEEP GPIO%d (high = permit), "
                  "FAULT_N_RAW GPIO%d (low = asserted)",
                  nsleep_pin_, static_cast<int>(rev33_pins_.driver_nsleep), nfault_pin_);
    ESP_LOGCONFIG(TAG,
                  "  RAIL_OVERCURRENT GPIO%d, FAULT_USB_RAW GPIO%d (both active low)",
                  static_cast<int>(rev33_pins_.rail_overcurrent),
                  static_cast<int>(rev33_pins_.fault_usb));
    ESP_LOGCONFIG(TAG, "  ADDR GPIO%d/%d/%d/%d (4-bit, 12-entry map; no direction bit)",
                  rev33_pins_.address0, rev33_pins_.address1,
                  rev33_pins_.address2, rev33_pins_.address3);
    ESP_LOGCONFIG(TAG, "  ADC_CURRENT GPIO%d @6dB, ADC_TACHO GPIO%d%s, COMM_TACHO_N GPIO%d, auto-calibration=%s",
                  ipropi_pin_, rev33_pins_.adc_tacho,
                  adc_tacho_enabled_ ? "" : " (off)",
                  rev33_pins_.comm_tacho,
                  auto_start_calibration_ ? "yes" : "no");
    return;
  }
  if (gpio_backend_enabled_) {
    ESP_LOGCONFIG(TAG, "  MOTOR_ENABLE GPIO%d, LATCH_STATE GPIO%d, ADC_CURRENT GPIO%d, ADC_BEMF GPIO%d",
                  nsleep_pin_, nfault_pin_, ipropi_pin_, rev31_pins_.adc_bemf);
    ESP_LOGCONFIG(TAG, "  ADDR GPIO%d/%d/%d, DIR GPIO%d, LATCH_ARM GPIO%d, auto-calibration=%s",
                  rev31_pins_.address0, rev31_pins_.address1, rev31_pins_.address2,
                  rev31_pins_.terminal_direction, rev31_pins_.latch_arm,
                  auto_start_calibration_ ? "yes" : "no");
    return;
  }
  ESP_LOGCONFIG(TAG, "  nSLEEP pin: GPIO%d", nsleep_pin_);
  ESP_LOGCONFIG(TAG, "  nFAULT pin: GPIO%d", nfault_pin_);
  ESP_LOGCONFIG(TAG, "  IPROPI pin: GPIO%d  ripple=%s  dma=%s", ipropi_pin_,
                ripple_enabled_ ? "yes" : "no",
                adc_continuous_handle_ ? "yes" : "no");
  for (uint8_t i = 0; i < NUM_ZONES; i++) {
    ESP_LOGCONFIG(TAG, "  Motor %d: addr=0x%02X present=%s", i + 1,
                  motor_addresses_[i], telemetry_[i].present ? "yes" : "no");
  }
}

void Lv6ValveController::log_startup_self_test_() {
  ESP_LOGI(TAG, "Startup self-test:");

  int nfault_level = gpio_get_level(nfault_pin_);
  ESP_LOGI(TAG, "  nFAULT GPIO%d level=%d (%s)", nfault_pin_, nfault_level,
           nfault_level ? "HIGH" : "LOW (asserted)");

  char discovered[256];
  int off = 0;
  auto append_discovered = [&](const char *fmt, ...) {
    if (off < 0 || off >= static_cast<int>(sizeof(discovered)))
      return;
    va_list args;
    va_start(args, fmt);
    int n = std::vsnprintf(discovered + off, sizeof(discovered) - off, fmt, args);
    va_end(args);
    if (n > 0)
      off += n;
  };
  append_discovered("  I2C ACK addresses:");
  bool found_any = false;

  for (uint8_t addr = 0x03; addr <= 0x77; addr++) {
    esphome::i2c::I2CDevice dev;
    dev.set_i2c_bus(i2c_bus_);
    dev.set_i2c_address(addr);
    auto err = dev.write(nullptr, 0);
    if (err == esphome::i2c::ERROR_OK) {
      found_any = true;
      append_discovered(" 0x%02X", addr);
      if (off >= static_cast<int>(sizeof(discovered)) - 6)
        break;
    }
  }

  if (!found_any) {
    std::snprintf(discovered, sizeof(discovered), "  I2C ACK addresses: none");
  }
  ESP_LOGI(TAG, "%s", discovered);

  for (uint8_t i = 0; i < NUM_ZONES; i++) {
    ESP_LOGI(TAG, "  Motor %d addr=0x%02X present=%s", i + 1, motor_addresses_[i],
             telemetry_[i].present ? "yes" : "no");
  }
}

void Lv6ValveController::loop() {
  // Publish latest current to ESPHome sensor only while a motor is running
  if (!motor_turning_ || !current_sensor_)
    return;
  uint32_t now = esphome::millis();
  if (now - last_publish_ms_ >= 500) {
    last_publish_ms_ = now;
    current_sensor_->publish_state(latest_current_ma_);
  }
}

// =============================================================================
// Public API (thread-safe)
// =============================================================================

void Lv6ValveController::isolate_drive_fault_(const char *what) {
  // Only one motor is ever driven, so a fault net that fires mid-move belongs
  // to that motor. Stop and block it; the other five keep working. The drivers
  // go off only when the net is still asserted with every bridge idle: that is
  // the board itself (short, thermal, rail), a critical fault.
  const uint8_t zone = current_zone_;
  // Which net fired (0 = asserted): bridge fault, the 150 mA rail comparator, USB limit.
  const int raw = rev33_backend_ ? rev33_backend_->fault_raw_level() : -1;
  const int rail = rev33_backend_ ? rev33_backend_->rail_overcurrent_level() : -1;
  const int usb = rev33_backend_ ? rev33_backend_->fault_usb_level() : -1;
  const uint32_t ran_ms = motor_run_time_ms_;
  trigger_fault_(FaultCode::UNKNOWN_FAULT, what);   // stops the motor, drops the permit
  if (zone < NUM_ZONES) {
    xSemaphoreTake(telemetry_mutex_, portMAX_DELAY);
    telemetry_[zone].blocked = true;               // until the fault is reset
    xSemaphoreGive(telemetry_mutex_);
  }
  if (!gpio_backend_)
    return;
  gpio_backend_->coast();
  vTaskDelay(pdMS_TO_TICKS(FAULT_SETTLE_MS));
  if (gpio_backend_->arm_latch()) {
    gpio_backend_->coast();
    const uint32_t now = static_cast<uint32_t>(esp_timer_get_time() / 1000);
    if (zone < NUM_ZONES && ran_ms < BREAKAWAY_MS) {
      if (breakaway_count_[zone] == 0 || now - breakaway_first_ms_[zone] > BREAKAWAY_WINDOW_MS) {
        breakaway_count_[zone] = 0;
        breakaway_first_ms_[zone] = now;
      }
      breakaway_count_[zone]++;
      if (breakaway_count_[zone] < BREAKAWAY_TRIES) {
        xSemaphoreTake(telemetry_mutex_, portMAX_DELAY);
        telemetry_[zone].blocked = false;
        telemetry_[zone].last_fault_code = FaultCode::NONE;
        xSemaphoreGive(telemetry_mutex_);
        current_fault_code_ = FaultCode::NONE;
        move_aborted_ = true;   // the move did not happen: keep the old position
        ESP_LOGW(TAG, "Motor %d breakaway fault after %" PRIu32 " ms (raw=%d rail=%d usb=%d, 0 = asserted); "
                      "retrying later (%u/%u)", zone + 1, ran_ms, raw, rail, usb,
                 static_cast<unsigned>(breakaway_count_[zone]), static_cast<unsigned>(BREAKAWAY_TRIES));
        return;
      }
    }
    ESP_LOGW(TAG, "Motor %d blocked after '%s' at %" PRIu32 " ms (raw=%d rail=%d usb=%d, 0 = asserted); "
                  "the other motors keep running", zone + 1, what, ran_ms, raw, rail, usb);
    return;
  }
  drivers_enabled_ = false;
  note_drivers_off_("fault");
  gpio_backend_->set_drive_permit(false);
  ESP_LOGE(TAG, "Fault net still asserted with all motors idle after '%s': drivers off", what);
}

void Lv6ValveController::note_drivers_off_(const char *reason) {
  const uint32_t now = static_cast<uint32_t>(esp_timer_get_time() / 1000);
  drivers_off_reason_ = reason;
  drivers_off_ms_ = now == 0 ? 1 : now;
  // OTA normally reboots within a minute or two; only a failed one lands here.
  const uint32_t first = std::strcmp(reason, "ota") == 0 ? 5UL * DRIVER_RECOVER_FIRST_MS : DRIVER_RECOVER_FIRST_MS;
  uint32_t wait = first;
  for (uint8_t i = 0; i < drivers_recover_count_ && wait < DRIVER_RECOVER_MAX_MS; i++)
    wait *= 2;
  drivers_recover_next_ms_ = now + std::min(wait, DRIVER_RECOVER_MAX_MS);
}

uint32_t Lv6ValveController::drivers_off_age_s() const {
  if (drivers_enabled_ || drivers_off_ms_ == 0)
    return 0;
  return (static_cast<uint32_t>(esp_timer_get_time() / 1000) - drivers_off_ms_) / 1000u;
}

void Lv6ValveController::maybe_recover_drivers_() {
  if (!drivers_want_on_.load(std::memory_order_acquire) || motor_turning_ || calibrating_)
    return;
  const uint32_t now = static_cast<uint32_t>(esp_timer_get_time() / 1000);
  if (drivers_off_ms_ == 0)
    note_drivers_off_("boot");   // wanted on but never armed: schedule a first try
  if (static_cast<int32_t>(now - drivers_recover_next_ms_) < 0)
    return;
  const char *reason = drivers_off_reason_;
  if (drivers_recover_count_ < 255)
    drivers_recover_count_++;
  set_drivers_enabled(true, /*persist=*/false);
  if (drivers_enabled_)
    ESP_LOGW(TAG, "Motor drivers re-enabled after '%s' (attempt %u)", reason,
             static_cast<unsigned>(drivers_recover_count_));
  else
    ESP_LOGW(TAG, "Motor drivers still off after '%s' (attempt %u); retrying later", reason,
             static_cast<unsigned>(drivers_recover_count_));
}

void Lv6ValveController::set_drivers_enabled(bool enabled, bool persist) {
  if (persist)
    drivers_want_on_.store(enabled, std::memory_order_release);
  if (!enabled) {
    for (uint8_t z = 0; z < NUM_ZONES; z++)
      position_confident_[z] = false;
  }
  if (enabled && !any_driver_present_) {
    ESP_LOGW(TAG, "Motor enable rejected: no compatible driver backend detected");
    return;
  }

  if (gpio_backend_enabled_) {
    if (!gpio_backend_)
      return;
    if (!enabled) {
      if (motor_turning_)
        stop_motor_(false);
      gpio_backend_->coast();
      // Rev 3.3 holds the drive permit in firmware, so disabling has to release
      // it; on revisions with a latch this is a no-op.
      gpio_backend_->set_drive_permit(false);
      drivers_enabled_ = false;
      note_drivers_off_(persist ? "user" : "ota");
      if (config_store_ && persist)
        config_store_->set_drivers_enabled_pref(false);
      ESP_LOGI(TAG, "%s motor path DISABLED", gpio_backend_->backend_name());
      return;
    }
    // Rev 3.3 raises DRIVER_N_SLEEP and refuses if a fault net is asserted;
    // Rev 3.1 arms its fault latch.
    const bool armed = gpio_backend_->arm_latch();
    if (!armed) {
      drivers_enabled_ = false;
      note_drivers_off_("arm");
      ESP_LOGE(TAG, "%s motor enable rejected: %s",
               gpio_backend_->backend_name(),
               rev33_backend_ ? "fault net asserted" : "latch did not arm");
      return;
    }
    gpio_backend_->coast();
    drivers_enabled_ = true;
    drivers_off_reason_ = "";
    drivers_off_ms_ = 0;
    drivers_on_ms_ = static_cast<uint32_t>(esp_timer_get_time() / 1000);
    if (config_store_ && persist)
      config_store_->set_drivers_enabled_pref(true);
    ESP_LOGI(TAG, "%s motor path ENABLED (decoder remains inhibited until a move)",
             gpio_backend_->backend_name());
    return;
  }

  if (enabled == drivers_enabled_)
    return;

  // Ignore disable commands briefly after boot to reduce sensitivity to
  // replayed startup commands. Always allow disable while a motor is turning
  // so STOP actions remain responsive during startup.
  if (!enabled && !motor_turning_ && boot_time_ms_ > 0) {
    uint32_t uptime_ms = static_cast<uint32_t>(esp_timer_get_time() / 1000) - boot_time_ms_;
    if (uptime_ms < 5000) {
      ESP_LOGW(TAG, "Driver disable ignored during startup window (%" PRIu32 "ms)", uptime_ms);
      return;
    }
  }

  if (!enabled && motor_turning_) {
    stop_motor_(false);
    ESP_LOGW(TAG, "Motor stopped due to driver disable");
  }

  if (!DEVELOPMENT_KEEP_NSLEEP_AWAKE)
    set_nsleep_(enabled);
  drivers_enabled_ = enabled;

  if (enabled) {
    // Explicitly coast all drivers to prevent unwanted movement
    for (uint8_t i = 0; i < NUM_ZONES; i++) {
      if (drivers_[i])
        drivers_[i]->coast();
    }
    vTaskDelay(pdMS_TO_TICKS(5));
  } else {
    // Logical disable in development mode: force all drivers to coast.
    for (uint8_t i = 0; i < NUM_ZONES; i++) {
      if (drivers_[i])
        drivers_[i]->coast();
    }
  }

  if (config_store_ && persist)
    config_store_->set_drivers_enabled_pref(enabled);

  ESP_LOGI(TAG, "Motor drivers %s", enabled ? "ENABLED" : "DISABLED");
}

bool Lv6ValveController::probe_board_is_rev33_() {
  // Both nets are open-drain with a 10k pull-up to 3V3_LOGIC on Rev 3.3 and
  // absent entirely on earlier boards. Pulling down internally (~45k) and reading back
  // therefore separates them: the external 10k wins, a floating pad does not.
  // Two independent witnesses, because getting this wrong means driving a board
  // whose FAULT_N_RAW polarity is inverted.
  const gpio_num_t probes[2] = {rev33_pins_.rail_overcurrent, rev33_pins_.fault_usb};
  int high = 0;
  for (gpio_num_t pin : probes) {
    gpio_config_t cfg = {};
    cfg.pin_bit_mask = 1ULL << static_cast<uint32_t>(pin);
    cfg.mode = GPIO_MODE_INPUT;
    cfg.pull_up_en = GPIO_PULLUP_DISABLE;
    cfg.pull_down_en = GPIO_PULLDOWN_ENABLE;
    if (gpio_config(&cfg) != ESP_OK)
      return false;
    // The 1 nF at the module end against 10k is ~10 us; a millisecond is ample.
    vTaskDelay(pdMS_TO_TICKS(1));
    if (gpio_get_level(pin))
      high++;
  }
  if (high == 1) {
    ESP_LOGE(TAG,
             "Board revision probe is inconsistent: exactly one of GPIO%d/GPIO%d "
             "reads high. Refusing to guess.",
             static_cast<int>(probes[0]), static_cast<int>(probes[1]));
    return false;
  }
  ESP_LOGI(TAG, "Board revision probe: %s", high == 2 ? "Rev 3.3" : "not Rev 3.3");
  return high == 2;
}

bool Lv6ValveController::probe_decoder(uint8_t zone, bool reverse, uint32_t hold_ms,
                                       Rev33MotorBackend::DecoderProbe *out) {
  if (rev33_backend_ == nullptr || out == nullptr)
    return false;
  // Refuse while a real move owns the bridges; the probe drives the same pins.
  if (is_motor_busy() || is_calibrating())
    return false;
  *out = rev33_backend_->probe_decoder(zone, reverse, hold_ms);
  return true;
}

void Lv6ValveController::reload_motor_config() {
  if (config_store_) {
    motor_cfg_ = config_store_->get_motor_config();
    sanitize_motor_cfg_();
  }
  ESP_LOGI(TAG, "Motor config: profile=%s runtime(user=%" PRIu32 "s generic=%" PRIu32 "s hmip=%" PRIu32 "s) close(%.2fx, slope %.2f mA/s, floor %.2fx) "
           "open(%.2fx, slope %.2f mA/s, floor %.2fx, ripple_lim %.2f) "
           "pin(step %.1f mA, margin %" PRIu16 ") learning(samples=%u, dev=%.0f%%, auto=%s)",
           motor_profile_to_string(motor_cfg_.default_profile),
           motor_cfg_.max_runtime_s, motor_cfg_.generic_profile_runtime_limit_s,
           motor_cfg_.hmip_vdmot_runtime_limit_s,
           motor_cfg_.close_current_factor, motor_cfg_.close_slope_threshold_ma_per_s,
           motor_cfg_.close_slope_current_factor,
           motor_cfg_.open_current_factor, motor_cfg_.open_slope_threshold_ma_per_s,
           motor_cfg_.open_slope_current_factor, motor_cfg_.open_ripple_limit_factor,
           motor_cfg_.pin_engage_step_ma, motor_cfg_.pin_engage_margin_ripples,
           motor_cfg_.learned_factor_min_samples,
           motor_cfg_.learned_factor_max_deviation_pct * 100.0f,
           motor_cfg_.auto_apply_learned_factors ? "yes" : "no");
}

MotorProfile Lv6ValveController::effective_motor_profile_(uint8_t zone) const {
  if (!config_store_ || zone >= NUM_ZONES)
    return motor_cfg_.default_profile;
  MotorProfile profile = config_store_->read([zone](const DeviceConfig &cfg) {
    const MotorProfile p = cfg.zones[zone].motor_profile_override;
    return p == MotorProfile::INHERIT ? cfg.motor.default_profile : p;
  });
  if (profile == MotorProfile::INHERIT)
    profile = MotorProfile::HMIP_VDMOT;
  return profile;
}

uint32_t Lv6ValveController::effective_runtime_limit_s_(uint8_t zone) const {
  switch (effective_motor_profile_(zone)) {
    case MotorProfile::HMIP_VDMOT:
      // Hard mechanical ceiling — never honour an NVS value above 40 s.
      return std::max<uint32_t>(
          1, std::min({motor_cfg_.hmip_vdmot_runtime_limit_s, HMIP_VDMOT_RUNTIME_LIMIT_MAX_S,
                       motor_cfg_.max_runtime_s}));
    case MotorProfile::GENERIC:
    case MotorProfile::INHERIT:
    default:
      // Generic actuators have no shared mechanical ceiling — honour the
      // configured profile limit as-is (UI/backup still apply a soft upper bound).
      return std::max<uint32_t>(1, motor_cfg_.generic_profile_runtime_limit_s);
  }
}

MoveCeilingInputs Lv6ValveController::build_ceiling_inputs_(
    uint8_t zone, MotorDirection dir, bool drive_to_endstop, bool calibrating,
    uint32_t timed_duration_ms) const {
  const bool is_open = (dir == MotorDirection::OPEN);
  MoveCeilingInputs in{};
  in.direction_is_open = is_open;
  in.calibrating = calibrating;
  in.drive_to_endstop = drive_to_endstop;
  in.timed_duration_ms = timed_duration_ms;

  uint32_t learned_ms = 0, learned_counts = 0;
  float pos_pct = 0.0f;
  if (zone < NUM_ZONES) {
    xSemaphoreTake(telemetry_mutex_, portMAX_DELAY);
    learned_ms = is_open ? telemetry_[zone].learned_open_ms
                         : telemetry_[zone].learned_close_ms;
    learned_counts = is_open ? telemetry_[zone].learned_open_ripples
                             : telemetry_[zone].learned_close_ripples;
    pos_pct = telemetry_[zone].current_position_pct;
    xSemaphoreGive(telemetry_mutex_);
  }
  in.learned_stroke_ms = learned_ms;
  in.learned_stroke_counts = ripple_enabled_ ? learned_counts : 0;

  in.position_confident = zone < NUM_ZONES && position_confident_[zone];
  if (learning_active_) {
    in.learned_stroke_ms = 0;
    in.learned_stroke_counts = 0;
    in.position_confident = false;
  }
  float remaining = is_open ? (100.0f - pos_pct) : pos_pct;
  // A drive into the seat also has to press the seat home (past pin contact)
  // and absorb count drift from the open leg; the seat itself stops it, and the
  // mechanical bootstrap ceiling below still caps it. Without this a valve held
  // at 5.8 % overran a 265-count window and was blocked (2026-10-09).
  if (drive_to_endstop && !is_open)
    remaining += SEAT_APPROACH_MARGIN_PCT;
  in.remaining_fraction = std::clamp(remaining, 0.0f, 100.0f) / 100.0f;

  // The HmIP ceiling is the mechanical one; a GENERIC profile is not known to
  // eject its plunger, so it keeps the looser per-profile limit.
  const bool hmip = effective_motor_profile_(zone) == MotorProfile::HMIP_VDMOT;
  if (hmip) {
    in.bootstrap_ms = (is_open ? motor_cfg_.hmip_vdmot_open_runtime_limit_s
                               : motor_cfg_.hmip_vdmot_runtime_limit_s) * 1000u;
    in.bootstrap_counts = is_open ? motor_cfg_.open_runtime_limit_counts
                                  : motor_cfg_.close_runtime_limit_counts;
    // A learning close returns over the open leg it just counted plus the seat;
    // a long free travel needs more than the fixed ceiling (Toilet, 1. sal: 2200
    // open, wall past 2601). Still within the plunger's travel budget.
    if (learning_active_ && !is_open && cal_seat_expected_ > 0)
      in.bootstrap_counts = std::max(
          in.bootstrap_counts,
          std::min(LEARN_CLOSE_CEILING_MAX_COUNTS,
                   static_cast<uint32_t>(cal_seat_expected_ * LEARN_CLOSE_CEILING_FACTOR)));
  } else {
    in.bootstrap_ms = motor_cfg_.generic_profile_runtime_limit_s * 1000u;
    in.bootstrap_counts = 0;  // no count ceiling for an uncharacterised actuator
  }
  in.overrun_budget_ms = is_open ? motor_cfg_.open_overrun_budget_ms
                                 : motor_cfg_.close_overrun_budget_ms;
  in.overrun_budget_counts = is_open ? motor_cfg_.open_overrun_budget_counts
                                     : motor_cfg_.close_overrun_budget_counts;
  in.stroke_uncertainty_pct = motor_cfg_.stroke_uncertainty_pct;
  in.runtime_floor_ms = motor_cfg_.runtime_floor_ms;
  in.user_max_runtime_ms = motor_cfg_.max_runtime_s * 1000u;
  return in;
}

float Lv6ValveController::learned_stall_ma_(uint8_t zone, MotorDirection dir) const {
  if (zone >= NUM_ZONES)
    return 0.0f;
  xSemaphoreTake(telemetry_mutex_, portMAX_DELAY);
  const float v = (dir == MotorDirection::OPEN) ? telemetry_[zone].last_open_peak_ma
                                                : telemetry_[zone].last_close_peak_ma;
  xSemaphoreGive(telemetry_mutex_);
  // Reject anything the actuator cannot actually draw, so a polluted value
  // cannot push a computed threshold out of reach.
  if (v < 20.0f || v > RAIL_COMPARATOR_TRIP_MA)
    return 0.0f;
  return v;
}

bool Lv6ValveController::rehome_required_(uint8_t zone) const {
  if (zone >= NUM_ZONES)
    return false;
  // Closing this zone right now would starve the loop.
  if (rehome_inhibited_.load(std::memory_order_relaxed))
    return false;
  // Nothing to open by afterwards.
  uint32_t learned_open = 0;
  xSemaphoreTake(telemetry_mutex_, portMAX_DELAY);
  learned_open = telemetry_[zone].learned_open_ripples;
  xSemaphoreGive(telemetry_mutex_);
  if (!ripple_enabled_ || learned_open == 0)
    return false;

  switch (motor_cfg_.rehome_policy) {
    case RehomePolicy::NEVER:
      return false;
    case RehomePolicy::EVERY_MOVE:
      return true;
    case RehomePolicy::OPPORTUNISTIC:
      // Only when the close leg is free anyway, which an intermediate target
      // never is - so this policy re-homes solely via the 0% fast path.
      return false;
    case RehomePolicy::PERIODIC: {
      if (moves_since_rehome_[zone] >= motor_cfg_.rehome_after_moves)
        return true;
      const uint32_t now_ms = static_cast<uint32_t>(esp_timer_get_time() / 1000);
      const uint32_t age_ms = now_ms - last_rehome_ms_[zone];
      return last_rehome_ms_[zone] != 0 &&
             age_ms >= motor_cfg_.rehome_after_hours * 3600000u;
    }
  }
  return false;
}

CapLadder Lv6ValveController::cap_ladder_() const {
  CapLadder l{};
  l.seat_ma = motor_cfg_.cap_close_seat_ma;
  l.popoff_ma = motor_cfg_.cap_close_popoff_ma;
  l.stall_ma = motor_cfg_.cap_stall_ma;
  l.circuit_ma = motor_cfg_.cap_circuit_fault_ma;
  l.open_stop_ma = motor_cfg_.cap_open_stop_ma;
  l.seat_frames = motor_cfg_.cap_close_seat_frames;
  l.popoff_frames = motor_cfg_.cap_close_popoff_frames;
  l.stall_frames = motor_cfg_.cap_stall_frames;
  l.circuit_frames = motor_cfg_.cap_circuit_frames;
  l.open_frames = motor_cfg_.cap_open_frames;
  l.min_valid_samples = motor_cfg_.cap_min_valid_samples;
  return l;
}

void Lv6ValveController::refresh_move_limit_(uint32_t timed_duration_ms) {
  move_limit_ = compute_move_ceiling(build_ceiling_inputs_(
      current_zone_, current_dir_, drive_to_endstop_active_, calibrating_,
      timed_duration_ms));
  ESP_LOGD(TAG, "Motor %d ceiling %" PRIu32 "ms / %" PRIu32 " counts (src=%d)",
           current_zone_ + 1, move_limit_.limit_ms, move_limit_.limit_counts,
           static_cast<int>(move_limit_.source));
}

StallModelConfig Lv6ValveController::stall_model_cfg_() const {
  StallModelConfig c{};
  c.window_ms = motor_cfg_.spurious_window_ms;
  c.min_current_rise_ma = motor_cfg_.spurious_current_rise_ma;
  c.min_cadence_rise_hz = motor_cfg_.spurious_cadence_rise_hz;
  c.confirm_samples = motor_cfg_.spurious_confirm_samples;
  return c;
}

float Lv6ValveController::effective_current_factor_(uint8_t zone, MotorDirection dir) const {
  bool is_opening = (dir == MotorDirection::OPEN);
  float factor = is_opening ? motor_cfg_.open_current_factor : motor_cfg_.close_current_factor;

  if (config_store_ && zone < NUM_ZONES) {
    const float manual_override = config_store_->read([zone, is_opening](const DeviceConfig &cfg) {
      const auto &zone_cfg = cfg.zones[zone];
      return is_opening ? zone_cfg.motor_open_current_factor_override
                        : zone_cfg.motor_close_current_factor_override;
    });
    if (manual_override > 0.0f)
      return manual_override;
  }

  // Factor learning is a fixed-point iteration on this path and is disabled.
  // update_learned_factor_() computes peak/average, but the trip stops the motor
  // the instant the threshold is crossed, so peak ~= threshold = average *
  // factor - it re-learns whatever it was just given, and any downward excursion
  // ratchets the trip permanently lower. VdMot's own logs measure the effect: a
  // 70 -> 65 mA limit change moved their learned stroke ~5% in both directions.
  //
  // What is learned instead is loop-free because it is measured BEFORE the trip
  // and cannot be influenced by where the stop was declared: the free-travel
  // baseline, the endpoint current, and the ripple counts. The candidate factor
  // is still computed and stored for Motor Lab; it just no longer feeds back.
  if (rev33_backend_ != nullptr)
    return factor;

  if (!motor_cfg_.auto_apply_learned_factors || zone >= NUM_ZONES)
    return factor;

  xSemaphoreTake(telemetry_mutex_, portMAX_DELAY);
  const auto &t = telemetry_[zone];
  float learned_factor = is_opening ? t.learned_open_current_factor : t.learned_close_current_factor;
  uint8_t confidence = is_opening ? t.learned_open_confidence : t.learned_close_confidence;
  xSemaphoreGive(telemetry_mutex_);

  if (learned_factor > 0.0f && confidence >= motor_cfg_.learned_factor_min_samples)
    factor = learned_factor;
  return factor;
}

void Lv6ValveController::update_learned_factor_(uint8_t zone, MotorDirection dir, float average_ma,
                                                float peak_ma, bool sample_valid) {
  if (zone >= NUM_ZONES)
    return;

  xSemaphoreTake(telemetry_mutex_, portMAX_DELAY);
  auto &t = telemetry_[zone];
  t.last_learning_sample_valid = sample_valid;

  if (!sample_valid || average_ma <= 0.5f || peak_ma <= average_ma) {
    xSemaphoreGive(telemetry_mutex_);
    return;
  }

  float candidate = std::clamp(peak_ma / average_ma, 1.0f, 3.0f);
  float &learned_factor = (dir == MotorDirection::OPEN) ? t.learned_open_current_factor : t.learned_close_current_factor;
  uint8_t &confidence = (dir == MotorDirection::OPEN) ? t.learned_open_confidence : t.learned_close_confidence;
  float &last_candidate = (dir == MotorDirection::OPEN) ? t.last_open_candidate_factor : t.last_close_candidate_factor;
  float &last_peak = (dir == MotorDirection::OPEN) ? t.last_open_peak_ma : t.last_close_peak_ma;

  last_candidate = candidate;
  last_peak = peak_ma;

  if (candidate < 1.05f || candidate > 2.8f) {
    xSemaphoreGive(telemetry_mutex_);
    return;
  }

  if (learned_factor <= 0.0f) {
    learned_factor = candidate;
    confidence = 1;
  } else {
    float deviation = std::fabs(candidate - learned_factor) / learned_factor;
    if (deviation <= motor_cfg_.learned_factor_max_deviation_pct) {
      learned_factor = learned_factor * 0.7f + candidate * 0.3f;
      if (confidence < 255)
        confidence++;
    } else {
      learned_factor = candidate;
      confidence = 1;
    }
  }

  xSemaphoreGive(telemetry_mutex_);
}

bool Lv6ValveController::request_position(uint8_t zone, float target_pct) {
  if (zone >= NUM_ZONES)
    return false;
  if (!drivers_enabled_) {
    ESP_LOGW(TAG, "Drivers disabled, rejecting position request");
    return false;
  }
  if (calibrating_ || calibration_request_ >= 0) {
    ESP_LOGW(TAG, "Calibration active/pending, rejecting position request for zone %d", zone + 1);
    return false;
  }
  ValveCommand cmd = {zone, logical_to_actuator_pct_(target_pct)};
  return xQueueSend(cmd_queue_, &cmd, pdMS_TO_TICKS(100)) == pdTRUE;
}

bool Lv6ValveController::request_timed_open(uint8_t zone, uint16_t duration_ms, bool override_drivers) {
  if (zone >= NUM_ZONES)
    return false;
  if (!override_drivers && !drivers_enabled_) {
    ESP_LOGW(TAG, "Drivers disabled, rejecting timed open for zone %d", zone + 1);
    return false;
  }
  if (calibrating_ || calibration_request_ >= 0 || calibration_pending_mask_ != 0) {
    ESP_LOGW(TAG, "Calibration active/pending, rejecting timed open for zone %d", zone + 1);
    return false;
  }
  ValveCommand cmd = {zone, 0.0f, duration_ms, override_drivers, MotorDirection::OPEN};
  return xQueueSend(cmd_queue_, &cmd, pdMS_TO_TICKS(100)) == pdTRUE;
}

bool Lv6ValveController::request_back_off(uint8_t zone, uint16_t duration_ms) {
  if (zone >= NUM_ZONES)
    return false;
  if (calibrating_ || calibration_request_ >= 0 || calibration_pending_mask_ != 0) {
    ESP_LOGW(TAG, "Calibration active/pending, rejecting back-off for zone %d", zone + 1);
    return false;
  }
  xSemaphoreTake(telemetry_mutex_, portMAX_DELAY);
  const bool blocked = telemetry_[zone].blocked;
  xSemaphoreGive(telemetry_mutex_);
  // Away from the fault; a zone that is not blocked backs off the plunger (open).
  const MotorDirection dir = blocked && fault_dir_[zone] == MotorDirection::OPEN ? MotorDirection::CLOSE
                                                                                 : MotorDirection::OPEN;
  duration_ms = std::clamp<uint16_t>(duration_ms, 1000, 30000);
  back_off_allowed_[zone] = true;
  ESP_LOGI(TAG, "Motor %d back-off %s %" PRIu16 " ms requested", zone + 1,
           dir == MotorDirection::OPEN ? "OPEN" : "CLOSE", duration_ms);
  ValveCommand cmd = {zone, 0.0f, duration_ms, true, dir};
  if (xQueueSend(cmd_queue_, &cmd, pdMS_TO_TICKS(100)) == pdTRUE)
    return true;
  back_off_allowed_[zone] = false;
  return false;
}

bool Lv6ValveController::request_timed_close(uint8_t zone, uint16_t duration_ms, bool override_drivers) {
  if (zone >= NUM_ZONES)
    return false;
  if (!override_drivers && !drivers_enabled_) {
    ESP_LOGW(TAG, "Drivers disabled, rejecting timed close for zone %d", zone + 1);
    return false;
  }
  if (calibrating_ || calibration_request_ >= 0 || calibration_pending_mask_ != 0) {
    ESP_LOGW(TAG, "Calibration active/pending, rejecting timed close for zone %d", zone + 1);
    return false;
  }
  ValveCommand cmd = {zone, 0.0f, duration_ms, override_drivers, MotorDirection::CLOSE};
  return xQueueSend(cmd_queue_, &cmd, pdMS_TO_TICKS(100)) == pdTRUE;
}

bool Lv6ValveController::request_stop(uint8_t zone) {
  if (zone >= NUM_ZONES)
    return false;
  if (motor_turning_ && current_zone_ == zone)
    stop_motor_(true);
  return true;
}

void Lv6ValveController::log_i2c_scan() {
  if (!i2c_bus_) {
    ESP_LOGW(TAG, "I2C_SCAN: i2c_bus not configured");
    return;
  }

  char discovered[256];
  int off = 0;
  auto append_discovered = [&](const char *fmt, ...) {
    if (off < 0 || off >= static_cast<int>(sizeof(discovered)))
      return;
    va_list args;
    va_start(args, fmt);
    int n = std::vsnprintf(discovered + off, sizeof(discovered) - off, fmt, args);
    va_end(args);
    if (n > 0)
      off += n;
  };
  append_discovered("I2C_SCAN: ACK");
  bool found_any = false;

  for (uint8_t addr = 0x03; addr <= 0x77; addr++) {
    esphome::i2c::I2CDevice dev;
    dev.set_i2c_bus(i2c_bus_);
    dev.set_i2c_address(addr);
    auto err = dev.write(nullptr, 0);
    if (err == esphome::i2c::ERROR_OK) {
      found_any = true;
      append_discovered(" 0x%02X", addr);
      if (off >= static_cast<int>(sizeof(discovered)) - 6)
        break;
    }
  }

  if (!found_any)
    std::snprintf(discovered, sizeof(discovered), "I2C_SCAN: ACK none");

  ESP_LOGW(TAG, "I2C_SCAN: ----- begin -----");
  ESP_LOGW(TAG, "%s", discovered);

  char motor_line[256];
  off = 0;
  auto append_motor_line = [&](const char *fmt, ...) {
    if (off < 0 || off >= static_cast<int>(sizeof(motor_line)))
      return;
    va_list args;
    va_start(args, fmt);
    int n = std::vsnprintf(motor_line + off, sizeof(motor_line) - off, fmt, args);
    va_end(args);
    if (n > 0)
      off += n;
  };
  append_motor_line("I2C_SCAN: Motors");
  for (uint8_t i = 0; i < NUM_ZONES; i++) {
    esphome::i2c::I2CDevice dev;
    dev.set_i2c_bus(i2c_bus_);
    dev.set_i2c_address(motor_addresses_[i]);
    bool ack = (dev.write(nullptr, 0) == esphome::i2c::ERROR_OK);
    append_motor_line(" M%d:0x%02X=%s", i + 1, motor_addresses_[i], ack ? "OK" : "MISS");
    if (off >= static_cast<int>(sizeof(motor_line)) - 16)
      break;
  }
  ESP_LOGW(TAG, "%s", motor_line);
  ESP_LOGW(TAG, "I2C_SCAN: nFAULT GPIO%d=%d", nfault_pin_, gpio_get_level(nfault_pin_));
  ESP_LOGW(TAG, "I2C_SCAN: ----- end -----");
}

float Lv6ValveController::get_position(uint8_t zone) const {
  if (zone >= NUM_ZONES)
    return 0.0f;
  if (telemetry_mutex_ == nullptr)
    return 0.0f;
  xSemaphoreTake(telemetry_mutex_, portMAX_DELAY);
  float pos = telemetry_[zone].current_position_pct;
  xSemaphoreGive(telemetry_mutex_);
  return actuator_to_logical_pct_(pos);
}

void Lv6ValveController::set_manifold_type(ManifoldType type) {
  if (!config_store_)
    return;
  if (motor_turning_) {
    ESP_LOGW(TAG, "Ignoring manifold type change while motor is running");
    return;
  }

  auto cfg = config_store_->get_config();
  if (cfg.manifold_type == type)
    return;

  cfg.manifold_type = type;
  config_store_->set_config(cfg);
  ESP_LOGI(TAG, "Manifold type set to %s", type == ManifoldType::NC ? "NC" : "NO");
}

ManifoldType Lv6ValveController::get_manifold_type() const {
  if (!config_store_)
    return ManifoldType::NC;
  return config_store_->get_manifold_type();
}

MotorTelemetry Lv6ValveController::get_telemetry(uint8_t zone) const {
  if (zone >= NUM_ZONES)
    return {};
  if (telemetry_mutex_ == nullptr)
    return {};
  xSemaphoreTake(telemetry_mutex_, portMAX_DELAY);
  MotorTelemetry copy = telemetry_[zone];
  xSemaphoreGive(telemetry_mutex_);
  return copy;
}

void Lv6ValveController::request_calibration(uint8_t zone) {
  if (zone >= NUM_ZONES || !drivers_enabled_)
    return;

  // Guard against retained/replayed commands immediately after reboot.
  if (boot_time_ms_ > 0) {
    uint32_t uptime_ms = static_cast<uint32_t>(esp_timer_get_time() / 1000) - boot_time_ms_;
    if (uptime_ms < CALIBRATION_REQUEST_GUARD_MS) {
      ESP_LOGW(TAG, "Calibration request ignored during startup guard (%" PRIu32 "ms)", uptime_ms);
      return;
    }
  }

  calibration_request_ = static_cast<int8_t>(zone);
}

void Lv6ValveController::request_calibration_all() {
  if (!drivers_enabled_)
    return;

  // Guard against startup replay
  if (boot_time_ms_ > 0) {
    uint32_t uptime_ms = static_cast<uint32_t>(esp_timer_get_time() / 1000) - boot_time_ms_;
    if (uptime_ms < CALIBRATION_REQUEST_GUARD_MS) {
      ESP_LOGW(TAG, "Calibration all request ignored during startup guard (%" PRIu32 "ms)", uptime_ms);
      return;
    }
  }

  uint8_t mask = 0;
  for (uint8_t z = 0; z < NUM_ZONES; z++) {
    bool enabled = true;
    if (config_store_)
      enabled = config_store_->read([z](const DeviceConfig &cfg) { return cfg.zones[z].enabled; });
    if (enabled)
      mask |= (1u << z);
  }
  if (mask == 0) {
    ESP_LOGW(TAG, "request_calibration_all: no enabled zones");
    return;
  }
  calibration_pending_mask_ = mask;
  // Prime calibration_request_ with the first pending zone
  for (uint8_t z = 0; z < NUM_ZONES; z++) {
    if (calibration_pending_mask_ & (1u << z)) {
      calibration_pending_mask_ &= ~(1u << z);
      calibration_request_ = static_cast<int8_t>(z);
      break;
    }
  }
  ESP_LOGI(TAG, "request_calibration_all: queued zones mask=0x%02X", mask);
}

void Lv6ValveController::set_position_hint(uint8_t zone, PositionHint hint) {
  if (zone >= NUM_ZONES || hint == PositionHint::UNKNOWN)
    return;
  float pct = 50.0f;
  bool confident = false;
  if (hint == PositionHint::CLOSED) {
    pct = logical_to_actuator_pct_(0.0f);
    confident = true;
  } else if (hint == PositionHint::OPEN) {
    pct = logical_to_actuator_pct_(100.0f);
    confident = true;
  }
  xSemaphoreTake(telemetry_mutex_, portMAX_DELAY);
  telemetry_[zone].current_position_pct = pct;
  xSemaphoreGive(telemetry_mutex_);
  position_confident_[zone] = confident;
  breakaway_count_[zone] = 0;
  ESP_LOGI(TAG, "Zone %d position from the reset guide: %s (%.0f %%, %s)", zone + 1,
           hint == PositionHint::CLOSED ? "closed" : hint == PositionHint::OPEN ? "open" : "middle", pct,
           confident ? "trusted" : "hint only");
  persist_positions_();
}

bool Lv6ValveController::reset_fault(uint8_t zone) {
  if (zone >= NUM_ZONES)
    return false;
  if (motor_turning_ || calibrating_) {
    ESP_LOGW(TAG, "Reset fault denied for zone %d: controller busy", zone + 1);
    return false;
  }

  if (gpio_backend_enabled_) {
    if (!gpio_backend_ || !gpio_backend_->arm_latch()) {
      ESP_LOGE(TAG, "Zone %d fault reset rejected: hardware fault remains active",
               zone + 1);
      return false;
    }
  } else if (drivers_[zone] != nullptr) {
    drivers_[zone]->clear_fault();
  }

  xSemaphoreTake(telemetry_mutex_, portMAX_DELAY);
  auto &t = telemetry_[zone];
  t.blocked = false;
  t.calibration_retries = 0;
  t.last_fault_code = FaultCode::NONE;
  t.last_learning_sample_valid = false;
  xSemaphoreGive(telemetry_mutex_);

  current_fault_code_ = FaultCode::NONE;
  calibration_failed_mask_.fetch_and(static_cast<uint8_t>(~(1u << zone)), std::memory_order_acq_rel);
  save_telemetry_(zone);
  ESP_LOGI(TAG, "Zone %d fault state reset", zone + 1);
  return true;
}

bool Lv6ValveController::reset_and_relearn(uint8_t zone) {
  if (zone < NUM_ZONES)
    position_confident_[zone] = false;
  if (!drivers_enabled_) {
    ESP_LOGW(TAG, "Reset+relearn denied for zone %d: drivers disabled", zone + 1);
    return false;
  }
  if (!reset_fault(zone))
    return false;
  request_calibration(zone);
  ESP_LOGI(TAG, "Zone %d reset and relearn requested", zone + 1);
  return true;
}

bool Lv6ValveController::reset_learned_factors(uint8_t zone) {
  if (zone >= NUM_ZONES)
    return false;
  xSemaphoreTake(telemetry_mutex_, portMAX_DELAY);
  auto &t = telemetry_[zone];
  t.learned_open_current_factor = 0.0f;
  t.learned_close_current_factor = 0.0f;
  t.learned_open_confidence = 0;
  t.learned_close_confidence = 0;
  t.last_open_candidate_factor = 0.0f;
  t.last_close_candidate_factor = 0.0f;
  // last_*_peak_ma is deliberately NOT cleared. It is no longer just an input to
  // the (now disabled) factor learning - it is the endpoint current that
  // learned_stall_ma_() feeds to the open trip. Motor Lab calls this before
  // every stroke, so clearing it here made every lab open capture fall back to
  // the legacy ratio path, i.e. measure a code path production no longer uses.
  // A full reset_and_relearn() still clears it.
  t.last_learning_sample_valid = false;
  xSemaphoreGive(telemetry_mutex_);
  save_telemetry_(zone);
  ESP_LOGI(TAG, "Zone %d learned factors reset", zone + 1);
  return true;
}

bool Lv6ValveController::manifold_is_nc_() const {
  return get_manifold_type() == ManifoldType::NC;
}

float Lv6ValveController::logical_to_actuator_pct_(float logical_pct) const {
  logical_pct = std::clamp(logical_pct, 0.0f, 100.0f);
  return manifold_is_nc_() ? 100.0f - logical_pct : logical_pct;
}

float Lv6ValveController::actuator_to_logical_pct_(float actuator_pct) const {
  actuator_pct = std::clamp(actuator_pct, 0.0f, 100.0f);
  return manifold_is_nc_() ? 100.0f - actuator_pct : actuator_pct;
}

bool Lv6ValveController::uses_working_range_(uint8_t zone) const {
  if (zone >= NUM_ZONES)
    return false;
  xSemaphoreTake(telemetry_mutex_, portMAX_DELAY);
  const bool wr = telemetry_[zone].stroke_model == StrokeModel::WORKING_RANGE &&
                  telemetry_[zone].learned_open_ripples > 0;
  xSemaphoreGive(telemetry_mutex_);
  return wr;
}

float Lv6ValveController::flow_to_physical_pct_(uint8_t zone, float flow_pct) {
  // A working-range zone already spans pin release to seat: there is no dead
  // zone left inside 0-100 % to remap around.
  if (uses_working_range_(zone))
    return flow_pct;

  flow_pct = std::clamp(flow_pct, 0.0f, 100.0f);

  // 0% flow always maps to 0% physical (closed endstop)
  if (flow_pct <= 0.01f)
    return 0.0f;

  // Need pin engagement data from calibration
  xSemaphoreTake(telemetry_mutex_, portMAX_DELAY);
  uint32_t pin_ripples = telemetry_[zone].pin_engage_close_ripples;
  uint32_t close_ripples = telemetry_[zone].learned_close_ripples;
  xSemaphoreGive(telemetry_mutex_);

  if (pin_ripples == 0 || close_ripples == 0)
    return flow_pct;

  // Effective engagement point with margin offset toward open.
  // Subtracting margin means 100% flow maps to a position where the pin is
  // fully disengaged from the valve body, ensuring unobstructed flow.
  uint32_t margin = motor_cfg_.pin_engage_margin_ripples;
  uint32_t effective = (pin_ripples > margin) ? (pin_ripples - margin) : 0;

  // Max flow position in physical %.
  // pin_engage is 'effective' ripples from the open end during closing.
  // The physical position beyond this point is dead zone (no flow change).
  float max_flow_pct = (1.0f - static_cast<float>(effective) /
                        static_cast<float>(close_ripples)) * 100.0f;
  max_flow_pct = std::clamp(max_flow_pct, 10.0f, 100.0f);

  // Remap: flow 0–100% → physical 0% to max_flow_pct
  return std::clamp(flow_pct * max_flow_pct / 100.0f, 0.0f, 100.0f);
}

// =============================================================================
// FreeRTOS Task (10ms tick, Core 1)
// =============================================================================

void Lv6ValveController::task_func_(void *arg) {
  static_cast<Lv6ValveController *>(arg)->run_();
}

void Lv6ValveController::run_() {
  TickType_t last_wake = xTaskGetTickCount();

  while (true) {
    // Auto-start: enable drivers and calibrate all detected zones once after boot delay
    if (!auto_start_done_ && boot_time_ms_ > 0) {
      uint32_t uptime_ms = static_cast<uint32_t>(esp_timer_get_time() / 1000) - boot_time_ms_;
      if (uptime_ms >= AUTO_START_DELAY_MS) {
        auto_start_done_ = true;
        ESP_LOGI(TAG, "Auto-start: enabling motor drivers and calibrating enabled zones");
        set_drivers_enabled(true);
        for (uint8_t z = 0; z < NUM_ZONES; z++) {
          if (!telemetry_[z].present) {
            ESP_LOGW(TAG, "Auto-start: zone %d has no detected driver, skipping calibration", z + 1);
            continue;
          }
          bool enabled = true;
          if (config_store_)
            enabled = config_store_->read([z](const DeviceConfig &cfg) { return cfg.zones[z].enabled; });
          if (enabled)
          run_calibration_(z);
          else
            ESP_LOGI(TAG, "Auto-start: zone %d disabled, skipping calibration", z + 1);
        }
        last_wake = xTaskGetTickCount();  // Resync tick after long calibration run
      }
    }

    if (!drivers_enabled_)
      maybe_recover_drivers_();
    else if (drivers_recover_count_ > 0 &&
             static_cast<uint32_t>(esp_timer_get_time() / 1000) - drivers_on_ms_ >= DRIVER_STABLE_MS)
      drivers_recover_count_ = 0;   // stayed on for an hour: the backoff starts over

    if (!drivers_enabled_) {
      // Timed lab/manual moves set override_drivers so they can run while the
      // software switch is off. Leaving the queue untouched here swallowed
      // those commands: the HTTP call succeeded, Motor Lab waited for motion,
      // and the bridge never started.
      //
      // Once an override move is running, this branch must still service
      // motor_loop_() — otherwise the nested spin in execute_timed_move_ was
      // the only thing advancing the FSM, and a non-blocking start would leave
      // the bridge energised with no endstop/ceiling checks.
      process_command_queue_();
      if (motor_turning_) {
        motor_loop_();
        vTaskDelayUntil(&last_wake, pdMS_TO_TICKS(FAST_TICK_MS));
      } else {
        vTaskDelayUntil(&last_wake, pdMS_TO_TICKS(TICK_MS));
      }
      continue;
    }

    if (motor_turning_) {
      // Fast 1ms loop: ADC + ripple each tick, FSM every 10th tick
      motor_loop_();
      vTaskDelayUntil(&last_wake, pdMS_TO_TICKS(FAST_TICK_MS));
    } else {
      fsm_tick_count_ = 0;

      if (calibration_request_ >= 0) {
        uint8_t zone = static_cast<uint8_t>(calibration_request_);
        calibration_request_ = -1;
        run_calibration_(zone);
        persist_positions_();
        // Advance to next pending zone in the queue
        if (calibration_pending_mask_ != 0) {
          for (uint8_t z = 0; z < NUM_ZONES; z++) {
            if (calibration_pending_mask_ & (1u << z)) {
              calibration_pending_mask_ &= ~(1u << z);
              calibration_request_ = static_cast<int8_t>(z);
              break;
            }
          }
        }
      }

      process_command_queue_();
      check_relearn_triggers_();
      vTaskDelayUntil(&last_wake, pdMS_TO_TICKS(TICK_MS));
    }
  }
}

void Lv6ValveController::process_command_queue_() {
  ValveCommand cmd;
  if (xQueueReceive(cmd_queue_, &cmd, 0) == pdTRUE) {
    if (cmd.timed_duration_ms > 0) {
      execute_timed_move_(cmd.zone, cmd.timed_duration_ms, cmd.timed_direction, cmd.override_drivers);
    } else {
      execute_move_(cmd.zone, cmd.target_pct);
    }
    if (!motor_turning_)
      persist_positions_();
  }
}

void Lv6ValveController::persist_positions_() {
  if (config_store_ == nullptr)
    return;
  float pos[NUM_ZONES];
  xSemaphoreTake(telemetry_mutex_, portMAX_DELAY);
  for (uint8_t i = 0; i < NUM_ZONES; i++)
    pos[i] = telemetry_[i].current_position_pct;
  xSemaphoreGive(telemetry_mutex_);
  bool changed = false;
  for (uint8_t i = 0; i < NUM_ZONES; i++) {
    if (!std::isfinite(persisted_pos_[i]) || std::fabs(pos[i] - persisted_pos_[i]) >= 0.5f)
      changed = true;
  }
  if (!changed)
    return;
  config_store_->save_motor_positions(pos, NUM_ZONES);
  for (uint8_t i = 0; i < NUM_ZONES; i++)
    persisted_pos_[i] = pos[i];
}

void Lv6ValveController::execute_timed_move_(uint8_t zone, uint16_t duration_ms, MotorDirection dir, bool override_drivers) {
  if (zone >= NUM_ZONES)
    return;
  if (!override_drivers) {
    if (!telemetry_[zone].present || !drivers_enabled_)
      return;
  }
  // `blocked` is honoured regardless of override: the dashboard passes
  // override_drivers on every jog, so a zone blocked by MECHANICAL_OVERRUN was
  // still joggable - straight back into whatever blocked it.
  // The one exception is the reset guide's back-off: away from the fault only.
  const bool back_off = back_off_allowed_[zone];
  back_off_allowed_[zone] = false;
  if (telemetry_[zone].blocked) {
    if (!back_off || dir == fault_dir_[zone]) {
      ESP_LOGW(TAG, "Zone %d blocked, refusing timed move", zone + 1);
      return;
    }
    ESP_LOGW(TAG, "Zone %d blocked: backing off %s for %" PRIu16 " ms", zone + 1,
             dir == MotorDirection::OPEN ? "OPEN" : "CLOSE", duration_ms);
  }

  // Timed lab/jog requests must never exceed the profile mechanical ceiling.
  // Motor Lab previously added +15 s headroom past HmIP's 40 s limit and destroyed
  // a plunger when endstop detection missed the seat.
  const uint32_t profile_limit_ms = effective_runtime_limit_s_(zone) * 1000u;
  if (duration_ms == 0 || static_cast<uint32_t>(duration_ms) > profile_limit_ms)
    duration_ms = static_cast<uint16_t>(std::min<uint32_t>(profile_limit_ms, 65535u));

  if (!start_motor_(zone, dir, override_drivers))
    return;

  // Motor Lab / manual timed jogs: treat the duration as a safety ceiling and
  // still run endstop detection so a real open/close bite can stop early.
  // Without this, timed opens just burn the full window in free travel and never
  // record an open endstop (see Motor Lab open traces that stay flat ~24 mA).
  drive_to_endstop_active_ = true;
  // Use the learned stroke if this zone has one. Zeroing it here made
  // endpoint_window_reached_() unconditionally true, so a lab jog could write a
  // learned position off any cadence hiccup - there is no reason a jog should
  // discard calibration data.
  approach_stroke_ripples_ = 0;
  if (ripple_enabled_) {
    xSemaphoreTake(telemetry_mutex_, portMAX_DELAY);
    const uint32_t full = (dir == MotorDirection::OPEN)
                              ? telemetry_[zone].learned_open_ripples
                              : telemetry_[zone].learned_close_ripples;
    xSemaphoreGive(telemetry_mutex_);
    approach_stroke_ripples_ = full;
  }
  approach_stroke_ms_ = duration_ms;
  timed_mode_active_ = true;
  timed_move_start_ms_ = static_cast<uint32_t>(esp_timer_get_time() / 1000);
  timed_move_duration_ms_ = duration_ms;
  refresh_move_limit_(duration_ms);

  ESP_LOGI(TAG, "Motor %d timed %s %" PRIu16 "ms (override=%d, endstop armed, profile_cap=%" PRIu32 "ms)",
           zone + 1, dir == MotorDirection::OPEN ? "OPEN" : "CLOSE",
           duration_ms, override_drivers, profile_limit_ms);

  // Non-blocking: run_() / the drivers-disabled override branch advance
  // motor_loop_() while motor_turning_. A nested spin here starved WiFi/logging
  // for the full jog (looked like a crash) and made stop_motor queueing racey.
}

void Lv6ValveController::execute_move_(uint8_t zone, float target_pct) {
  if (zone >= NUM_ZONES || !telemetry_[zone].present || !drivers_enabled_)
    return;
  if (telemetry_[zone].blocked) {
    ESP_LOGW(TAG, "Zone %d blocked, skipping move", zone + 1);
    return;
  }

  float current_pct = telemetry_[zone].current_position_pct;

  // Remap flow % → physical % based on pin engagement data
  float physical_target = flow_to_physical_pct_(zone, target_pct);
  if (std::fabs(physical_target - target_pct) > 0.1f) {
    ESP_LOGD(TAG, "Motor %d flow %.1f%% → physical %.1f%%",
             zone + 1, target_pct, physical_target);
  }
  target_pct = physical_target;

  float diff = target_pct - current_pct;
  float min_move = 5.0f;
  if (config_store_)
    min_move = config_store_->read([](const DeviceConfig &cfg) { return cfg.control.min_movement_pct; });

  if (skip_small_move(diff, min_move, target_pct, rehoming_, position_confident_[zone]))
    return;

  // --- Anti-drift re-home ----------------------------------------------------
  // Position is derived, never accumulated: an intermediate target first drives
  // to the close endstop and then opens by a ripple count, so error cannot
  // compound over successive relative moves.
  //
  // This is deliberately per-zone and serialised (the controller runs one motor
  // at a time), which is what separates it from the failure eQ-3 and the VdMot
  // fork both hit: THEIR problem was a global adaptation closing every valve at
  // once on systems with no minimum-flow protection. rehome_inhibited_ is the
  // zone controller's veto for the case where closing this one would still
  // breach minimum flow.
  // A working-range zone opens to 100 % by count from the seat, so a full-open
  // target needs the same datum as any other open leg.
  const bool working_range = uses_working_range_(zone);
  const bool intermediate = target_pct > 0.01f && (target_pct < 99.99f || working_range);
  if (intermediate && !rehoming_ && rehome_required_(zone)) {
    ESP_LOGI(TAG, "Motor %d re-homing before %.1f%% (pos was %.1f%%)", zone + 1,
             target_pct, current_pct);
    rehoming_ = true;
    execute_move_(zone, 0.0f);
    rehoming_ = false;

    // The open leg must never start from an unknown datum.
    if (current_fault_code_ != FaultCode::NONE || !position_confident_[zone]) {
      ESP_LOGW(TAG, "Motor %d re-home did not confirm the close endstop; "
                    "refusing to open from an unknown position", zone + 1);
      return;
    }
    vTaskDelay(pdMS_TO_TICKS(REVERSAL_PAUSE_MS));   // let the seat relax before reversing
    moves_since_rehome_[zone] = 0;
    last_rehome_ms_[zone] = static_cast<uint32_t>(esp_timer_get_time() / 1000);

    xSemaphoreTake(telemetry_mutex_, portMAX_DELAY);
    current_pct = telemetry_[zone].current_position_pct;
    xSemaphoreGive(telemetry_mutex_);
    diff = target_pct - current_pct;
    if (std::fabs(diff) < min_move)
      return;  // already there
  }
  if (!rehoming_ && zone < NUM_ZONES)
    moves_since_rehome_[zone]++;

  MotorDirection dir = (diff > 0) ? MotorDirection::OPEN : MotorDirection::CLOSE;
  float diff_pct = std::fabs(diff);

  // Drive-to-endstop mode: for full open (100%) or full close (0%) targets,
  // run the motor until endstop detection fires instead of using time/ripple
  // estimates. This guarantees the valve is physically at the mechanical limit.
  //
  // Working range: only the seat is an endstop target. 100 % is pin release +
  // margin by count, so the open endstop - the gear-train stop - is never driven
  // into; its detection paths stay armed as a backstop.
  bool drive_to_endstop = target_pct <= 0.01f || (!working_range && target_pct >= 99.99f);

  // Compute ripple target (if calibrated and not driving to endstop)
  uint32_t target_ripples = 0;
  uint32_t learned_ripples = 0;
  if (!drive_to_endstop) {
    xSemaphoreTake(telemetry_mutex_, portMAX_DELAY);
    learned_ripples = (dir == MotorDirection::OPEN)
        ? telemetry_[zone].learned_open_ripples
        : telemetry_[zone].learned_close_ripples;
    xSemaphoreGive(telemetry_mutex_);

    if (ripple_enabled_ && learned_ripples > 0)
      target_ripples = static_cast<uint32_t>((diff_pct / 100.0f) * learned_ripples);
  }

  // Time estimate (always computed — used as primary, timeout, or safety cap for endstop mode)
  float travel_time_ms = estimate_travel_time_ms_(zone, current_pct, target_pct);
  if (travel_time_ms < 100.0f && !drive_to_endstop)
    return;

  uint32_t timeout_ms;
  if (drive_to_endstop) {
    // Drive-to-endstop always uses the full per-profile runtime limit as the
    // safety timeout. The motor could be anywhere (position tracking may have
    // drifted, or the valve was manually moved) so we must allow a full stroke.
    // Endstop detection will fire well before this in the normal case.
    // Uses effective_runtime_limit_s_() (per-profile: 40s HmIP, 45s Generic)
    // rather than the legacy max_runtime_s which does not respect the profile.
    timeout_ms = effective_runtime_limit_s_(zone) * 1000;
  } else if (target_ripples > 0) {
    timeout_ms = static_cast<uint32_t>(travel_time_ms * 1.5f);
  } else {
    timeout_ms = static_cast<uint32_t>(travel_time_ms);
  }

  // Ordinary operation must not be the thing that discovers the stroke length:
  // an uncalibrated drive-to-endstop move would run on the bootstrap ceiling
  // with no learned reference at all. Queue calibration instead.
  if (compute_move_ceiling(build_ceiling_inputs_(zone, dir, drive_to_endstop,
                                                 calibrating_, 0))
          .requires_calibration) {
    ESP_LOGW(TAG, "Motor %d drive-to-endstop refused: zone not calibrated", zone + 1);
    calibration_request_ = zone;
    return;
  }

  if (!start_motor_(zone, dir))
    return;

  // --- Soft-approach + adaptive endstop guard context for this move ---
  // approach_stroke_* are the estimated travel for THIS move (remaining distance
  // to the target), so soft-approach engages in the final stretch regardless of
  // where the move started.
  drive_to_endstop_active_ = drive_to_endstop;
  approach_stroke_ms_ = (travel_time_ms > 0.0f) ? static_cast<uint32_t>(travel_time_ms) : 0;
  approach_stroke_ripples_ = 0;
  if (ripple_enabled_) {
    if (!drive_to_endstop) {
      approach_stroke_ripples_ = target_ripples;
    } else {
      float remaining = (dir == MotorDirection::OPEN) ? (100.0f - current_pct) : current_pct;
      remaining = std::clamp(remaining, 0.0f, 100.0f) / 100.0f;
      xSemaphoreTake(telemetry_mutex_, portMAX_DELAY);
      uint32_t full = (dir == MotorDirection::OPEN)
          ? telemetry_[zone].learned_open_ripples
          : telemetry_[zone].learned_close_ripples;
      xSemaphoreGive(telemetry_mutex_);
      if (full > 0)
        approach_stroke_ripples_ = static_cast<uint32_t>(remaining * static_cast<float>(full));
    }
  }

  // Adaptive inrush blind window: base = boost + settle; shrink toward a floor
  // just past boost when little travel remains (valve already near the stop) so a
  // near-endstop move is not blind. The fast raw hard-cap (gated only on the boost
  // phase) still protects the boost→guard region.
  if (!calibrating_) {
    uint32_t base_guard = motor_cfg_.pwm_boost_ms + ENDSTOP_SETTLE_MS;
    uint32_t guard = base_guard;
    if (drive_to_endstop && approach_stroke_ms_ > 0 && approach_stroke_ms_ < base_guard) {
      uint32_t floor_guard = motor_cfg_.pwm_boost_ms + 100;
      guard = std::max(floor_guard, approach_stroke_ms_ / 2);
    }
    endstop_guard_ms_ = guard;
  }

  // The flags above change the ceiling (drive-to-endstop uses the full stroke,
  // a partial move only the remaining travel), so recompute it now.
  refresh_move_limit_(0);
  timeout_ms = std::min(timeout_ms, move_limit_.limit_ms);

  // Ripple safety limit for opening: stop if we exceed learned open stroke × factor
  uint32_t open_ripple_limit = 0;
  if (drive_to_endstop && dir == MotorDirection::OPEN
      && motor_cfg_.open_ripple_limit_factor > 0.0f) {
    xSemaphoreTake(telemetry_mutex_, portMAX_DELAY);
    uint32_t open_ripples = telemetry_[zone].learned_open_ripples;
    xSemaphoreGive(telemetry_mutex_);
    if (ripple_enabled_ && open_ripples > 0) {
      open_ripple_limit = static_cast<uint32_t>(
          open_ripples * motor_cfg_.open_ripple_limit_factor);
    }
  }

  if (drive_to_endstop) {
    ESP_LOGI(TAG, "Motor %d drive-to-endstop %s (travel_est=%.0fms safety timeout %" PRIu32 "ms, ripple_lim=%" PRIu32 ")",
             zone + 1, dir == MotorDirection::OPEN ? "OPEN" : "CLOSE",
             travel_time_ms, timeout_ms, open_ripple_limit);
  }

  while (motor_turning_) {
    motor_loop_();
    vTaskDelay(pdMS_TO_TICKS(FAST_TICK_MS));

    if (drive_to_endstop) {
      // In drive-to-endstop mode, the motor runs until endstop detection
      // in process_tick_() calls stop_motor_(), or safety timeout fires.
      if (motor_run_time_ms_ >= timeout_ms)
        break;
      // Ripple safety: stop if we've exceeded the learned stroke length × factor
      uint32_t cur_rip = live_ripple_count_.load(std::memory_order_relaxed);
      if (open_ripple_limit > 0 && cur_rip >= open_ripple_limit) {
        ESP_LOGI(TAG, "Motor %d open ripple limit (%" PRIu32 "/%" PRIu32 ")",
                 zone + 1, cur_rip, open_ripple_limit);
        break;
      }
    } else {
      // Ripple-based stop (precise)
      if (target_ripples > 0 &&
          live_ripple_count_.load(std::memory_order_relaxed) >= target_ripples)
        break;
      // Time-based stop (fallback when no ripple data)
      if (target_ripples == 0 && motor_run_time_ms_ >= timeout_ms)
        break;
      // Safety timeout (always)
      if (target_ripples > 0 && motor_run_time_ms_ >= timeout_ms)
        break;
    }
  }

  if (motor_turning_) {
    if (drive_to_endstop && !endpoint_confirmed_)
      trigger_fault_(FaultCode::MECHANICAL_OVERRUN,
                     "drive-to-endstop window expired without qualified endpoint");
    else
      stop_motor_(true);
  }

  // A close to the seat that ends BLOCKED is an already-seated valve or a jam:
  // two-wire signals cannot tell them apart. Learning backs off open and closes
  // again (home_to_seat_); ordinary moves did not, so a valve already on its
  // seat at the first re-home after a restart stayed BLOCKED until someone
  // reset it. Back off once and repeat the close: a free valve now travels to
  // its seat and confirms it, a real jam blocks again.
  if (drive_to_endstop && dir == MotorDirection::CLOSE && !calibrating_ && !seat_retrying_ &&
      current_fault_code_ == FaultCode::BLOCKED) {
    ESP_LOGW(TAG, "Motor %d close to the seat blocked after %" PRIu32 " ms; backing off %" PRIu32
                  " ms and closing again", zone + 1, motor_run_time_ms_, LEARN_CLOSE_BACKOFF_OPEN_MS);
    seat_retrying_ = true;
    calibration_backoff_open_(zone, LEARN_CLOSE_BACKOFF_OPEN_MS);
    // The seat check needs to know how far the back-off went, or the close
    // would be judged against the stale position and read as a jam.
    xSemaphoreTake(telemetry_mutex_, portMAX_DELAY);
    const uint32_t stroke = telemetry_[zone].learned_open_ripples;
    telemetry_[zone].current_position_pct =
        stroke > 0 ? std::clamp(100.0f * static_cast<float>(get_motion_count_()) / static_cast<float>(stroke),
                                0.0f, 100.0f)
                   : 0.0f;
    xSemaphoreGive(telemetry_mutex_);
    execute_move_(zone, 0.0f);
    seat_retrying_ = false;
    return;
  }

  // Update position
  bool clear_stale_fault = false;
  xSemaphoreTake(telemetry_mutex_, portMAX_DELAY);
  if (current_fault_code_ == FaultCode::NONE && !move_aborted_) {
    if (drive_to_endstop) {
      if (endpoint_confirmed_) {
        // Endstop reached — position is definitively at the limit.
        telemetry_[zone].current_position_pct = target_pct;
      }
      // Otherwise retain the previous position: a timeout or unclassified
      // stop must never be promoted to a confirmed mechanical limit.
    } else if (target_ripples > 0 && learned_ripples > 0 &&
               get_motion_count_() > 0) {
      // Precise position from actual ripple count (safe: DMA stopped in stop_motor_)
      float actual_pct = (static_cast<float>(get_motion_count_()) /
                          static_cast<float>(learned_ripples)) * 100.0f;
      float new_pos = (dir == MotorDirection::OPEN)
          ? current_pct + actual_pct
          : current_pct - actual_pct;
      telemetry_[zone].current_position_pct = std::clamp(new_pos, 0.0f, 100.0f);
    } else {
      telemetry_[zone].current_position_pct = target_pct;
    }
    // A clean move proves the motor works again: clear a fault restored from
    // NVS (or left by an earlier retry), so the UI does not keep showing it.
    if (!telemetry_[zone].blocked && (!drive_to_endstop || endpoint_confirmed_) &&
        telemetry_[zone].last_fault_code != FaultCode::NONE) {
      telemetry_[zone].last_fault_code = FaultCode::NONE;
      clear_stale_fault = true;
    }
  }
  xSemaphoreGive(telemetry_mutex_);
  if (clear_stale_fault)
    save_telemetry_(zone);
}

float Lv6ValveController::estimate_travel_time_ms_(uint8_t zone, float from_pct, float to_pct) {
  xSemaphoreTake(telemetry_mutex_, portMAX_DELAY);
  uint32_t learned_open = telemetry_[zone].learned_open_ms;
  uint32_t learned_close = telemetry_[zone].learned_close_ms;
  xSemaphoreGive(telemetry_mutex_);

  float diff_pct = std::fabs(to_pct - from_pct);

  if (to_pct > from_pct && learned_open > 0) {
    return (diff_pct / 100.0f) * static_cast<float>(learned_open);
  } else if (to_pct < from_pct && learned_close > 0) {
    return (diff_pct / 100.0f) * static_cast<float>(learned_close);
  }
  return (diff_pct / 100.0f) * 60000.0f;
}

// =============================================================================
// Motor Control
// =============================================================================

bool Lv6ValveController::start_motor_(uint8_t zone, MotorDirection dir, bool override_drivers) {
  if (zone >= NUM_ZONES || motor_turning_ || (!drivers_enabled_ && !override_drivers))
    return false;
  // Reversing a motor that has just stopped trips the bridge (a learn's first close
  // 12 ms after a move's open: raw fault, "breakaway"). Every path waits out the pause.
  if (zone == last_stop_zone_ && dir != last_stop_dir_ && last_stop_ms_ != 0) {
    const uint32_t since = static_cast<uint32_t>(esp_timer_get_time() / 1000) - last_stop_ms_;
    if (since < REVERSAL_PAUSE_MS)
      vTaskDelay(pdMS_TO_TICKS(REVERSAL_PAUSE_MS - since));
  }
  move_aborted_ = false;
  seat_early_logged_ = false;
  seat_short_logged_ = false;

  DRV8215 *driver = nullptr;
  if (!gpio_backend_enabled_) {
    driver = drivers_[zone];
    if (!driver)
      return false;
  } else if (!gpio_backend_) {
    return false;
  }

  // If drivers are physically asleep and we're overriding, temporarily wake nSLEEP
  nsleep_overridden_ = false;
  if (!gpio_backend_enabled_ && override_drivers && !drivers_enabled_ && !DEVELOPMENT_KEEP_NSLEEP_AWAKE) {
    set_nsleep_(true);
    vTaskDelay(pdMS_TO_TICKS(5));  // DRV8215 wakeup time
    nsleep_overridden_ = true;
  }

  if (driver)
    driver->clear_fault();

  current_zone_ = zone;
  current_dir_ = dir;
  motor_run_time_ms_ = 0;
  drive_phase_elapsed_ms_ = 0;
  drive_output_enabled_ = false;
  current_filtered_ma_ = 0.0f;
  current_raw_ma_ = 0.0f;
  current_peak_ma_ = 0.0f;
  current_sum_ = 0.0f;
  current_count_ = 0;
  debounce_count_ = 0;
  endstop_high_count_ = 0;
  hard_cap_high_count_ = 0;
  open_fast_cap_armed_ = false;
  open_fast_cap_count_ = 0;
  close_fast_cap_count_ = 0;
  low_current_count_ = 0;
  oc_last_ripple_count_ = 0;
  stall_last_ripple_count_ = 0;
  stall_last_advance_ms_ = 0;
  stall_initialized_ = false;
  cal_baseline_ma_ = 0.0f;
  cal_baseline_set_ = false;
  {
    TrailingStepConfig tc{};
    tc.window_ms = motor_cfg_.close_trailing_ref_ms;
    tc.step_ma = motor_cfg_.close_trailing_step_ma;
    tc.sustain_ms = motor_cfg_.close_trailing_sustain_ms;
    close_step_.set_config(tc);
    close_step_.reset();
  }
  move_baseline_ma_ = 0.0f;
  move_baseline_set_ = false;
  baseline_valid_ = false;
  baseline_last_drop_ms_ = 0;
  current_filter_primed_ = false;
  vdmot_working_cap_count_ = 0;
  // Conservative defaults — execute_move_() overrides these for normal moves.
  // Calibration passes call start_motor_() directly and keep this blind window:
  // just past boost + settle (not the old ~1.2 s) so the high-current close endstop
  // is detected quickly even when the valve starts already closed (pop-off safety).
  drive_to_endstop_active_ = false;
  endpoint_confirmed_ = false;
  soft_approach_active_ = false;
  endstop_guard_ms_ = motor_cfg_.pwm_boost_ms + ENDSTOP_SETTLE_MS;
  approach_stroke_ripples_ = 0;
  approach_stroke_ms_ = 0;
  slope_prev_current_ma_ = 0.0f;
  slope_tick_count_ = 0;
  current_slope_ma_per_s_ = 0.0f;
  slope_initialized_ = false;
  slope_endstop_windows_ = 0;
  pin_detect_baseline_set_ = false;
  pin_detected_ = false;
  pin_detected_ripples_ = 0;
  pin_detect_sustained_ = 0;
  {
    PinOnsetConfig pc{};
    pc.step_ma = motor_cfg_.pin_engage_step_ma;
    pin_onset_.set_config(pc);
    pin_onset_.reset();
  }
  pin_anchor_ma_ = 0.0f;
  seat_rise_.reset();
  seal_count_ = 0;
  xSemaphoreTake(telemetry_mutex_, portMAX_DELAY);
  close_seating_learned_ = telemetry_[zone].contact_to_stop_close_ripples > 0;
  xSemaphoreGive(telemetry_mutex_);
  current_fault_code_ = FaultCode::NONE;
  fsm_state_ = MotorFsmState::BOOST;

  // Wall-clock origin for every safety window in this move.
  move_start_ms_ = static_cast<uint32_t>(esp_timer_get_time() / 1000);
  // Conservative bootstrap ceiling. Callers that know they are driving to an
  // endstop, or running a timed jog, refine it via refresh_move_limit_() once
  // their flags are set - but a caller that forgets is still bounded.
  refresh_move_limit_(0);

  spurious_.set_config(stall_model_cfg_());
  spurious_.reset();
  cap_counters_ = CapCounters{};
  cap_ladder_cached_ = sanitize_cap_ladder(cap_ladder_(), RAIL_COMPARATOR_TRIP_MA);
  last_fast_trip_ = 0;
  last_endpoint_decision_ = 0;
  drive_inhibited_ = false;
  free_cadence_hz_ = 0.0f;
  last_cadence_count_ = 0;
  last_cadence_ms_ = 0;

  // Clear the fast-trip channel BEFORE the ripple task is allowed to consider
  // this a live move. The other order lets a trip raised by the previous move's
  // final frame be consumed by this move's first motor_loop_().
  fast_trip_.store(0, std::memory_order_relaxed);
  cap_ctx_.store(0, std::memory_order_relaxed);
  hard_cap_tripped_.store(false, std::memory_order_relaxed);
  std::atomic_thread_fence(std::memory_order_release);

  motor_turning_ = true;

  // Reset ripple counter and start ADC DMA
  ripple_counter_.reset();
  live_ripple_count_ = 0;
  dma_debounce_remaining_ = dma_debounce_samples_;
  ripple_drive_was_on_ = false;
  if (tacho_adc_counter_ != nullptr) {
    tacho_adc_counter_->reset();
    tacho_adc_count_ = 0;
    tacho_adc_raw_ = 0xFFFF;
  }
  // The stroke phase model restarts with the move: which direction it is, and
  // therefore whether a pin-contact phase is expected at all, changes with it.
  {
    StrokeConfig sc{};
    sc.contact_step_ma = motor_cfg_.pin_engage_step_ma;
    sc.contact_recovery_ripples = motor_cfg_.contact_recovery_ripples;
    sc.slowdown_x10 = motor_cfg_.slowdown_plateau_factor_x10;
    sc.stopping_x10 = motor_cfg_.stall_plateau_factor_x10;
    stroke_.set_config(sc);
  }
  stroke_.reset(dir == MotorDirection::OPEN);
  fsm_tick_count_ = 0;
  trace_reset_();
  last_bemf_sample_ms_ = 0;
  rev31_invalid_bemf_samples_ = 0;
  rev31_diag_raw_a_ = 0;
  rev31_diag_raw_b_ = 0;
  rev31_diag_differential_ = 0;
  rev31_diag_separation_us_ = 0;
  rev31_diag_sample_valid_ = 0;
  rev31_diag_sample_moving_ = 0;
  rev31_diag_invalid_samples_ = 0;
  motor_diag_evidence_count_ = 0;
  motor_diag_sample_sequence_ = 0;
  motor_diag_runtime_ms_ = 0;
  motor_diag_current_ma_x10_ = 0;
  if (gpio_backend_)
    gpio_backend_->reset_motion();

  if (ripple_enabled_ && adc_continuous_handle_) {
    // The return was discarded here. ESP_ERR_INVALID_STATE from a stream that
    // is already running, or any other failure, then looks exactly like working
    // hardware that reports zero current — which is what early bring-up hit.
    const esp_err_t start_err = adc_continuous_start(
        static_cast<adc_continuous_handle_t>(adc_continuous_handle_));
    adc_start_err_.store(static_cast<int32_t>(start_err), std::memory_order_relaxed);
    if (start_err != ESP_OK)
      ESP_LOGE(TAG, "adc_continuous_start failed: %s — no current and no analog "
                    "tacho for this move", esp_err_to_name(start_err));
  }

  if (gpio_backend_enabled_) {
    // Rev 3.3 has no latch: arm_latch() raises DRIVER_N_SLEEP per move and
    // refuses if any of the three fault nets is low. Rev 3.1 keeps arming its
    // latch at boot and on enable.
    const bool reverse = dir == MotorDirection::OPEN;
    if ((rev33_backend_ && !rev33_backend_->arm_latch()) ||
        !gpio_backend_->select_zone(zone, reverse) || !gpio_backend_->drive()) {
      motor_turning_ = false;
      fsm_state_ = MotorFsmState::IDLE;
      drive_output_enabled_ = false;
      ESP_LOGE(TAG, "Motor %d start rejected by the %s safety backend", zone + 1,
                gpio_backend_->backend_name());
      return false;
    }
  } else if (dir == MotorDirection::OPEN) {
    driver->reverse();
  } else {
    driver->forward();
  }
  drive_output_enabled_ = true;

  ESP_LOGI(TAG, "Motor %d started %s", zone + 1,
           dir == MotorDirection::OPEN ? "OPEN" : "CLOSE");
  return true;
}

void Lv6ValveController::stop_motor_(bool record_event) {
  if (!motor_turning_)
    return;

  DRV8215 *driver = drivers_[current_zone_];
  if (gpio_backend_enabled_ && gpio_backend_)
    gpio_backend_->coast();
  else if (driver)
    driver->coast();
  drive_output_enabled_ = false;
  last_stop_ms_ = static_cast<uint32_t>(esp_timer_get_time() / 1000);
  last_stop_zone_ = current_zone_;
  last_stop_dir_ = current_dir_;

  // Stop DMA and allow the ripple processor task to drain any pending frames
  // before the motor task reads the final ripple count.
  if (ripple_enabled_ && adc_continuous_handle_) {
    adc_continuous_stop(static_cast<adc_continuous_handle_t>(adc_continuous_handle_));
    vTaskDelay(pdMS_TO_TICKS(25));  // ~2 frame periods; ripple task drains here
  }

  if (record_event) {
    xSemaphoreTake(telemetry_mutex_, portMAX_DELAY);
    auto &t = telemetry_[current_zone_];
    t.movement_count++;
    t.movements_since_learn++;
    if (current_dir_ == MotorDirection::OPEN)
      t.open_count++;
    else
      t.close_count++;

    if (current_count_ > 0) {
      float avg = current_sum_ / static_cast<float>(current_count_);
      float &m = mean_current_(current_zone_, current_dir_);
      m = m * 0.9f + avg * 0.1f;
      if (current_dir_ == MotorDirection::OPEN)
        t.mean_open_current_ma = m;
      else
        t.mean_close_current_ma = m;
      t.mean_current_ma = m;  // legacy mirror (most recent move, either direction)
    }
    xSemaphoreGive(telemetry_mutex_);

    if (telemetry_[current_zone_].movement_count % 50 == 0)
      save_telemetry_(current_zone_);
  }

  motor_turning_ = false;
  fsm_state_ = MotorFsmState::IDLE;
  timed_mode_active_ = false;
  timed_move_duration_ms_ = 0;
  // If nSLEEP was raised for an override move, restore it to sleep
  if (nsleep_overridden_ && !DEVELOPMENT_KEEP_NSLEEP_AWAKE) {
    set_nsleep_(false);
    nsleep_overridden_ = false;
  }
  ESP_LOGI(TAG, "Motor %d stopped (%" PRIu32 "ms)", current_zone_ + 1, motor_run_time_ms_);
}

// =============================================================================
// FSM Tick (10ms)
// =============================================================================

void Lv6ValveController::process_tick_() {
  if (!motor_turning_)
    return;

  // Check if timed move duration has elapsed
  if (timed_mode_active_) {
    uint32_t now_ms = esp_timer_get_time() / 1000;
    uint32_t elapsed_ms = now_ms - timed_move_start_ms_;
    if (elapsed_ms >= timed_move_duration_ms_) {
      ESP_LOGI(TAG, "Zone %d timed move completed (%u ms)",
               current_zone_ + 1, elapsed_ms);
      stop_motor_(true);
      timed_mode_active_ = false;
      return;
    }
  }

  // Wall clock, not a tick accumulator. Every safety window below is denominated
  // in this, and an accumulator under-counts whenever the FSM task is starved —
  // silently stretching the ceiling in real time exactly when the system is
  // busiest.
  motor_run_time_ms_ =
      static_cast<uint32_t>(esp_timer_get_time() / 1000) - move_start_ms_;
  drive_phase_elapsed_ms_ += TICK_MS;

  apply_drive_output_();

  // Check nFAULT — only react to thermal and overcurrent, not stall
  // (DRV8215 stall threshold ~500mA is too high for these valve motors)
  if (!read_nfault_()) {
    if (gpio_backend_enabled_) {
      isolate_drive_fault_(rev33_backend_ ? "hardware fault net asserted"
                                          : "persistent hardware fault latch asserted");
      return;
    }
    DRV8215 *driver = drivers_[current_zone_];
    if (driver) {
      auto fault = driver->read_fault();
      if (fault.tsd)
        trigger_fault_(FaultCode::THERMAL, "thermal shutdown");
      else if (fault.ocp)
        trigger_fault_(FaultCode::OVERCURRENT, "overcurrent");
      else if (!fault.stall)
        trigger_fault_(FaultCode::UNKNOWN_FAULT, "nFAULT asserted");
      // stall flag is ignored — endstop detection is done via current sensing
    }
    return;
  }

  // --- Mechanical ceiling ----------------------------------------------------
  // Computed once in start_motor_(), enforced in BOTH commutation counts and
  // milliseconds; whichever is reached first wins.
  //
  // Counts are the mechanically meaningful currency - plunger extension follows
  // commutations, not seconds - and at a stall this actuator's counter inflates
  // rather than stopping (brush arcing), so a count ceiling errs EARLY, which is
  // fail-safe. The millisecond ceiling covers the opposite failure, a tacho that
  // has gone quiet while the motor still turns.
  //
  // This fires regardless of phase, evidence, plateau or classifier verdict. It
  // is the only guarantee in the system that does not depend on detection
  // working, and it is what eQ-3's own FALMOT-C12 appears to lack.
  const uint32_t live_counts = live_ripple_count_.load(std::memory_order_relaxed);
  const bool ms_breach = motor_run_time_ms_ >= move_limit_.limit_ms;
  const bool count_breach =
      move_limit_.limit_counts > 0 && live_counts >= move_limit_.limit_counts;
  if (ms_breach || count_breach) {
    ESP_LOGW(TAG,
             "Motor %d ceiling: run=%" PRIu32 "ms/%" PRIu32 "ms counts=%" PRIu32
             "/%" PRIu32 " source=%d breach=%s",
             current_zone_ + 1, motor_run_time_ms_, move_limit_.limit_ms,
             live_counts, move_limit_.limit_counts,
             static_cast<int>(move_limit_.source),
             count_breach ? (ms_breach ? "both" : "counts") : "time");
    trigger_fault_(FaultCode::MECHANICAL_OVERRUN,
                   count_breach
                       ? "commutation ceiling (plunger travel limit)"
                       : "runtime safety cutoff (possible actuator pop-off)");
    return;
  }

  // Calibration-only fast abort for a missing motor. A connected actuator
  // produces commutation ripples within the first couple of seconds; if ripple
  // counting is active and we've seen zero ripples well past the inrush window,
  // nothing is wired to this driver. The IPROPI lines are wire-ORed onto one
  // floating ADC pin, so noise can intermittently exceed the low-current
  // threshold and defeat detect_open_circuit_(), letting the pass otherwise run
  // to the full ~45 s runtime cap. Bail now so calibration fails fast instead
  // of pinning the CPU for the whole safety window on every pass.
  if (calibrating_ && ripple_enabled_ &&
      motor_run_time_ms_ >= CALIBRATION_NO_RIPPLE_ABORT_MS &&
      live_ripple_count_.load(std::memory_order_relaxed) == 0) {
    xSemaphoreTake(telemetry_mutex_, portMAX_DELAY);
    telemetry_[current_zone_].present = false;
    telemetry_[current_zone_].presence_known = true;
    xSemaphoreGive(telemetry_mutex_);
    trigger_fault_(FaultCode::OPEN_CIRCUIT, "no ripple — motor not connected");
    return;
  }

  // Read current from ESPHome ADC sensor
  float raw_ma = read_current_ma_();
  current_raw_ma_ = raw_ma;
  // Prime rather than ramp from zero: start_motor_() resets the filter, so an
  // unprimed EMA reads ~86% of truth at 400 ms and every early threshold is
  // measuring the filter instead of the motor.
  if (!current_filter_primed_) {
    current_filtered_ma_ = raw_ma;
    current_filter_primed_ = true;
  } else {
    current_filtered_ma_ = current_filtered_ma_ * (1.0f - CURRENT_FILTER_ALPHA) +
                            raw_ma * CURRENT_FILTER_ALPHA;
  }
  current_peak_ma_ = std::max(current_peak_ma_, current_filtered_ma_);

  // VdMot only folds free-running current into meancurrent. Once current has left
  // the free-travel band, further samples inflate mean×1.7 and push the trip past
  // the 40 s HmIP housing-exit wall.
  if (motor_run_time_ms_ >= endstop_guard_ms_) {
    // Running minimum of free travel. A feature can only push the current UP,
    // so a minimum cannot be dragged toward one; an EMA could, and did.
    if (motor_run_time_ms_ >= BASELINE_SEARCH_START_MS &&
        stroke_.phase() == StrokePhase::FREE_TRAVEL) {
      if (!baseline_valid_ ||
          current_filtered_ma_ < move_baseline_ma_ - BASELINE_EPSILON_MA) {
        move_baseline_ma_ = std::clamp(current_filtered_ma_, BASELINE_FLOOR_MA,
                                       BASELINE_CEILING_MA);
        baseline_valid_ = true;
        baseline_last_drop_ms_ = motor_run_time_ms_;
      }
    }
    // "Settled" means the minimum has stopped falling. On opening this lands
    // past the measured 57-59 mA breakaway (which decays for ~5 s), which is
    // what makes the open cap safe to arm without a magic mA threshold.
    move_baseline_set_ =
        baseline_valid_ &&
        (motor_run_time_ms_ - baseline_last_drop_ms_) >= BASELINE_STABLE_MS;

    // Only free-running current belongs in the learned mean.
    if (move_baseline_set_ && current_filtered_ma_ <= move_baseline_ma_ * 1.25f) {
      current_sum_ += current_filtered_ma_;
      current_count_++;
    }
  }
  if (debounce_count_ < 255)
    debounce_count_++;

  // Rev 3.3 drains the hardware commutation counter every tick.  There is no
  // coast interruption: the count is qualified against the commutation band and
  // blanked for the first 250 ms, because the AC-coupled front end saturates on
  // the drive-start step and emits spurious edges for about that long.
  if (rev33_backend_) {
    rev33_backend_->poll_motion(motor_run_time_ms_, drive_output_enabled_);
    const uint32_t count = rev33_backend_->motion_evidence_count();
    live_ripple_count_.store(count, std::memory_order_relaxed);
    motor_diag_evidence_count_.store(count, std::memory_order_relaxed);
    motor_diag_tacho_period_us_.store(rev33_backend_->tacho_period_us(),
                                      std::memory_order_relaxed);
    motor_diag_tacho_rejected_.store(rev33_backend_->tacho_rejected(),
                                     std::memory_order_relaxed);
    motor_diag_tacho_hardware_.store(rev33_backend_->tacho_hardware_count(),
                                     std::memory_order_relaxed);
    motor_diag_armed_.store(rev33_backend_->armed() ? 1 : 0,
                            std::memory_order_relaxed);
    motor_diag_decoder_address_.store(rev33_backend_->decoder_address(),
                                      std::memory_order_relaxed);
    motor_diag_runtime_ms_.store(motor_run_time_ms_, std::memory_order_relaxed);
    motor_diag_sample_sequence_.fetch_add(1, std::memory_order_relaxed);
    motor_diag_tacho_cadence_us_.store(rev33_backend_->tacho_cadence_us(),
                                       std::memory_order_relaxed);
    if (rev33_backend_->fault_latched()) {
      drive_output_enabled_ = false;
      isolate_drive_fault_("hardware fault net asserted mid-move");
      return;
    }

    // Advance the stroke-phase model. The current bump at pin contact and the
    // one at the hard stop are the same shape; what separates them is whether
    // the rotor recovers, which is what stretch_x10 measures.
    if (drive_output_enabled_ && !rev33_backend_->tacho_blanked(motor_run_time_ms_)) {
      stroke_.observe(count, current_filtered_ma_,
                      baseline_valid_ ? move_baseline_ma_ : 0.0f,
                      rev33_backend_->tacho_stretch_x10(motor_run_time_ms_));
      motor_diag_stroke_phase_.store(static_cast<uint8_t>(stroke_.phase()),
                                     std::memory_order_relaxed);
      if (current_dir_ == MotorDirection::CLOSE) {
        pin_onset_.observe(motor_run_time_ms_, count, current_filtered_ma_,
                           baseline_valid_ ? move_baseline_ma_ : 0.0f);
        if (pin_onset_.detected() && !stroke_.contact_seen()) {
          stroke_.note_current_contact(pin_onset_.onset_count(), current_filtered_ma_);
          // The trailing window still holds free-travel samples, so the pin
          // ramp itself reads as the seat step. Re-anchor it to the pin.
          close_step_.reset();
          endstop_high_count_ = 0;
          ESP_LOGI(TAG, "Motor %d pin contact (current) at commutation %" PRIu32
                   " (free travel %.1f mA, now %.1f mA)",
                   current_zone_ + 1, pin_onset_.onset_count(), move_baseline_ma_,
                   current_filtered_ma_);
        }
      }

      // --- physics cross-check on the counter --------------------------------
      // At a hard stop this actuator's counter does not plateau; brush arcing
      // keeps it advancing, and a measured trace showed the rate RISING while
      // the current said the rotor was stationary. Current and cadence rising
      // together is impossible for one motor, so it needs no calibrated
      // constants - only the sign of two changes.
      if (last_cadence_ms_ != 0 && motor_run_time_ms_ > last_cadence_ms_) {
        const float dt_s =
            static_cast<float>(motor_run_time_ms_ - last_cadence_ms_) / 1000.0f;
        if (dt_s > 0.0f && count >= last_cadence_count_) {
          const float cadence_hz =
              static_cast<float>(count - last_cadence_count_) / dt_s;
          spurious_.observe(motor_run_time_ms_, current_filtered_ma_, cadence_hz);
          // Free-travel reference, captured while the stroke is still unloaded.
          if (stroke_.phase() == StrokePhase::FREE_TRAVEL && cadence_hz > 0.0f)
            free_cadence_hz_ = free_cadence_hz_ <= 0.0f
                                   ? cadence_hz
                                   : free_cadence_hz_ * 0.9f + cadence_hz * 0.1f;
        }
      }
      last_cadence_count_ = count;
      last_cadence_ms_ = motor_run_time_ms_;
    }
  }

  // Publish the context the ripple task needs for the cap ladder. Single
  // writer, single reader, one word - no mutex and no torn state.
  {
    const StrokePhase ph = stroke_.phase();
    uint8_t bits = 0;
    if (current_dir_ == MotorDirection::OPEN)
      bits |= 0x01;
    if (motor_run_time_ms_ >= Rev33TachoQualifier::BLANKING_MS)
      bits |= 0x02;
    // Closing: the seat cap is withheld until the endpoint window, like every
    // other close endpoint, so it cannot trip on the pin ramp - and on Rev 3.3
    // until the break-over bump is behind us, which reaches 35-36.5 mA.
    const bool close_past_bump = rev33_backend_ == nullptr || !stroke_.contact_seen() ||
                                 seat_rise_.armed();
    if ((ph == StrokePhase::UNDER_LOAD || ph == StrokePhase::STOPPING) &&
        (current_dir_ == MotorDirection::OPEN ||
         (endpoint_window_reached_() && close_past_bump)))
      bits |= 0x04;
    if (open_fast_cap_armed_)
      bits |= 0x08;
    cap_ctx_.store(bits, std::memory_order_release);
  }

  // Rev 3.1 proves motion independently of current by briefly inhibiting the
  // decoder and sampling both motor terminals through the shared 4067.  The
  // backend restores the original latched direction only after the mandatory
  // 1 ms coast interval.
  if (rev31_backend_ && drive_output_enabled_ &&
      (last_bemf_sample_ms_ == 0 ||
       motor_run_time_ms_ - last_bemf_sample_ms_ >= REV31_BEMF_SAMPLE_PERIOD_MS)) {
    last_bemf_sample_ms_ = motor_run_time_ms_;
    const auto sample = rev31_backend_->sample_bemf(motor_run_time_ms_, true);
    rev31_diag_raw_a_.store(static_cast<uint16_t>(sample.raw_a & 0x0FFF),
                            std::memory_order_relaxed);
    rev31_diag_raw_b_.store(static_cast<uint16_t>(sample.raw_b & 0x0FFF),
                            std::memory_order_relaxed);
    rev31_diag_differential_.store(sample.motion.differential_raw,
                                   std::memory_order_relaxed);
    rev31_diag_separation_us_.store(sample.motion.separation_us,
                                    std::memory_order_relaxed);
    rev31_diag_sample_valid_.store(sample.motion.valid ? 1 : 0,
                                   std::memory_order_relaxed);
    rev31_diag_sample_moving_.store(sample.motion.moving ? 1 : 0,
                                    std::memory_order_relaxed);
    motor_diag_evidence_count_.store(rev31_backend_->motion_evidence_count(),
                                     std::memory_order_relaxed);
    motor_diag_runtime_ms_.store(motor_run_time_ms_,
                                       std::memory_order_relaxed);
    motor_diag_sample_sequence_.fetch_add(1, std::memory_order_relaxed);
    drive_output_enabled_ = !rev31_backend_->fault_latched();
    live_ripple_count_.store(rev31_backend_->motion_evidence_count(),
                             std::memory_order_relaxed);
    if (!sample.motion.valid) {
      if (rev31_invalid_bemf_samples_ < UINT8_MAX)
        rev31_invalid_bemf_samples_++;
      rev31_diag_invalid_samples_.store(rev31_invalid_bemf_samples_,
                                        std::memory_order_relaxed);
      ESP_LOGW(TAG, "BEMF sample rejected (%u/%u): ADC failure or terminal separation %u us exceeds 50 us",
               rev31_invalid_bemf_samples_, REV31_MAX_INVALID_BEMF_SAMPLES,
               sample.motion.separation_us);
      trace_sample_(-1, current_raw_ma_);
      if (rev31_invalid_bemf_samples_ >= REV31_MAX_INVALID_BEMF_SAMPLES) {
        trigger_fault_(FaultCode::UNKNOWN_FAULT,
                       "BEMF endpoint sensor invalid");
        return;
      }
    } else {
      rev31_invalid_bemf_samples_ = 0;
      rev31_diag_invalid_samples_ = 0;
      trace_sample_(-1, current_raw_ma_);
    }
  }

  // Early already-at-stop — evaluated DURING boost, before the current-filter debounce,
  // so it can fire before sustained boost force pops an already-closed actuator off its
  // pin. The motor commutates within the first tens of ms of the 100%-duty boost, so
  // zero ripples by EARLY_STALL_MS means it never moved → it is already against the stop
  // it was commanded toward. Current presence (boost current) confirms it is connected,
  // not missing. Gated to endstop-seeking moves; a moving motor (any ripples) is exempt.
  //
  // Rev 3.3 is excluded. EARLY_STALL_MS is 250 ms and so is the tacho blanking,
  // so the commutation count is zero here BY CONSTRUCTION and this would fire on
  // a healthy move. already_at_stop in detect_endstop_() covers the same
  // condition, anchored to motion_decision_ms_() and routed through the endpoint
  // classifier instead of stopping the move behind its back.
  if ((calibrating_ || drive_to_endstop_active_) && ripple_enabled_ &&
      rev33_backend_ == nullptr &&
      motor_run_time_ms_ >= EARLY_STALL_MS &&
      live_ripple_count_.load(std::memory_order_relaxed) == 0 &&
      current_raw_ma_ >= motor_cfg_.low_current_threshold_ma) {
    if (gpio_backend_enabled_) {
      // With no prior motion, current+BEMF cannot distinguish a genuine
      // already-at-stop condition from a pre-existing mechanical obstruction.
      // Stop early, but do not promote the ambiguous state to a known endpoint.
      trigger_fault_(FaultCode::BLOCKED,
                     "no startup motion under load; endpoint versus jam is ambiguous");
      return;
    }
    ESP_LOGI(TAG, "Motor %d endstop (at_stop_early: raw=%.1f mA, t=%" PRIu32 "ms)",
             current_zone_ + 1, current_raw_ma_, motor_run_time_ms_);
    xSemaphoreTake(telemetry_mutex_, portMAX_DELAY);
    auto &t = telemetry_[current_zone_];
    if (current_dir_ == MotorDirection::OPEN) {
      t.last_open_endstop_ms = motor_run_time_ms_;
      t.current_position_pct = 100.0f;
    } else {
      t.last_close_endstop_ms = motor_run_time_ms_;
      t.current_position_pct = 0.0f;
    }
    xSemaphoreGive(telemetry_mutex_);
    endpoint_confirmed_ = true;
  // A confirmed endpoint is the one event that re-establishes a trustworthy
  // datum, so it is the only thing that may set position confidence.
  if (current_zone_ < NUM_ZONES)
    position_confident_[current_zone_] = true;
    stop_motor_(true);
    return;
  }

  if (debounce_count_ < DEBOUNCE_TICKS)
    return;

  detect_endstop_();
  detect_open_circuit_();
  detect_pin_engagement_();
}

void Lv6ValveController::apply_drive_output_() {
  // The fast DMA path has already taken the drive off for this move. Re-arming
  // it here would hand the bridge straight back to whatever tripped it.
  if (drive_inhibited_)
    return;
  DRV8215 *driver = drivers_[current_zone_];
  if (gpio_backend_enabled_ && !gpio_backend_)
    return;
  if (!gpio_backend_enabled_ && !driver)
    return;

  auto drive_selected = [&]() -> bool {
    if (gpio_backend_enabled_)
      return gpio_backend_->drive();
    if (current_dir_ == MotorDirection::OPEN)
      driver->reverse();
    else
      driver->forward();
    return true;
  };
  auto coast_selected = [&]() {
    if (gpio_backend_enabled_)
      gpio_backend_->coast();
    else
      driver->coast();
  };

  if (fsm_state_ == MotorFsmState::BOOST) {
    if (!drive_output_enabled_) {
      drive_output_enabled_ = drive_selected();
    }
    if (motor_run_time_ms_ >= motor_cfg_.pwm_boost_ms) {
      fsm_state_ = MotorFsmState::HOLD;
      drive_phase_elapsed_ms_ = 0;
    }
  } else if (fsm_state_ == MotorFsmState::HOLD) {
    uint32_t period = motor_cfg_.pwm_period_ms;
    if (period == 0)
      period = 40;
    uint32_t on_time = (period * effective_hold_duty_()) / 100;
    uint32_t phase_pos = drive_phase_elapsed_ms_ % period;

    if (phase_pos < on_time) {
      if (!drive_output_enabled_) {
        drive_output_enabled_ = drive_selected();
      }
    } else {
      if (drive_output_enabled_) {
        coast_selected();
        drive_output_enabled_ = false;
      }
    }
  }
}

void Lv6ValveController::sanitize_motor_cfg_() {
  // NVS holds bring-up values that an operator can edit, so a nonsensical pair
  // must not silently disable the stall verdict. A floor above the ceiling would
  // make adaptive_plateau_ms() return the floor unconditionally, which is a
  // longer debounce than either value asked for.
  if (motor_cfg_.stall_plateau_floor_ms > motor_cfg_.stall_plateau_ceiling_ms) {
    ESP_LOGW(TAG, "stall_plateau floor %" PRIu32 "ms exceeds ceiling %" PRIu32 "ms; swapping",
             motor_cfg_.stall_plateau_floor_ms, motor_cfg_.stall_plateau_ceiling_ms);
    std::swap(motor_cfg_.stall_plateau_floor_ms, motor_cfg_.stall_plateau_ceiling_ms);
  }
  if (motor_cfg_.endpoint_window_tolerance_pct > 100)
    motor_cfg_.endpoint_window_tolerance_pct = 100;
  // A motion decision inside the blanking window would see a zero commutation
  // count by construction and read it as "never moved".
  if (motor_cfg_.motion_decision_ms > 0 &&
      motor_cfg_.motion_decision_ms <= Rev33TachoQualifier::BLANKING_MS) {
    ESP_LOGW(TAG, "motion_decision_ms %" PRIu32 "ms is inside the %" PRIu32
             "ms tacho blanking; deriving it instead",
             motor_cfg_.motion_decision_ms, Rev33TachoQualifier::BLANKING_MS);
    motor_cfg_.motion_decision_ms = 0;
  }
  // HmIP-VDMOT plunger is destroyed above ~40 s continuous drive. Clamp any
  // persisted bring-up value (defaults used to be 50 s; Motor Lab added headroom).
  if (motor_cfg_.hmip_vdmot_runtime_limit_s > HMIP_VDMOT_RUNTIME_LIMIT_MAX_S) {
    ESP_LOGW(TAG, "hmip_vdmot_runtime_limit_s %" PRIu32 "s exceeds %" PRIu32 "s mechanical ceiling; clamping",
             motor_cfg_.hmip_vdmot_runtime_limit_s, HMIP_VDMOT_RUNTIME_LIMIT_MAX_S);
    motor_cfg_.hmip_vdmot_runtime_limit_s = HMIP_VDMOT_RUNTIME_LIMIT_MAX_S;
  }
  if (motor_cfg_.max_runtime_s > HMIP_VDMOT_RUNTIME_LIMIT_MAX_S &&
      motor_cfg_.default_profile == MotorProfile::HMIP_VDMOT) {
    motor_cfg_.max_runtime_s = HMIP_VDMOT_RUNTIME_LIMIT_MAX_S;
  }
  // The CLOSE ceiling is the mechanical one and must keep real margin under the
  // 40 s housing-exit boundary - 40 s IS the destruction point, not a safe limit.
  if (motor_cfg_.hmip_vdmot_open_runtime_limit_s > 120)
    motor_cfg_.hmip_vdmot_open_runtime_limit_s = 120;
  if (motor_cfg_.close_runtime_limit_counts == 0) {
    motor_cfg_.close_runtime_limit_counts = MotorConfig{}.close_runtime_limit_counts;
  } else if (motor_cfg_.close_runtime_limit_counts > 3000) {
    ESP_LOGW(TAG, "close_runtime_limit_counts %" PRIu32 " outside the plunger travel "
                  "budget; clamping to 3000",
             motor_cfg_.close_runtime_limit_counts);
    motor_cfg_.close_runtime_limit_counts = 3000;
  }
  if (motor_cfg_.stroke_uncertainty_pct > 50)
    motor_cfg_.stroke_uncertainty_pct = 50;
  if (motor_cfg_.runtime_floor_ms < 1000 || motor_cfg_.runtime_floor_ms > 5000)
    motor_cfg_.runtime_floor_ms = 2000;

  // Current factors: a corrupted value silently disables detection. VdMot #132
  // reports a stored factor becoming 3.7 on a reset, which at ~20 mA mean would
  // never trip at all.
  auto clamp_factor = [](float &f, const char *name) {
    if (!(f >= 1.05f && f <= 2.5f)) {
      ESP_LOGW(TAG, "%s %.2f out of range; resetting to 1.45", name, f);
      f = 1.45f;
    }
  };
  clamp_factor(motor_cfg_.close_current_factor, "close_current_factor");
  clamp_factor(motor_cfg_.open_current_factor, "open_current_factor");
  if (!(motor_cfg_.open_endstop_current_factor >= 1.05f &&
        motor_cfg_.open_endstop_current_factor <= 2.5f))
    motor_cfg_.open_endstop_current_factor = MotorConfig{}.open_endstop_current_factor;
  // The trailing step is the primary close detector. A zero step or window would
  // trip on noise; an oversized one would never trip before the ceiling.
  if (!(motor_cfg_.close_trailing_step_ma >= 0.5f && motor_cfg_.close_trailing_step_ma <= 20.0f))
    motor_cfg_.close_trailing_step_ma = MotorConfig{}.close_trailing_step_ma;
  if (motor_cfg_.close_trailing_ref_ms < 250 || motor_cfg_.close_trailing_ref_ms > 10000)
    motor_cfg_.close_trailing_ref_ms = MotorConfig{}.close_trailing_ref_ms;
  if (motor_cfg_.close_trailing_sustain_ms > 10000)
    motor_cfg_.close_trailing_sustain_ms = MotorConfig{}.close_trailing_sustain_ms;

  // Working-range learning. The open legs are the only moves that head toward
  // the gear stop on purpose, so their bound may never exceed the open count
  // ceiling, and the first leg must at least clear the free-travel proof.
  {
    const MotorConfig d{};
    auto &m = motor_cfg_;
    // Every open leg is followed by a close pass back to the seat, and that pass
    // runs under the close bootstrap ceiling. A leg longer than the ceiling
    // minus its budget can never be closed again inside it.
    uint32_t leg_ceiling = m.open_runtime_limit_counts > 0 ? m.open_runtime_limit_counts
                                                           : d.learn_open_max_ripples;
    if (m.close_runtime_limit_counts > m.close_overrun_budget_counts)
      leg_ceiling = std::min(leg_ceiling, m.close_runtime_limit_counts - m.close_overrun_budget_counts);
    if (m.learn_open_max_ripples < 500 || m.learn_open_max_ripples > leg_ceiling)
      m.learn_open_max_ripples = std::min(d.learn_open_max_ripples, leg_ceiling);
    if (m.learn_min_free_ripples < 20 || m.learn_min_free_ripples > 1000)
      m.learn_min_free_ripples = d.learn_min_free_ripples;
    if (m.learn_open_start_ripples <= m.learn_min_free_ripples ||
        m.learn_open_start_ripples > m.learn_open_max_ripples)
      m.learn_open_start_ripples = std::min(d.learn_open_start_ripples, m.learn_open_max_ripples);
    if (m.learn_open_step_ripples < 50 || m.learn_open_step_ripples > 2000)
      m.learn_open_step_ripples = d.learn_open_step_ripples;
    if (m.learn_samples < 1 || m.learn_samples > StrokeLearner::MAX_SAMPLES)
      m.learn_samples = d.learn_samples;
    if (m.learn_max_spread_pct < 1 || m.learn_max_spread_pct > 50)
      m.learn_max_spread_pct = d.learn_max_spread_pct;
    // The pin detector's step: below ~1 mA it fires on noise, above ~4 mA it
    // latches so late the onset back-projection has to reach too far.
    if (!(m.pin_engage_step_ma >= 1.0f && m.pin_engage_step_ma <= 4.0f))
      m.pin_engage_step_ma = d.pin_engage_step_ma;
    if (m.pin_engage_margin_ripples > 500)
      m.pin_engage_margin_ripples = d.pin_engage_margin_ripples;
  }
  if (!(motor_cfg_.open_endstop_stall_fraction >= 0.10f &&
        motor_cfg_.open_endstop_stall_fraction <= 0.60f))
    motor_cfg_.open_endstop_stall_fraction = 0.30f;

  // A partially reordered cap ladder is not obviously safe, so sanitize_cap_ladder
  // resets all four thresholds rather than swapping the offending pair.
  const CapLadder sane = sanitize_cap_ladder(cap_ladder_(), RAIL_COMPARATOR_TRIP_MA);
  if (!cap_ladder_is_monotonic(cap_ladder_()))
    ESP_LOGW(TAG, "current cap ladder was not monotonic; restoring defaults");
  motor_cfg_.cap_close_seat_ma = sane.seat_ma;
  motor_cfg_.cap_close_popoff_ma = sane.popoff_ma;
  motor_cfg_.cap_stall_ma = sane.stall_ma;
  motor_cfg_.cap_circuit_fault_ma = sane.circuit_ma;
  motor_cfg_.cap_open_stop_ma = sane.open_stop_ma;
  motor_cfg_.cap_close_seat_frames = sane.seat_frames;
  motor_cfg_.cap_close_popoff_frames = sane.popoff_frames;
  motor_cfg_.cap_stall_frames = sane.stall_frames;
  motor_cfg_.cap_circuit_frames = sane.circuit_frames;
  motor_cfg_.cap_open_frames = sane.open_frames;
  motor_cfg_.cap_min_valid_samples = sane.min_valid_samples;

  // The tracker's "slowing" precursor must sit below its "stopping" threshold.
  if (motor_cfg_.slowdown_plateau_factor_x10 >= motor_cfg_.stall_plateau_factor_x10)
    motor_cfg_.slowdown_plateau_factor_x10 =
        static_cast<uint16_t>(motor_cfg_.stall_plateau_factor_x10 / 2);
}
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
