Birkemosen/lune/lune-v6/components/lv6_valve_controller/rev31_motor_backend.cpp

#include "rev31_motor_backend.h"

#include "esphome/core/log.h"
#include "esp_adc/adc_cali_scheme.h"
#include "esp_rom_sys.h"
#include "esp_timer.h"

#include <algorithm>

namespace lv6 {

static const char *const TAG = "lv6_rev31_motor";

void Rev31MotorBackend::delay_us_(uint32_t microseconds) const {
  esp_rom_delay_us(microseconds);
}

bool Rev31MotorBackend::configure_adc_() {
  adc_unit_t current_unit;
  adc_unit_t bemf_unit;
  if (adc_oneshot_io_to_channel(static_cast<int>(pins_.adc_current),
                                &current_unit, &current_channel_) != ESP_OK ||
      adc_oneshot_io_to_channel(static_cast<int>(pins_.adc_bemf),
                                &bemf_unit, &bemf_channel_) != ESP_OK ||
      current_unit != bemf_unit) {
    ESP_LOGE(TAG, "ADC_CURRENT and ADC_BEMF must map to the same ADC unit");
    return false;
  }
  adc_unit_ = current_unit;

  adc_oneshot_unit_init_cfg_t unit_cfg = {};
  unit_cfg.unit_id = adc_unit_;
  unit_cfg.ulp_mode = ADC_ULP_MODE_DISABLE;
  if (adc_oneshot_new_unit(&unit_cfg, &adc_handle_) != ESP_OK)
    return false;

  adc_oneshot_chan_cfg_t channel_cfg = {};
  channel_cfg.atten = ADC_ATTEN_DB_12;
  channel_cfg.bitwidth = ADC_BITWIDTH_12;
  if (adc_oneshot_config_channel(adc_handle_, current_channel_, &channel_cfg) != ESP_OK ||
      adc_oneshot_config_channel(adc_handle_, bemf_channel_, &channel_cfg) != ESP_OK)
    return false;

  adc_cali_curve_fitting_config_t current_cfg = {};
  current_cfg.unit_id = adc_unit_;
  current_cfg.chan = current_channel_;
  current_cfg.atten = ADC_ATTEN_DB_12;
  current_cfg.bitwidth = ADC_BITWIDTH_12;
  if (adc_cali_create_scheme_curve_fitting(&current_cfg, &current_calibration_) != ESP_OK) {
    current_calibration_ = nullptr;
    ESP_LOGW(TAG, "ADC_CURRENT calibration unavailable; using nominal conversion");
  }

  return true;
}

bool Rev31MotorBackend::setup() {
  const uint64_t output_mask = (1ULL << pins_.address0) |
                               (1ULL << pins_.address1) |
                               (1ULL << pins_.address2) |
                               (1ULL << pins_.motor_enable) |
                               (1ULL << pins_.terminal_direction) |
                               (1ULL << pins_.latch_arm);
  gpio_config_t outputs = {};
  outputs.pin_bit_mask = output_mask;
  outputs.mode = GPIO_MODE_OUTPUT;
  outputs.pull_up_en = GPIO_PULLUP_DISABLE;
  outputs.pull_down_en = GPIO_PULLDOWN_DISABLE;
  if (gpio_config(&outputs) != ESP_OK)
    return false;

  gpio_set_level(pins_.motor_enable, 0);
  gpio_set_level(pins_.address0, 0);
  gpio_set_level(pins_.address1, 0);
  gpio_set_level(pins_.address2, 0);
  gpio_set_level(pins_.terminal_direction, 0);
  gpio_set_level(pins_.latch_arm, 0);
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
