Birkemosen/lune/(commit log)

2026-10-05 Lune V6: local 6-zone hydronic manifold controller
    Fresh baseline. Earlier history was squashed; notable fixes carried
    forward in this tree:
    - Rev 3.3 endstop detection rebuilt around measured motor traces;
    soft-seat detection via plateau-referenced current rise.
    - MOTOR_CONFIG_VERSION bumped to 6 so stored motor configs reset onto
    the Rev 3.3 defaults (v5 reset was missed in the field).
    - Durable settings survive flash and reboot (per-section NVS).
    - Touch lease sequence/issued/duration parsed as uint32, not float.
    - Atomic cross-thread hardening in the valve/zone controllers.
    - Real HTTP status codes from the API so write auth can prompt.
    - Drive-to-endstop safety timeout in execute_m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
2026-10-05 Remove Rev 3.2 support
    Rev 3.2 has design faults that keep it from working, so it is dropped
    entirely: hardware folder, board package, the rev32_gpio backend and
    everything tied to its fault latch (LATCH_ARM, arm-clock probe and its
    API endpoint, latch diagnostics).
    The Rev 3.3 backend inherited the decoder, tacho and ADC handling from
    the Rev 3.2 class; that is now folded into one self-contained
    Rev33MotorBackend with unchanged behaviour. rev32_logic.h becomes
    rev33_logic.h. The board-revision probe stays, so a Rev 3.3 image still
    refuses to drive motors on an older board.
    rev32_motion_decision_ms is renamed motion_decision_ms; settings backups
    using the old key still import. The diagnost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
2026-10-05 V6: change WiFi from the web UI; credentials survive OTA
    - No STA ssid/password compiled into any build. The lune_wifi component
    (shared with Lune Touch) seeds ESPHome's OTA-stable WiFi preference once
    from secrets in dev builds (never in release images) and switches
    network at runtime, reverting if the new one does not connect in 30 s.
    - GET/POST /api/v1/wifi (CSRF-gated) and a WiFi panel under Connections.
    - The captive portal page wins "/" while the fallback AP is active.
2026-10-06 V6 heat-pump mode: keep flow in every loop, open more for zones that need heat
    - One continuous opening curve: below setpoint − band ≥ "opening when
    calling" (new hp_demand_pct, default 80 %), ramping to the base opening
    at setpoint and to the trim floor at setpoint + margin. The trim floor is
    now held until a zone is overheated instead of dropping to 0 at the
    margin edge, which closed whole manifolds on sunny days.
    - An overheated zone keeps its floor while the manifold supply is no more
    than 1 °C warmer than the room (cool water cannot heat it); it closes
    only when the supply is warmer or unknown.
    - Control config v3 adds hp_demand_pct; v2 blobs are migrated, not reset.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
2026-10-06 V6 web UI on Home / sheet / System (Lune Design System 2.3.2)
    - navbar Home | System; Home: status line, fault panel, "Heat now",
    zone strip and comfort per zone; tiles and rows open sheets
    - zone sheets (overview with autosaved target, history with .zc zone
    chart, settings as grouped lists) and a manifold sheet (heating mode
    and heat-pump limits, preheat, preload, end-stop limits)
    - System: device, manifold and motors, connections, firmware and backup,
    service; motor lab only on dev firmware
    - zone/{i}/room|floor|motor merged into zone/{i} with data-patch (same
    API calls, only changed parts); heating merged with regulation;
    return probes with manifold; backup import now asks for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
2026-10-07 Docs index, table of contents in the manual and API, device-identity anchor
2026-10-07 V6: re-home to the seat is never skipped; history buffer in PSRAM; neutral comfort temperature
    - execute_move_ skipped any move under min_move, including the re-home to 0 %
    when the valve already believed it was at 0 % but had not confirmed the seat
    (after every reboot). Confidence stayed false and every open was refused as
    'unknown position', on both boards. skip_small_move() keeps the seat move;
    covered by test-safety-limits.
    - /api/v1/history copied the ring (~11 KiB) with malloc into internal RAM, which
    has a 6 KiB largest block: 503 Out of memory, so the UI never showed history.
    Uses alloc_scratch (PSRAM first).
    - Comfort by zone: temperature no longer turns yellow below tar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
2026-10-07 V6: serve the last crash log in diagnostics (last_crash)
    ESPHome's crash handler already records the panic; capture its esp32.crash
    log lines at boot into PSRAM and include them in /api/v1/diagnostics.
    Keep build ELFs in output/elf/ (ignored) for addr2line.
2026-10-07 V6: stop the manifold save from inverting valves and disabling drivers
    - The UI mapped the select label "NO (Normally Open)" to NC, and the
    firmware read the UI's "normally_open" as NC, so every Manifold save
    stored NC on an NO manifold and inverted all valve control.
    The radio now reads the label, the save writes NO/NC only when changed,
    and the firmware accepts all three spellings and ignores unknown values.
    - The Manifold save also wrote the drivers switch, persisting "off" when
    saved while drivers were briefly off after an OTA. The switch already
    autosaves on toggle, so the save no longer writes it.
2026-10-08 V6: ship the device page without sample data
    build_ui.py baked the preview's sample zones (names, temperatures, valve %)
    and manifold readings into the firmware page, so every reload showed demo
    values until /state arrived, and longer when it was slow. The device build
    now renders "—" placeholders; preview/mock keep the samples.
2026-10-08 V6: accept Touch's house balance per zone
    POST /api/v1/zones/{n}/house-balance {factor, ttl_s} (Touch authentication)
    multiplies the zone's balance factor, clamped to 0.2..1, RAM only and
    back to 1.0 when the TTL lapses. /zones now reports pipe_inner_mm,
    pipe_spacing_mm, supply_pipe_length_m and house_balance.
2026-10-09 V6: re-home a valve that is already on or near its seat; keep positions across reboots
    - A close-to-seat drive that stops under load where the seat was expected
    (held position x learned stroke, within a margin) is the seat. Before, a
    re-home from a closed valve never left FREE_TRAVEL or reached the
    full-stroke window, read as a jam, and every zone ended BLOCKED with
    every open refused. Every JAM on a commanded endpoint now logs the check.
    - Drives into the seat get 15 % extra travel in the ceiling (seat press and
    count drift); a valve held at 5.8 % overran a 265-count window.
    - The last positions are stored in NVS (motpos, written when one changes by
    0.5 % or more) and restored a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
2026-10-20 V6: a motor fault no longer stops every motor; drivers recover; balancing mode selectable
    - A fault net during a move now blocks only that motor (only one is ever
    driven). The drivers go off only if the net stays asserted with every
    bridge idle (a board fault) or when the user turns them off.
    - Drivers that are wanted on but went off (fault, failed arm, an OTA that
    never rebooted) are re-armed with backoff (1 min doubling to 30 min). The
    reason is reported (state text_sensor-motor_drivers_off_reason, diagnostics
    drivers_off) and Home shows an alert with Turn motors on. Both boards had
    sat with drivers off for days without anyone noticing.
    - balancing_mode (static/adaptive) is a s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
2026-10-20 V6: 1-Wire probes at 12 bit (0.0625 C)
    At 10 bit the 0.25 C steps made manifold and zone return dT jump between
    0 and 0.5 K; the 750 ms conversion fits easily in the 10 s update interval.
2026-10-20 V6: reset guide with valve position, breakaway retry, early seat accepted, stale faults clear
    - Zone fault panel: fault in plain words (no raw codes), checklist and
    'The valve is' (closed/in between/open/not sure). Closed/open seeds the
    position (set_position_hint) so the motor runs without re-homing.
    - Driver fault in the first 200 ms is retried (3 per hour) before blocking;
    the aborted run keeps the old position. 0.5 s pause between re-home legs.
    - A closing re-home that meets the seat early is the seat: the remembered
    position is a hint only.
    - A clean move clears a fault restored from NVS.
    - Manual: reset guide, drivers recovery, balancing mode, positions, 12-bit probes.
2026-10-20 V6: drive a blocked motor back from the fault panel; overrun stays blocked across restarts
    - Reset guide: 'Did the motor run too far?' with Drive the motor back
    (5/10/20 s). V6 picks the direction away from the fault, end stop armed;
    the zone stays blocked until the fault is reset.
    - MECHANICAL_OVERRUN is saved when it happens and restores the block at
    boot, so a re-home does not push another full stroke on every restart.
    - Manual updated.
2026-10-20 V6: heat pump phase from Touch; satisfied rooms use the trim floor while the heat pump is idle
    - control_mode_policy: hp_idle uses the trim floor as the base for satisfied
    rooms; demand and the comfort band are unchanged (tests).
    - POST /api/v1/heat-pump-phase (Touch auth, TTL 60-3600 s); /zones reports
    hp_phase; the manifold sheet shows it in one line.
    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
2026-10-20 README: $20–60 per Lune V6 built is appreciated (voluntary)
2026-10-20 README screenshot: current V6 home
2026-10-20 V6 BLE: no scan-request flood while NimBLE syncs; sync watchdog restarts the stack, then reboots (max 3 in a row)
    On .14 the NimBLE host sometimes never started after an OTA boot
    (nimble_port_stop rc=2): no BLE room temperatures, and lv6_ble_demand asked
    for a scan every loop (~100 log lines/s). Now:
    - lv6_ble_demand does not re-request a scan that is already queued.
    - nimble_hub restarts the stack after 30 s without sync (backoff), and after
    two failed restarts reboots the device (RTC counter, max 3 in a row, reset
    on sync). A reboot is what fixed it by hand; valves hold across it.
2026-10-21 V6: 'close fully above target' in heat-pump mode, with a manifold flow guarantee
    - hp_close_above_c (0 = off): a room at setpoint + limit closes its loop fully
    (latched, reopens 0.2 C below); a room that needs heat is never closed.
    - Flow guarantee: below Min. total opening (else 30 %), the closed loops
    nearest their target reopen to the trim floor, one at a time
    (reopen_for_min_total, tests).
    - Control config v4 with v3 -> v4 migration (settings preserved; schema test).
    - Setting in the manifold sheet (Heat pump limits), API, state, backup, manual.
2026-10-21 V6: reopen warm-closed loops ahead of the floor's lag
    - A loop closed because its room is warm reopens on the temperature expected
    one floor lag ahead (measured fall x lag), not on the measured one. Reopen
    point: setpoint + 0.3 C, always 0.2 C below the close point (Normal: setpoint
    - 0.2 instead of setpoint - comfort band).
    - Floor lag prior from slab type/thickness plus covering resistance; it
    stretches with closed time (up to 2x after 4 h) as the slab loses its heat.
    - Gentle reopen at the satisfied opening; min. 20 min closed; 0.2 C
    hysteresis; trend sampled per 30 min (0.1 C sensors), EWMA.
    - reopen_policy.h with host tests (make test-reopen); manual section.
2026-10-21 V6: problem notifications to Home Assistant (contract v1)
    - lv6_problems: problem tracker (hold time, max one raise per id per hour,
    cleared only after a sent raise, hysteresis) firing the HA event
    esphome.lune_problem; entities Active problems / Problems.
    - Problems: valve fault, stall, calibration failed; room temperature or
    manifold probe missing 30 min; BTHome battery (15 % / 5 %) and humidity
    (> 60 % / < 40 % for 1 h).
    - BTHome bridge decodes battery and humidity; zone API returns battery_pct and
    humidity_pct. api: homeassistant_services.
    - shared/contracts/lune_notifications_contract_v1.md; manual section; tests.
2026-10-21 V6 BLE: keep retrying after the reboot cap (one reboot per 30 min uptime)
    On 21 Oct .14 lost NimBLE sync after an OTA boot, used its three watchdog
    reboots and then gave up: 3 h without room temperatures, valves held at the
    maintenance opening while the upper floor overheated. Past the cap the
    watchdog now reboots at most once per 30 min of uptime instead of never.
2026-10-21 V6: NimBLE host and zone task stacks in PSRAM (BLE never started on .14)
    IDF's nimble_port_freertos_init() ignores a failed xTaskCreate. After the
    controller allocates, .14 had ~14 KiB internal RAM free with a 7.5 KiB largest
    block, so the host task's 8 KiB stack never fit: no task, no sync, no room
    temperatures (nimble_port_stop rc=2). .13 ran with 6 KiB internal free and
    28 B DMA.
    - nimble_hub creates the host task itself, stack in PSRAM (internal fallback),
    logs a failure instead of hiding it, and deletes the parked task on deinit.
    The host task never touches flash (no bonding store; BTHome callbacks read RAM).
    - lv6_zone's 16 KiB stack moves to PSRAM (it never writes flash itself; co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
2026-10-21 V6: valve task no longer copies the whole config (2.6 KiB per call)
    lv6_valve on .13 had 1.8 KiB of its 16 KiB stack left after motor moves:
    run_ -> execute_move_ -> effective_current_factor_ each copied DeviceConfig
    (~2.6 KiB; `const auto &cfg = get_config()` binds a temporary, still a copy).
    - Lv6ConfigStore::read(f): runs f(const DeviceConfig &) under the store mutex,
    no copy (f short, no re-entry).
    - Valve controller uses read() / get_motor_config() / get_manifold_type();
    per-function frames drop from ~2.7 KiB to < 0.4 KiB (-fstack-usage).
2026-10-21 V6: no whole-config copies on loop/httpd paths; valve task stack 16 -> 10 KiB
    - Zone controller and dashboard read single fields through
    Lv6ConfigStore::read() instead of get_config() (28 sites); the system
    snapshot builds straight into the caller's buffer without config copies
    (try_get_system_snapshot 5.8 KiB -> gone from the top frames,
    update_snapshot_ 3.7 KiB -> gone).
    - lv6_valve stack 10 KiB: after the copy removal it peaks near 3 KiB with
    motors moving (16 KiB had 13.4 KiB free on .13 and 13.6 KiB on .14).
2026-10-21 V6: setup and loop paths stop copying the whole config
    loopTask peaked at ~11.9 KiB of 16 KiB during boot on both boards:
    zone setup() -> recalculate_balance_factors_() -> calculate_hydraulic_outputs_()
    each copied DeviceConfig (2.6 KiB), and so did YAML lambdas and the BLE
    demand/time-beacon checks that run every loop.
    - Zone controller setup/dump_config/balance/hydraulics read only the sections
    they use (zones + balancing, probes) via read(); boot chain ~8.1 -> ~2.2 KiB.
    - YAML (ui.yaml, climate.yaml): 20 motor setters copy only the motor section,
    the motor-profile setter one zone, 20 getters use read(), on_boot reads only
    the setpoints.
    - lv6_ble_demand (every loop) and lv6_ble_time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
2026-10-21 V6: loopTask stack 16 -> 12 KiB
    Peak use is ~5.4 KiB on both boards (incl. a full motor calibration on .14)
    since setup and loop paths stopped copying DeviceConfig. 12 KiB keeps more
    than 2x headroom for paths not measured (OTA) and returns 4 KiB of internal RAM.
2026-10-22 V6: rebuild UI on LDS 2.3.22 (motor-fault recovery panel no longer squeezed)
2026-10-26 V6: malloc may use PSRAM; notify when the controller restarted after a crash
    - On 25 Oct 23:37 .13 aborted in loopTask: the native API's send buffer could
    not grow (operator new failed). ESPHome's psram component selects caps-only
    allocation, so every malloc/new came from ~37 KB of internal RAM while 7.9 MB
    of PSRAM sat idle. Now CONFIG_SPIRAM_USE_MALLOC: < 4 KB prefers internal and
    falls back to PSRAM, larger allocations go to PSRAM, 32 KB internal reserved
    for DMA/internal-only. No ISR is registered IRAM-safe, so none touches PSRAM
    while the cache is off; DMA buffers use MALLOC_CAP_DMA.
    - lv6_problems: new problem device.restart (category "device", contract):
    raised once Home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
2026-10-26 V6 BTHome: publish room temperatures from the main loop, not the NimBLE task
    Root cause of both crashes: lv6_bthome_bridge called sensor::publish_state()
    from the NimBLE host task. ESPHome entities and the native API's deferred send
    batch are not thread-safe; a publish on the host task while loopTask was
    encoding the batch corrupted it.
    - .14, 23 Oct: LoadProhibited at 0x0000EA60 in Climate::get_traits() via
    APIConnection::try_send_climate_state (a garbage entity pointer).
    - .13, 25 Oct: abort in APIBuffer::grow_ (operator new failed on a garbage size).
    The host task now parks the reading (atomics) and the bridge's loop() publishes
    it on the main loop task. Zone-controller setters it still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
2026-10-26 Room physics contract: daily UA learning, area×valve energy split, recalibration on Odin HL change
2026-10-26 Room physics contract: add internal gains back to Odin's net heat loss (calibration and daily learning)
2026-10-27 V6: a blocked close to the seat backs off and closes again; seated-early warning only on a real stop
    - An ordinary close to the seat (re-home, 0 % target) that ends BLOCKED now
    backs off open and closes once more, like learning's home_to_seat_. A valve
    already on its seat at the first re-home after a restart no longer stays
    BLOCKED until someone resets it.
    - 'Seated N ripples early' is logged only when the stop is accepted as the
    seat, not mid-travel while the count is still low.
    - Build 279.
2026-10-30 V6: blocked zones raise the fault alert; fault guide fits on mobile (LDS 2.3.28), reset group titled, shorter valve label. Build 281.
2026-10-30 V6 Home: zone cards with a 24 h chart (temperature, target, heating) replace the comfort list; LDS SVG defs on the page (LDS 2.3.29). Build 283.
2026-11-02 V6 changelog: rc1 describes rev 3.3 hardware (3× DRV8411, one-hot decoder) and the heat loss from Touch
2026-11-02 V6: public images without secrets — build-secrets package only in the development entrypoint; API key set by Home Assistant
2026-11-02 V6: flow floor while the heat pump runs (hp_running_min_total_pct)
    - New heat-pump setting (0 = off): while Touch reports the heat pump running
    or about to start, closed loops that are not overheated reopen to the trim
    floor, nearest their target first, until the manifold's total opening is at
    least the setting. Keeps the secondary flow above the primary with a parallel
    buffer, so the buffer does not short-circuit.
    - keep_running_flow in control_mode_policy (tests).
    - Control config v5 with v4 -> v5 migration (settings preserved; schema test).
    - Setting in Heat pump limits, API, state, backup, manual.
2026-11-02 V6: dynamic balancing replaces the layered heat-pump law
    Heat-pump mode now works like a statically balanced manifold whose balancing
    valves follow the rooms (docs/dynamic_balancing.md):
    - every loop has flow; its share is the design share (static prior x learned
    correction x Touch house balance) times a load factor from the room's error
    (1 a band below target, 0.25 at target + overheat margin)
    - the most demanding loop opens fully; inside the manifold warm rooms hand
    their flow to cold ones; the manifold's total follows its most demanding room
    - a loop closes only past target + band + margin (0.3 C hysteresis); never all
    - heat demand for Touch: raise after 20 min with a room in deman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
2026-11-02 Dynamic balancing: per-loop valve curve (flow starts / full flow), default 8 % / 40 %; POST /zones/{n}/valve-curve, stored in its own NVS key
2026-11-02 V6: valve test hold for Touch's valve-curve measurement (POST /valve-test, /valve-test/stop); valve curves stored with when they were measured
2026-11-02 V6: report each loop's flow (flow_pct, % of full via the valve curve) and show flow in the UI with the pin's travel as text; heat-pump deadband in flow, so steep curves still move the valve
2026-11-03 V6: default valve curve 15 → 50 % from the 12 measured loops (wide: a start too low leaves a loop without flow, a full point too low starves the index loop)
2026-11-03 V6: «Min. total opening» is dimmed in heat-pump mode and says it applies to normal mode only; the manifold sheet's status says flow
2026-11-03 V6 UI: a refused probe says which probe and who holds it (probe_conflict) instead of «check the connection»
2026-11-03 V6 UI: manifold settings (valve type, probes, layout) move to the manifold sheet; System › Motors; strip tile and Home heading say Manifold; live readings name each probe's role; zone cards show the 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
2026-11-03 V6 UI: System › Motors shows again (category id); probe roles as a pill beside the probe
2026-11-03 V6 Motor lab (dev builds): arm, seat, opening and closing stroke and timed moves; live board from /diagnostics; whole-stroke current trace merged from the device ring with phases, cadence and slope l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
2026-11-03 V6 Motor lab: end-stop explorer (replay of the latest stroke or the reference trace through the trip paths, live with the threshold form), threshold tuning with save, suggested factor, and the zone's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
2026-11-03 V6: a zone without an area (new default 0 = not set) counts with the mean area of the board's other zones and raises «area not set»; valve curves store each loop's measured full flow (full_lmin, curv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
2026-11-03 V6 UI: the zone sheet shows the learned valve curve (with the loop's full flow) once Touch has measured it
2026-11-03 V6: design shares from Touch's measured loop flow (UA / full flow) once every loop is measured; zones report balance_basis
2026-11-04 V6: the absorb switch also blocks Touch's per-zone charges and shows its own state (simple preheat is always on)
2026-11-05 V6: remove the simple preheat switch remnants (state, API, setting, backup); the stored field stays for the layout
2026-11-05 V6: closed loops' flow goes only to rooms at or below target; valve test takes others_pct so Touch measures each loop alone
2026-11-07 V6: heat-pump mode moves heat: an overheated loop reopens with its design share while the supply is 1 K colder than its room and another room is at or below target; zones show heat_moving
2026-11-07 V6: static balance while the heat source is idle (Touch's phase): every loop at its design share, an overheated room stays closed only while the supply is warmer than it
2026-11-07 V6: heat-moving threshold is a setting (hp_heat_move_k, default 0.5 K, «Heat moving» under heat-pump limits); control config v6 migrates v5
2026-11-07 V6: a seat signal well short of a trusted seat is not the seat (spring ramp); seat rise and close step start over, short stalls are jams
2026-11-07 V6: zone sheet shows room physics (heat loss and time constant, calculated / learned / used); zones API adds tau_learned_h
2026-11-07 V6: a motor reversing within 500 ms of its last stop waits out the pause on every path
2026-11-08 V6: heat-pump load law holds a room above target at its own share × load; cold rooms' surplus is not handed to warm rooms
2026-11-08 V6: a learning close may run to 1.25 x its open leg (max 3000); a hint re-home accepts the wall past pin contact as the seat
2026-11-08 V6: a loop asked for full flow opens to its max opening (latched down to 85 %), not to the curve's full point
2026-11-08 V6: full flow opens to 110 % on the measured curve instead of the max opening
2026-11-13 V6: valves controlled by opening (pin position over its learned travel), not flow through pump-measured curves; min 10 % when heating; opening_mm in /zones; curve endpoint, NVS and measured shares re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
2026-11-13 V6: heat source idle turns warm rooms down by their load factor; rooms at or below target keep their share
2026-11-13 V6: mobile sheets keep their close button visible (svh, LDS 2.4.0)
2026-11-13 Dynamic balance: no loop above 1.25 × its share while another is at full flow (short loop took the manifold's rest)
2026-11-13 Adaptive balancing learns loop shares from return ΔT (loops with a configured return probe only); factors in NVS under their own key; ΔT column in the balancing table
2026-11-13 ΔT learning: a zone's probe is its return probe when the room temperature comes from BLE/external (or the role says so), never the manifold's own probes
